University-at-Buffalo-SEDS/DAQ-Board/docs/analog-inputs.md

# Analog input map and testing

Source: `Schematic PDF_[No Variations] (2).pdf`, revision A, sheets 1–3 and
7–10. All exposed inputs below are independent, ground-referenced signals.
The existing load-cell connectors P7/P8 remain MCP CH0/CH1, with unchanged
KG1000/KG50 raw calibration coordinates and gain/filter settings.

## Connector map

| Signal | Connector pin | ADC / MCU pin | Telemetry and zero-based index |
|---|---|---|---|
| SAR_IN1 | P9/3 | ADC4 IN1 / PC0 | DAQ_SAR_VOLTAGES[0] |
| SAR_IN2 | P9/4 | ADC4 IN2 / PC1 | DAQ_SAR_VOLTAGES[1] |
| SAR_IN3 | P3/3 | ADC4 IN3 / PC2 | DAQ_SAR_VOLTAGES[2] |
| SAR_IN4 | P3/4 | ADC4 IN4 / PC3 | DAQ_SAR_VOLTAGES[3] |
| SAR_IN5 | P2/3 | ADC1 IN5 / PA0 | DAQ_SAR_VOLTAGES[4] |
| SAR_IN6 | P2/4 | ADC1 IN6 / PA1 | DAQ_SAR_VOLTAGES[5] |
| SAR_IN7 | P1/3 | ADC1 IN7 / PA2 | DAQ_SAR_VOLTAGES[6] |
| SAR_IN8 | P1/4 | ADC1 IN8 / PA3 | DAQ_SAR_VOLTAGES[7] |
| MCP CH2 | P6/3 | MCP3564R CH2 | DAQ_SDADC_VOLTAGES[0] |
| MCP CH3 | P6/4 | MCP3564R CH3 | DAQ_SDADC_VOLTAGES[1] |
| MCP CH4 | P5/3 | MCP3564R CH4 | DAQ_SDADC_VOLTAGES[2] |
| MCP CH5 | P5/4 | MCP3564R CH5 | DAQ_SDADC_VOLTAGES[3] |
| HVAIN1 | P4/3 | MCP3564R CH6, 10k/1k divider | DAQ_SDADC_VOLTAGES[4] |
| HVAIN2 | P4/4 | MCP3564R CH7, 10k/1k divider | DAQ_SDADC_VOLTAGES[5] |
| ISENSE1_OUT | J7 current path, U3 output | ADC1 IN12 / PA7 | DAQ_CURRENT_SENSE[0] volts, [2] amps |
| ISENSE2_OUT | J8 current path, U4 output | ADC1 IN11 / PA6 | DAQ_CURRENT_SENSE[1] volts, [3] amps |
| VMON | internal R57/R69 | ADC1 IN17 / PB2 | DAQ_POWER_MONITOR[0] ADC volts, [2] VMAIN volts |
| IMON | internal U14/R60/R56 | ADC1 IN16 / PB1 | DAQ_POWER_MONITOR[1] ADC volts, [3] input amps |

Architecture labels call PC2/PC3 ADC1_IN3/4; the same physical pins also support
ADC4_IN3/4, used here with PC0/PC1. P1/P2/P3/P9 use unity-gain buffers, not
pairwise differential measurement. Their pins 1/6 supply +3V3A, pins 2/5 are
GND. P4 pins 1/6 supply +3V3A/+12VA respectively; P5/P6 pins 1/6 supply +VREF_BUF/+3V3A.
These are supply outputs, not analog input pins. Input clamp rails and connector
supply voltages do not specify a calibrated measurement range.

## Nominal conversion and acquisition

STM32 ADC1 uses single-ended 14-bit conversion; ADC4 uses 12-bit conversion.
Both use nominal VDDA=3.3 V. ADC4 explicitly clears the previous channel selection
before each conversion: HAL channel selection is additive, so leaving all four
selected and restarting after the first conversion can repeat IN1.

MCP CH2–5 report ADC-pin volts (`code * 2.4 / 8388608`); CH6/7 report connector
volts after multiplying by 11. No load-cell thermal compensation, smoothing or
mass calibration is applied to these channels. Raw SD records retain ADC-pin
volts and code; their `calibrated_value` column contains nominal connector volts.

TMCS1108A1B estimates use `(Vout - 3.3/2) / 0.05` amperes. PC5 drives Q1's gate
low to power both sensors. VMAIN uses `VMON * 11`. LM74202 input current uses
`IMON / (78.28e-6 * 6200)` amperes; below about 50 mA the monitor offset dominates.
These estimates require hardware validation/calibration; output volts are also
provided so later sensor calibration does not require changing the driver.
See [TI TMCS1108-Q1](https://www.ti.com/lit/gpn/TMCS1108-Q1),
[TI LM74202-Q1](https://www.ti.com/lit/ds/symlink/lm74202-q1.pdf), and
[STM32U585 pin mapping](https://www.st.com/resource/en/datasheet/stm32u585zi.pdf).
The old ADC1 code incorrectly subtracted SAR5–6, SAR7–8 and ISENSE2–1 and
misidentified them as supply voltage/current and auxiliary voltage. Old readings
of those diagnostic fields are not comparable to the corrected measurements.

Internal ADC inputs are sampled once per `DAQ_ANALOG_REPORT_PERIOD_MS` (100 ms),
not on every 2 ms load-cell service iteration. Per-channel read failure produces
NaN and does not prevent the other inputs or external ADC queue from being read.
The current sensor's unconnected *current path* should nominally report near
zero amps; open voltage inputs may float and are not detected as disconnected.

MCP CH0/CH1 and the assigned chamber input (default CH6) form the normal scan.
Every 100 ms, a bounded CH2–7 pass excludes that fast pressure channel, uses the
same reference, gain, clock and OSR, then restores the normal scan. Temperature has a
separate, higher-priority slow-clock measurement. The auxiliary pass shares
conversion time with load cells; their achieved rate must be measured again.
A 25 ms auxiliary timeout restores the normal scan if a conversion is missing.
`MCP3564R_AUX_SCAN` in `mcp3564r_board_config.h` can mask individual CH2–7 inputs
or be zero to disable the auxiliary pass. Unread/stale fields report NaN after
300 ms. The unchanged load-cell raw encoding preserves saved calibrations.

Each drained MCP sample is offered to SD with its channel and original timestamp:
CH0 `mcp3564r_raw`, CH1 `kg50_raw`, CH2–7 `mcp3564r_chN_raw`. Internal analog
voltage/current rows are captured at 10 Hz. A bounded, time-sliced worker
publishes analog telemetry and formats these rows with the original capture
timestamp, outside the load-cell acquisition loop. `g_daq_analog_work_drop_count`
counts snapshots rejected if all three worker slots are occupied. The worker
shares the acquisition/SD priority with a 1 ms slice, so a continuously busy SD
writer cannot starve analog reporting. Queue/write diagnostics
still determine whether storage kept up; this feature does not establish a
lossless 12 kHz recording qualification.

### SD backlog policy

The writer retains the same thirteen CSV fields and nine-digit binary32 values.
Its raw formatter avoids general `snprintf`, caches unchanged temperature text,
and reuses identical raw/calibrated text. No sample times or measurements are
cached in place of newer samples.

Small acquisition batches append into a queued thirty-two-record tail only when
calibration, launch session and route epoch match. The writer atomically takes
ownership before reading a batch; acquisition cannot modify that batch afterward.
Every record retains its raw code, captured clock, sequence and calibration.

When more than 256 accepted raw records remain unwritten (roughly 100 ms at the
observed acquisition rate), or raw free space falls below 25%, optional ADC
channels are shed before the
loadcells (CH0, CH1/P6 CH9) or configured chamber-pressure channel. Optional
telemetry is also shed before formatting if raw storage is pressured or less
than 75% of its row pool remains free. Loadcell mirrors, including the selected
P6 input, bypass this optional gate. The separate valve-pressure queue holds
800 samples, 3.2 seconds at 250 samples/s. Required numeric telemetry uses
compact batches of captured values and clocks, sharing calibration/session
metadata and expanding to unchanged CSV in the writer. The line pool is 49 KiB;
the reclaimed RAM funds a 321 KiB raw pool (62 and 332 KiB before 24 KiB moved to
sector-aligned log staging; see sd-write-path.md). Larger raw allocations retain the
original sixteen-record service turn so other SD streams are not starved.

Native queue tests save all 50,000 protected raw samples at 2,500 samples/s
and all 13,000 numeric telemetry rows at 500 rows/s through three-second stalls
12 seconds apart, with unstalled drain capacities of 3,500 and 1,000 rows/s
respectively. These tests verify finite burst reserve, not unlimited card
throughput; sustained production above drain capacity still exhausts RAM.
Physical card qualification must independently show zero protected drops.

`g_sd_raw_essential_records_dropped` and
`g_sd_essential_telemetry_dropped` must remain zero during qualification.
`g_sd_raw_optional_records_dropped` and `g_sd_optional_telemetry_dropped`
identify optional shedding, while `g_sd_raw_records_coalesced` shows batching.
Card errors and outages can still exhaust finite buffers; written/flushed/drop
counters distinguish acquisition admission from durable media completion.

Contiguous FAT preallocation is **off by default** in
`Core/Inc/sd_storage_config.h` (`DAQ_SD_PREALLOCATE_ENABLE=0`). Hardware
qualification measured a 3.7-second allocation stall and increased protected
sample loss; ordinary FileX writes retain the compact queues and early optional
shedding without that scan. Experimental opt-in uses
`DAQ_SD_PREALLOCATE_ENABLE=1`. In that mode, each open log reserves FAT clusters
in 2 MiB increments, topping up below
256 KiB only while the raw backlog is low, unless the next write already needs
space. File size remains the actual CSV length. The ordinary once-per-second
media flush and both FAT copies remain enabled. A normal close uses
`fx_file_truncate_release` to free the unwritten reserve. An unclean power loss
can leave up to 2.25 MiB of reserved tail per open log, plus cluster rounding,
until filesystem repair;
existing logs are not rewritten or automatically formatted. A fragmented-card
`FX_NO_MORE_SPACE` disables that file's reservation hint and leaves normal writes
enabled. Genuine I/O errors preserve buffered data for retry. Preallocation
attempts/fallbacks/errors and its maximum observed latency have separate counters.
FileX searches for a consecutive FAT chain, so reservation byte size is bounded
but its search time on a nearly full/fragmented card is not a real-time guarantee.

## SD health and explicit retry

DAQ retains the existing `BOARD_HEALTH` v1 static24-word report. A separate
`DAQ_SD_HEALTH` static8-word UInt32 report is queued every five seconds so old
relay schemas do not conflict with a changed message shape.

| Word | Meaning |
| --- | --- |
| 0 | Flags: bit0 services initialized, bit1 ready, bit2 launch logging finished, bit3 manual retry queued/in progress |
| 1 | Age since an actually successful sector-write chunk, milliseconds |
| 2 | Age since an actually successful FileX media flush, milliseconds |
| 3 | SD initialization stage |
| 4 | Initialization retry count |
| 5 | Last accepted manual retry token |
| 6 | Last completed manual retry token |
| 7 | Initialization failure count |

Ages use the extended monotonic HAL millisecond clock, not UTC. `UINT32_MAX`
means no successful write/flush has been observed; very old valid ages saturate
at `UINT32_MAX-1`. Readiness alone is not evidence of writing. Existing raw
written/flushed/drop counters remain in `BOARD_HEALTH`; GroundStation combines
these with fresh companion status and separately marks stale/unavailable health.

`DAQ_SD_RETRY` is a direct static UInt32 command to `SD_CARD` (endpoint100), with
unordered reliable delivery. Its canonical type ID is24116261; companion health
ID is92486907. Only exact `GS`/`RRLS` senders with one nonzero little-endian token
are accepted. The handler performs no I/O: it only queues the token. Repeated
recent tokens are deduplicated (eight-token window); another new token while a
retry is pending/in progress is refused for transport retry. This is not a
managed variable and must never be replayed as saved settings.

The storage writer consumes a retry only between operations. It reinitializes
transport and resumes the same CID/geometry while preserving open FileX state,
pending bytes, launch cutoff and counters. A replacement card is refused.
A manual retry never permits formatting, including subsequent automatic retries
in that boot; invalid or unmarked unmounted media fail closed. Completion means
one initialization attempt finished, **not** that the card is ready or writing.
An unready card can take tens of seconds to finish HAL initialization, while
acquisition and networking continue independently. These paths have host fault
regressions and ARM builds; physical qualification is still required.

## Network and GroundStation

Loadcell report windows and SD mirrors default to **250 records/s each**, with
a 4 ms downsampling window. `Core/Inc/daq_network_config.h` sets an independent
**100-packet/s aggregate live sensor cap** and editable stream weights. Both
loadcells have equal top priority: 40 packets/s each at default weights; the
five auxiliary streams each get 4 packets/s. One latest NETWORK sample per
stream is coalesced between sends. ADC acquisition, raw/calibrated SD records
and loadcell SD mirrors are unchanged. `--network-rate-hz` optionally overrides
the total; normal builds use the header. Heartbeats/ACKs/control/discovery are
outside this sensor scheduler.

`cmake -S . -B build/Release_Script -DDAQ_BROADCAST_RATE_HZ=500` enables an
explicit 500 Hz-per-channel test; use `250` to restore the normal setting.

Loadcell and temperature publication now runs in a separate worker with 16
bounded report slots. Acquisition submits without waiting. Reports retain the
captured values, calibration and time; network timestamps subtract queue age.
`g_daq_report_drop_count` counts rejected work items (which may contain both
loadcells), and `g_daq_report_max_age_ms` records the maximum worker delay.
These counters are independent of raw ADC/SD loss counters. No new hardware
throughput qualification has been performed for this worker.

Append-only SEDSnet IDs (existing IDs unchanged):

| ID | Type | float32 count | Order |
|---|---|---|---|
| 143 | DAQ_SAR_VOLTAGES | 8 | SAR1..8 volts |
| 144 | DAQ_SDADC_VOLTAGES | 6 | CH2,3,4,5,HVAIN1,HVAIN2 volts |
| 145 | DAQ_CURRENT_SENSE | 4 | J7 V, J8 V, J7 A, J8 A |
| 146 | DAQ_POWER_MONITOR | 4 | VMON V, IMON V, VMAIN V, input A |

All four target GroundStation, best-effort at 10 Hz, with explicit DAQ CAN routes.
They add approximately 40 messages/s and 880 payload bytes/s before framing.
GroundStation's matching runtime schema advertises the GROUND_STATION endpoint;
its default, test-fire and HITL layouts have a DAQ analog tab with explicitly
bound DAQ chart series and separate voltage/current axes, including both load cells.
The DAQ publishes its schema at startup; existing gateways merge the new type
definitions at runtime. Routine discovery polling alone does not send schema.
A failed initial announcement is retried once per second until queued successfully;
After discovering a peer, the board also requests its schema once, so restarting
a board does not depend on catching the peer's earlier startup advertisement.
Failed submissions retry at one-second intervals; successful submissions stop
repeating. This is not an acknowledgment that every peer has merged the schema.

Rebuild/reflash DAQ and rebuild/restart GroundStation to activate. The gateway
does not need the new analog definitions compiled in. Confirm the installed bridge's throughput and
unknown-type forwarding during bench testing. For a future sensor, choose its
existing type/index in the layout and add the physical-unit calibration in GS;
changing the fixed payload order requires a coordinated schema update.

Bench check with a known voltage below the input's documented limits, applied
to one input at a time. Verify the matching chart changes independently and its
SD channel label is correct, then test zero/known current on J7/J8 and compare
VMON to a meter. Check acquisition, queue-loss and SD-write counters while all
streams are active; host mocks cannot verify board wiring, reference accuracy,
physical sensor response or real SD/network throughput.

## Validation status

Host tests cover independent channel selection, nominal scaling, auxiliary scan
restore/timeout, stale values, wire/layout mappings and queued snapshot ownership.
The production release/factory build succeeds. The local simulator rebuilt from
FirmwareSimulator `a916318` reports both load-cell streams, 40 analog packets/s,
and no analog-queue, SD-row or raw-batch drops in the two-second diagnostic run.
The unchanged strict zero-overrun check still fails on one startup overrun;
the unchanged baseline firmware has three overruns under the same simulator.
The diagnostic run is not a full-suite qualification: memory/network soak stages
were not reached, and the pinned public v0.4.12 image was unavailable. Bench
validation remains required, especially for ADC accuracy and sustained throughput.

## Selectable P6 50 kg input

GroundStation's 50 kg selector switches between AMP2/P8 (source 0) and P6
pin 3 (+) minus pin 4 (-), MCP differential scan channel 9 (source 1).
The managed `DAQ_KG50_INPUT` UInt8 packet (ID 147) selects the source.
P6 uses CONFIG2=0xEF, PGA **16x**. Since the gain register is shared, its
single-channel scan alternates with CH0 at unity gain; temperature and auxiliary
scans also restore unity gain. Configuration changes run only in the acquisition
thread with DMA idle, followed by the first-conversion settling interval.
The nominal differential full-scale range is +/-2.4/16 = +/-0.15 V.

P6 reports `DAQ_KG50_SELECTED` (ID 148), two Float32 values `[1, volts]`, at
the same 250 Hz reporting target as normal KG50. Input volts divide ADC codes
by 16; queued samples retain this conversion after the gain changes again.
Gain switching costs conversion time, so achieved rates require hardware
measurement. Source tags let GroundStation reject late packets from another
input. The 1000 kg raw coordinate and saved calibration are unchanged.

GroundStation keeps separate mass/temperature/filter profiles for P8 and P6.
A new P6 profile needs zero/span calibration before it produces kilograms.
SD retains every queued differential conversion as `mcp3564r_ch2_ch3_gain 16_raw`,
including signed ADC code and unfiltered differential input volts; these records
are not converted with the AMP2 calibration. P6 mass calibration is applied by
GroundStation. Auxiliary CH2/CH3 voltage reports remain separate, slow channels.

Gain and scan mapping: Microchip MCP3561/2/4R DS20006391C, CONFIG2 register 8-4
and ADC channel selection table 5-15.
