University-at-Buffalo-SEDS/DAQ-Board/Schematic PDF_[No Variations] (2).pdf

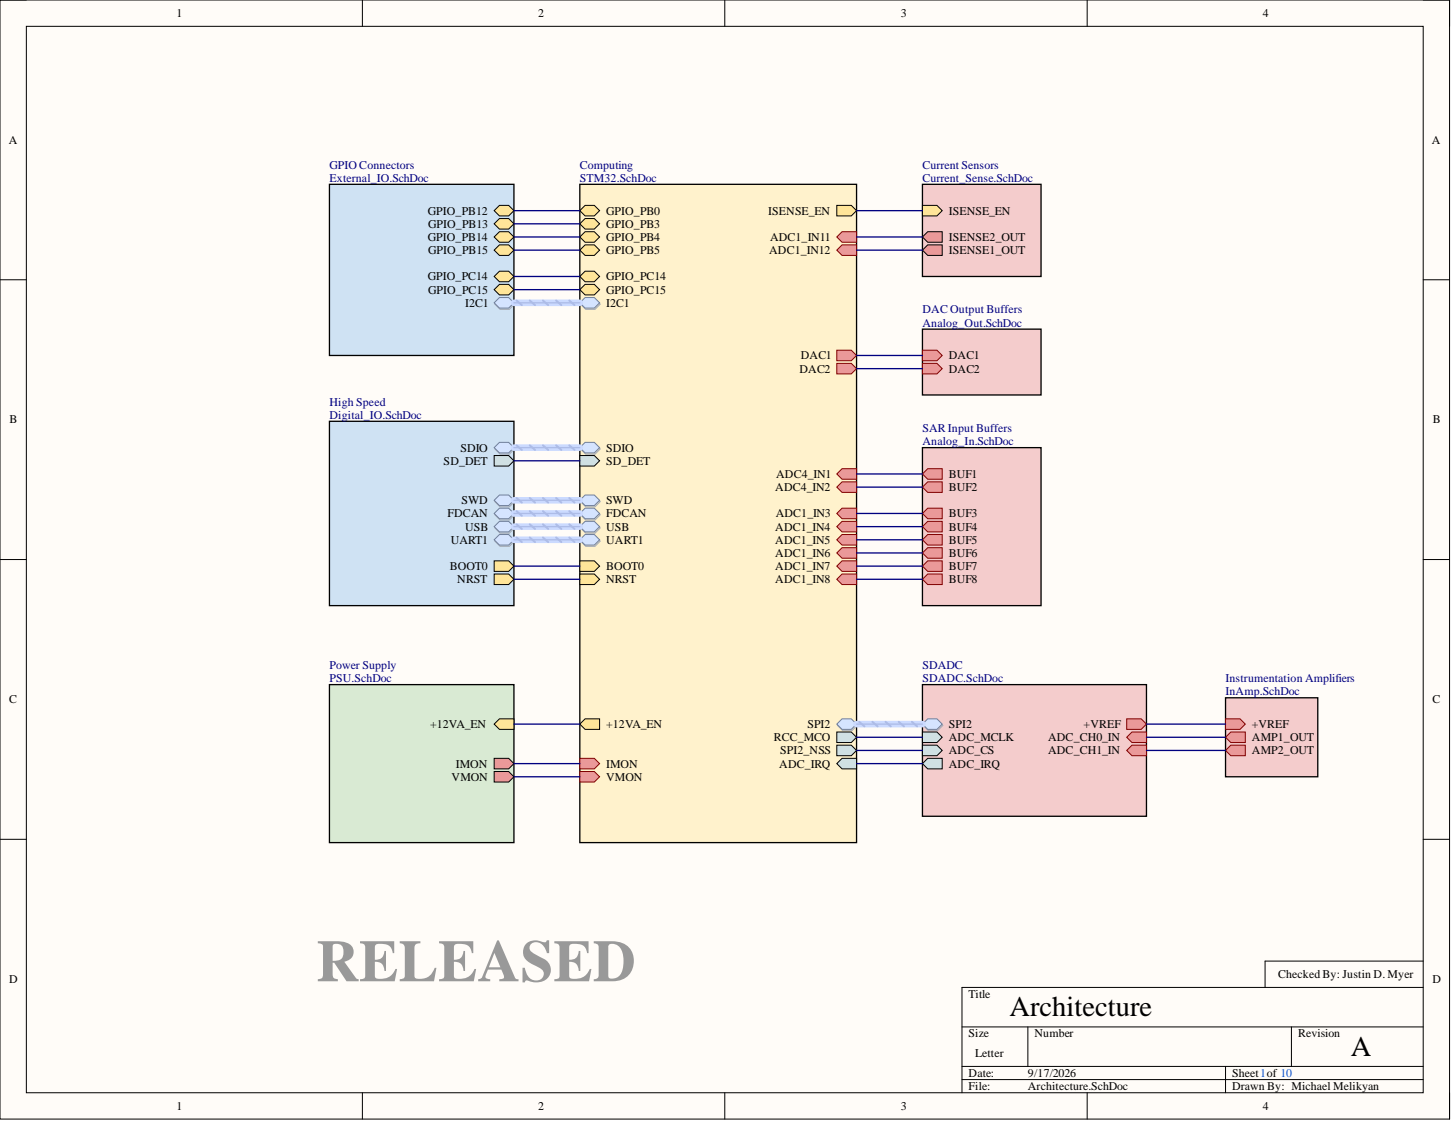
[picture p1: page 1]
Date:; Sheet of; File:; Architecture.SchDoc; Drawn By:; Instrumentation Amplifiers; Current Sensors; High Speed; Power Supply; GPIO Connectors; Michael Melikyan

DAC Output Buffers
Analog_Out.SchDoc

SAR Input Buffers
Analog_In.SchDoc

Checked By: Justin D. Myer

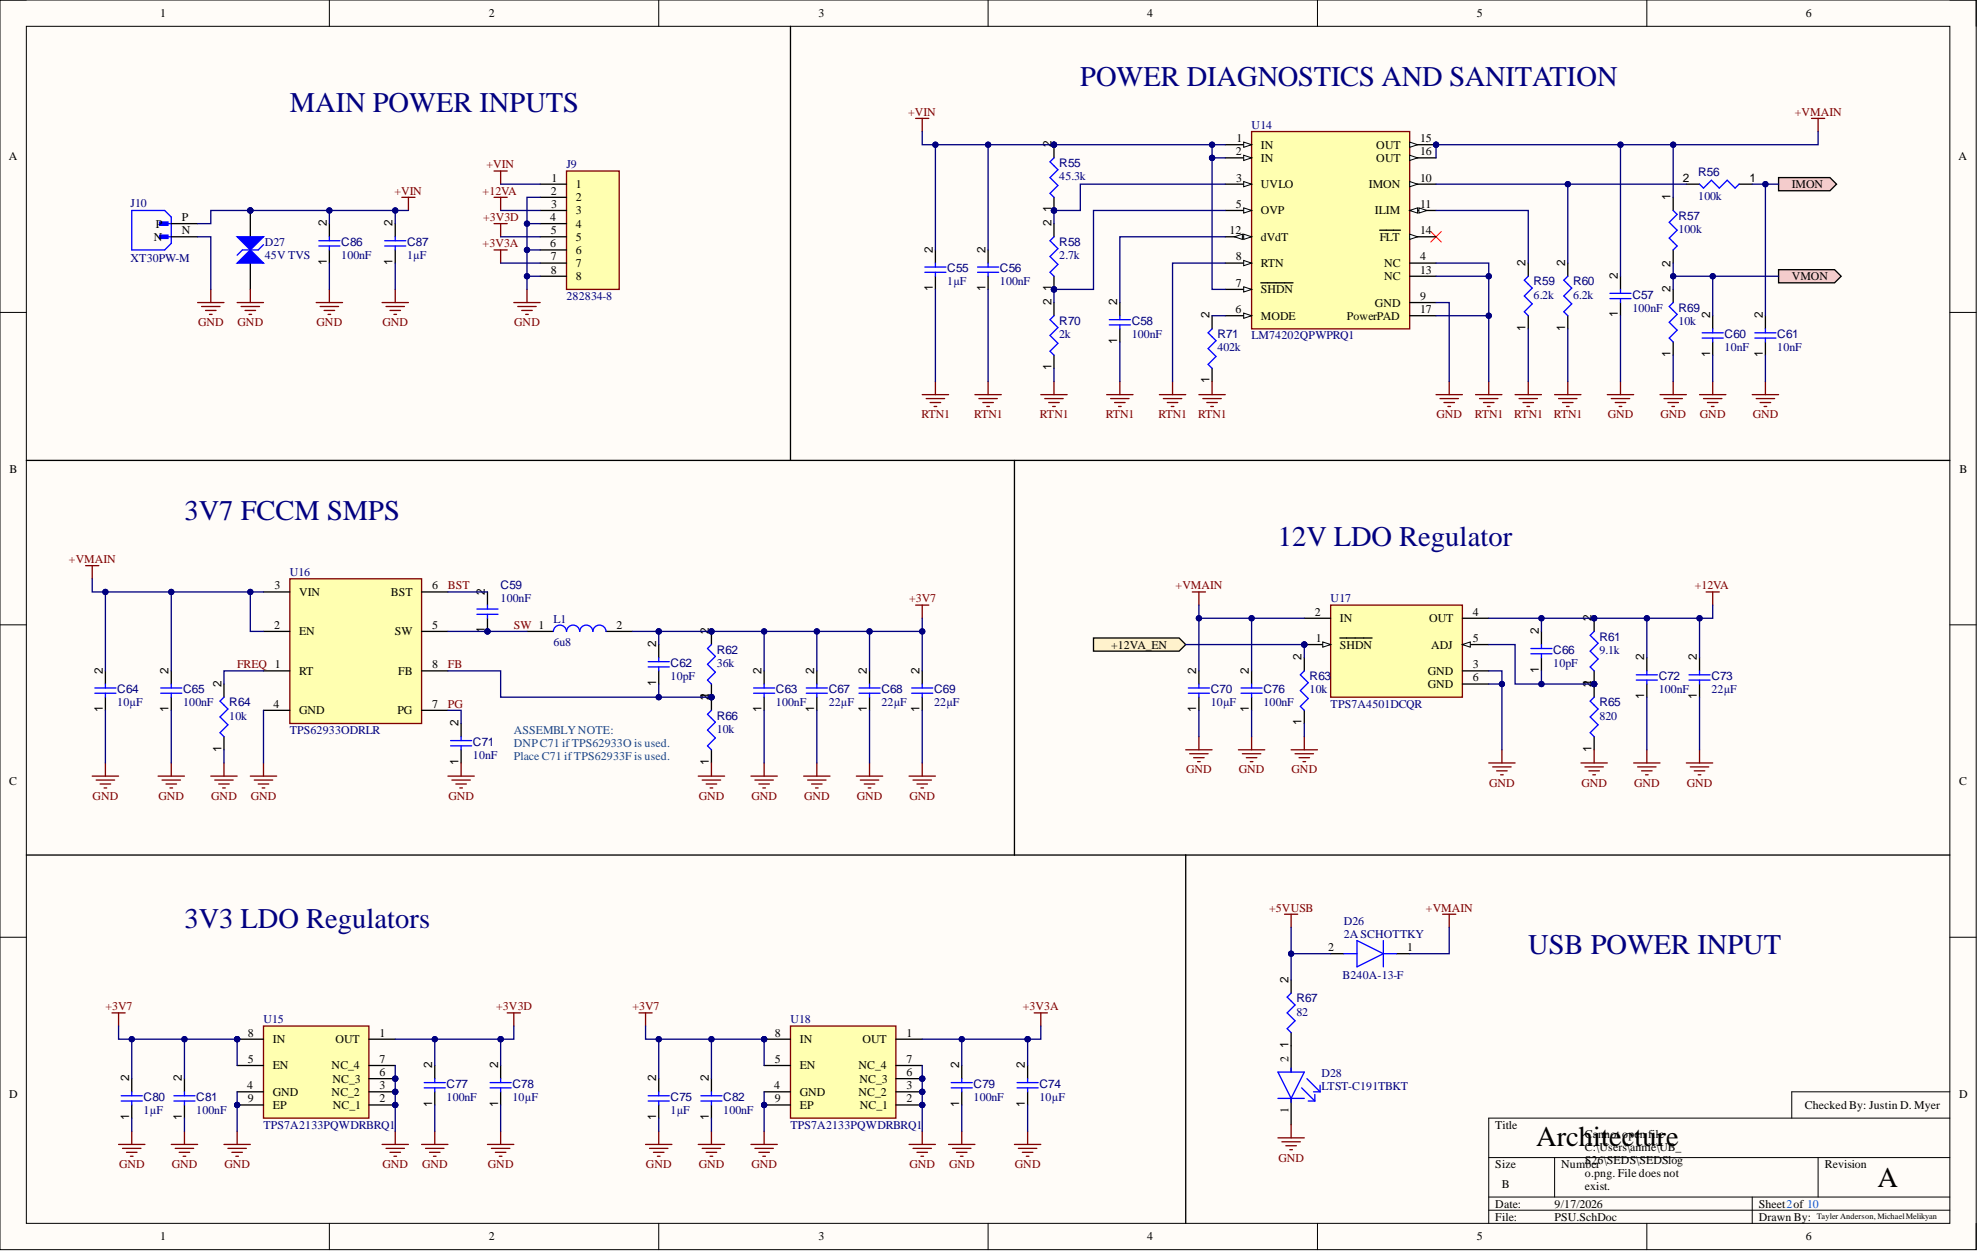
[picture p2: page 2]

POWER DIAGNOSTICS AND SANITATION

GND 4 | 10pF

ASSEMBLY NOTE:
DNPC71 if TPS62933O is used.
Place C71 if TPS62933F is used.

Checked By: Justin D. Myer

Cannot open file
C:\Users\annie\UB_
S26\SEDS\SEDSlog
o.png. File does not
exist.

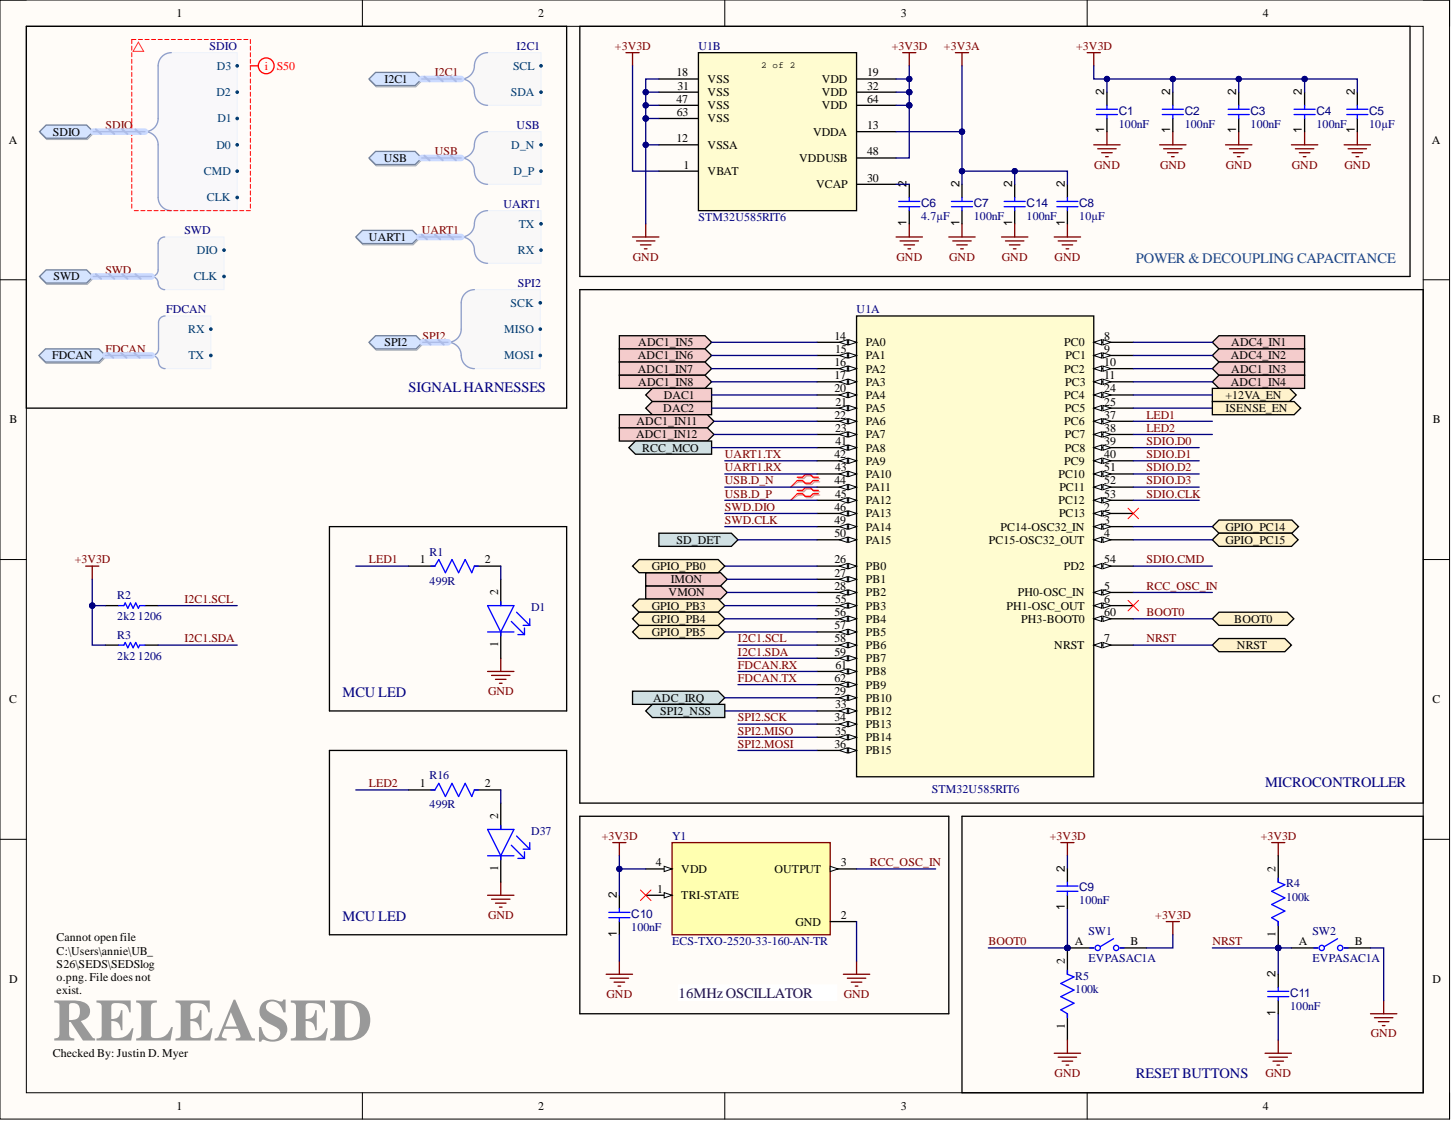
[picture p3: page 3]

4 7 | 6 4
6 3 | 1 3

RELEASED Checked By: Justin D. Myer

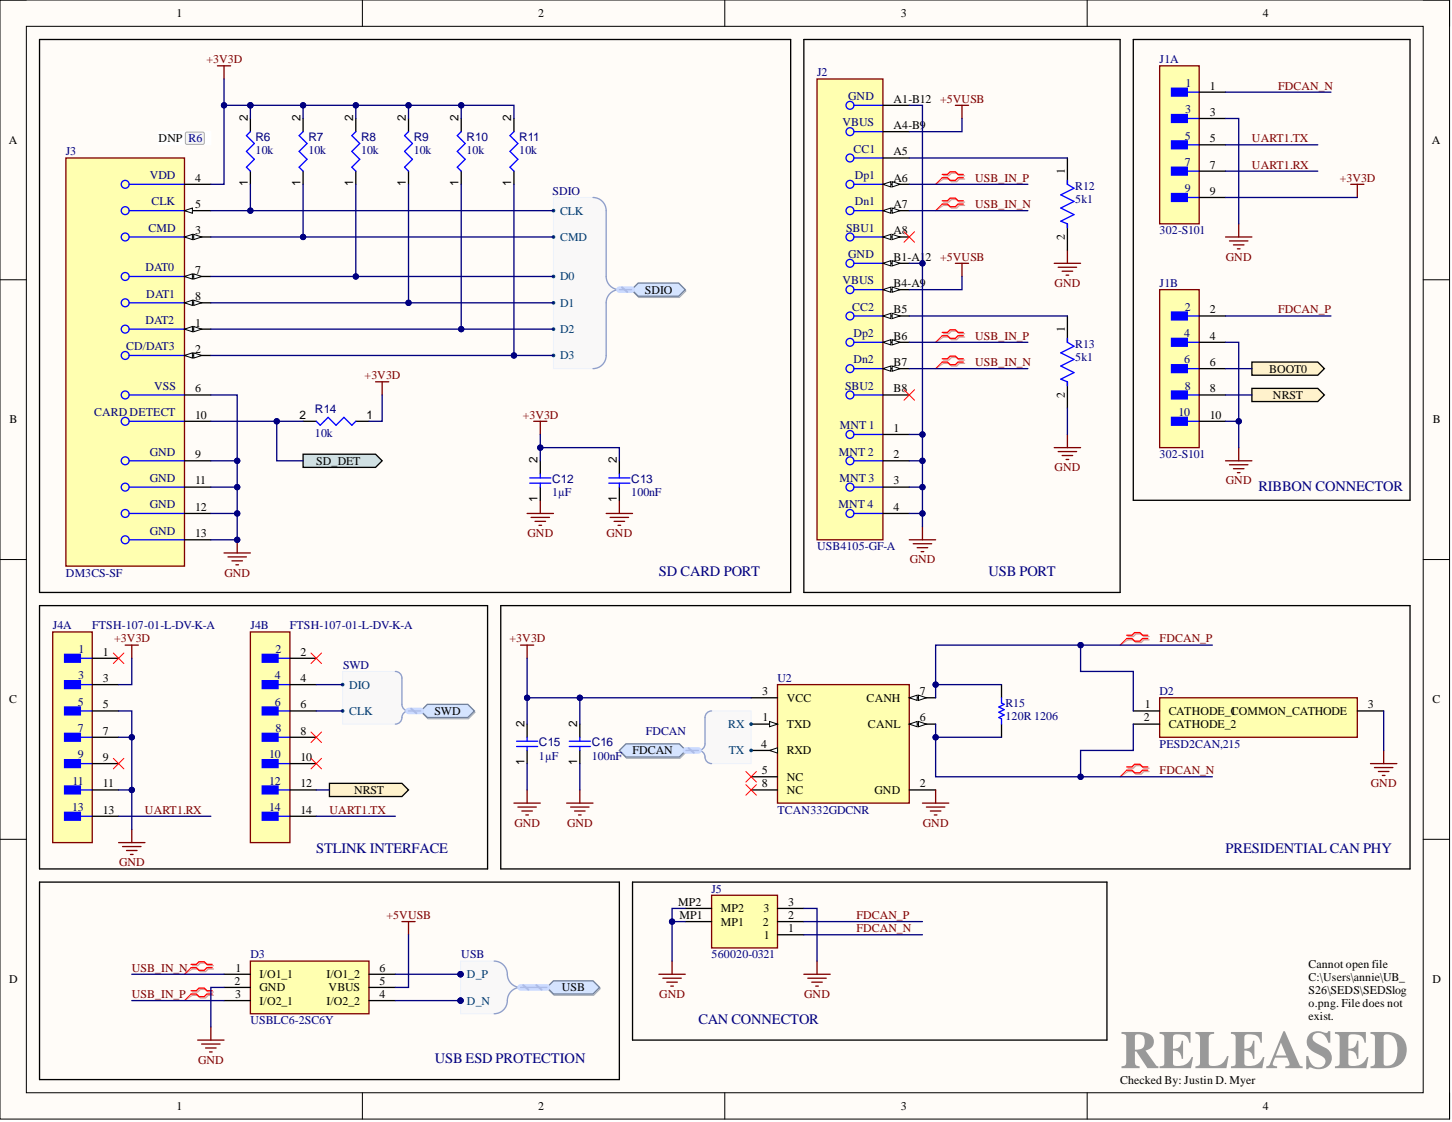
[picture p4: page 4]

Cannot open file
C:\Users\annie\UB_
S26\SEDS\SEDSlog
o.png. File does not
exist.

RELEASED Checked By: Justin D. Myer

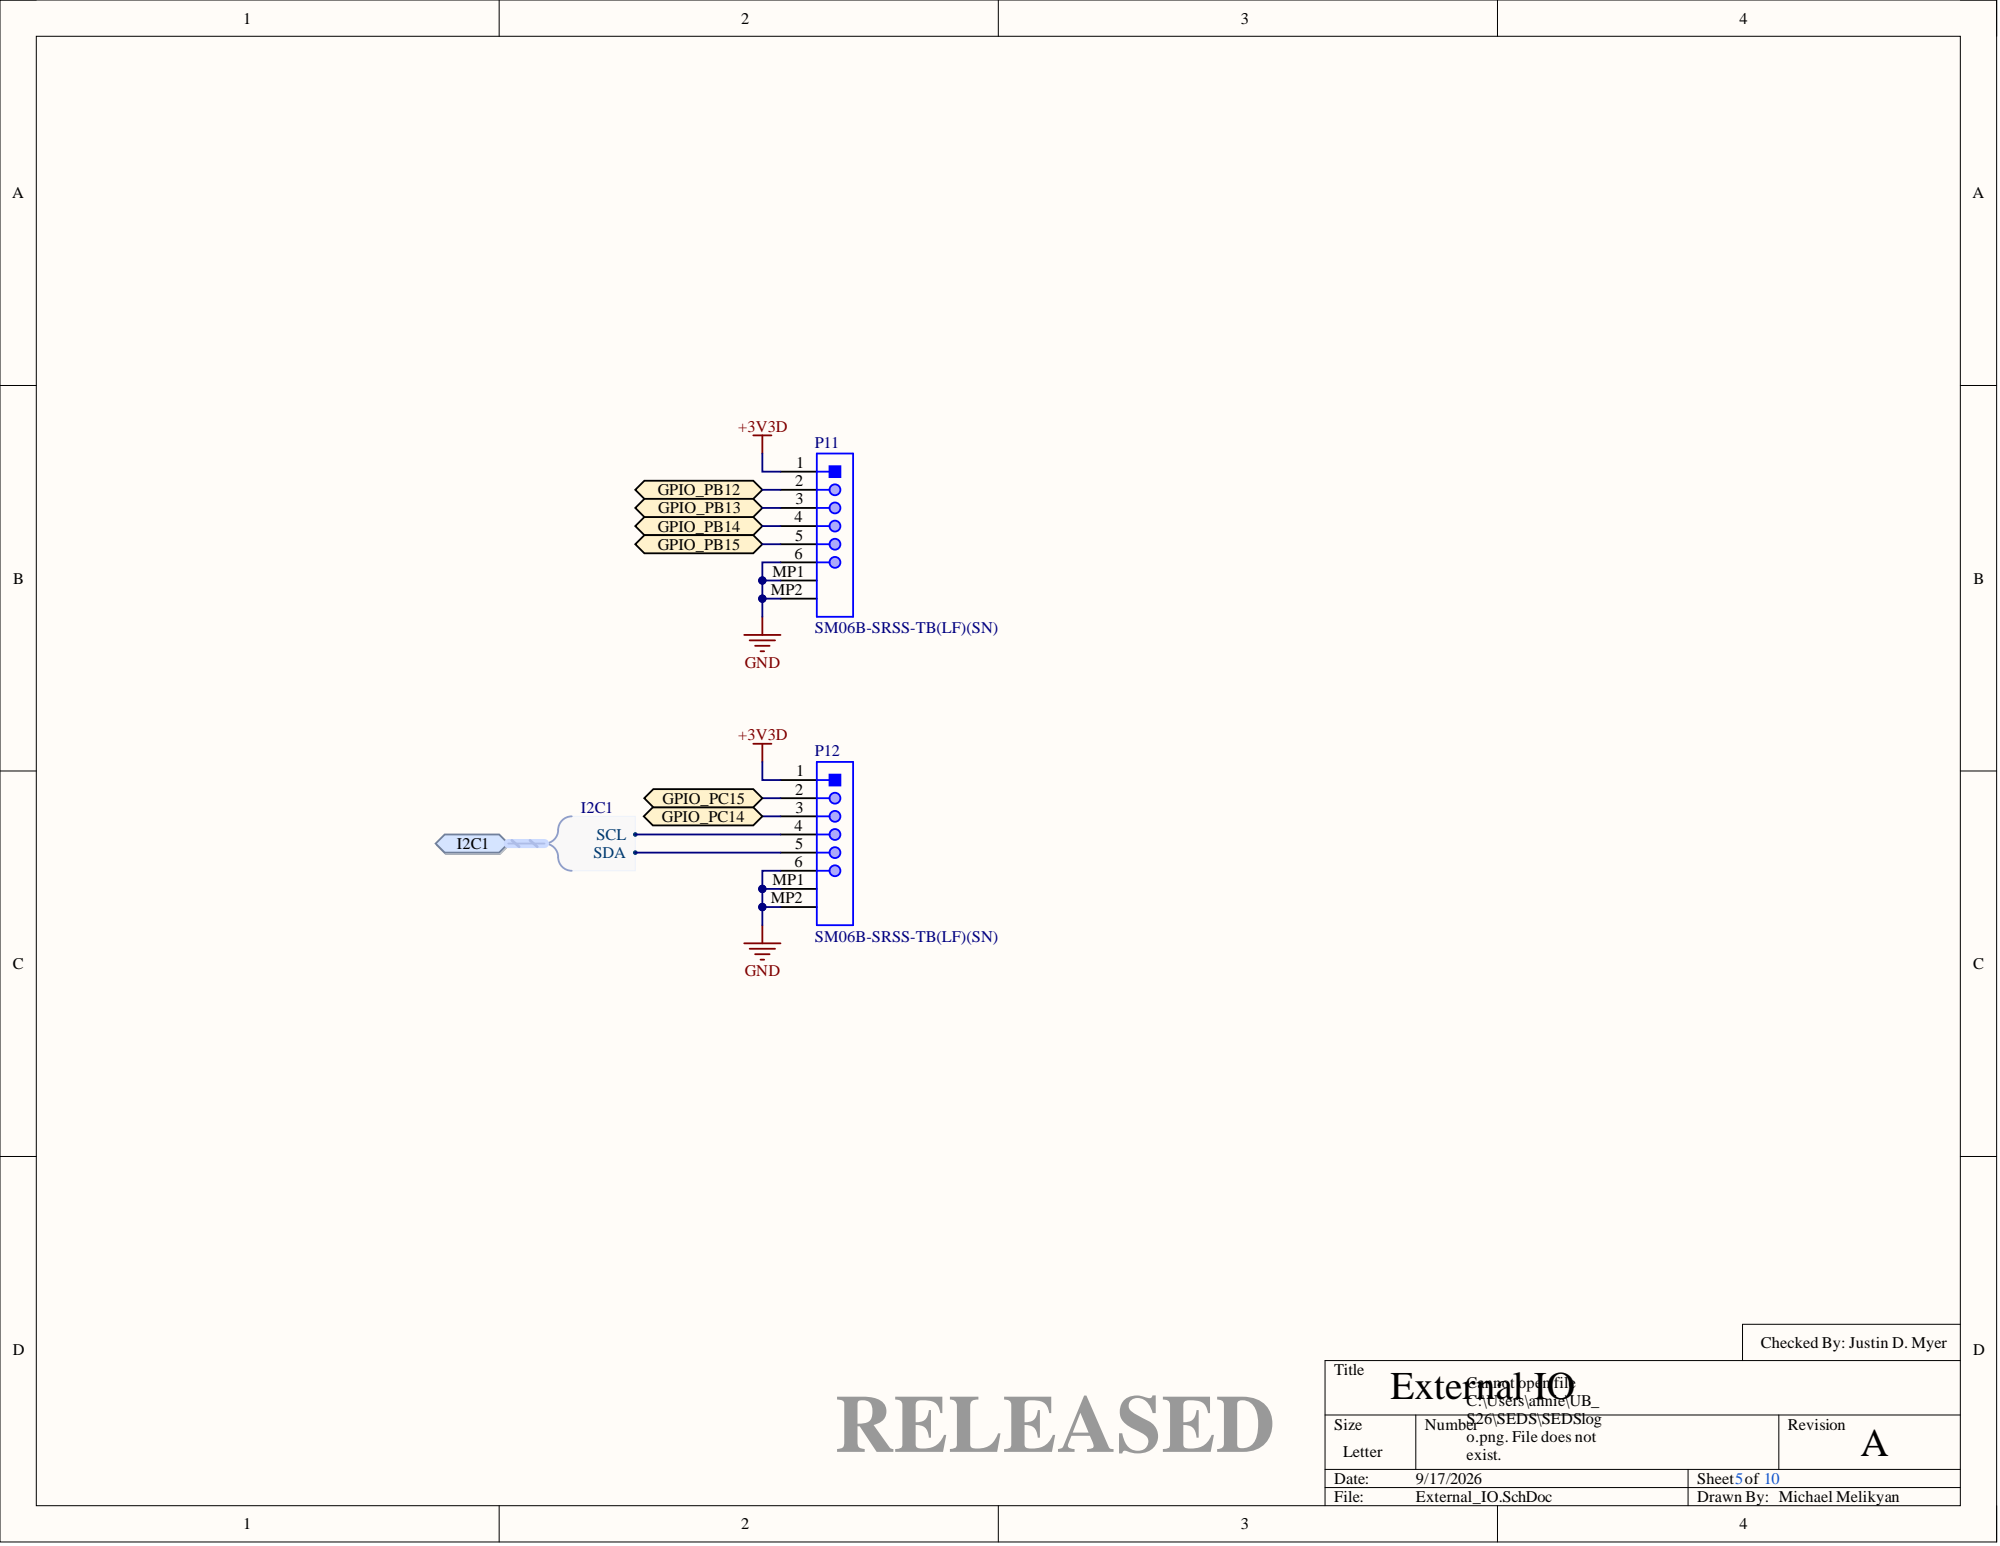
[picture p5: page 5]
File:; External_IO.SchDoc; Drawn By:; External IO; Michael Melikyan; POGPIO0PB12 PIP1102 POGPIO0PB13 PIP1103 POGPIO0PB14 PIP1104 POGPIO0PB15 PIP1105; POGPIO0PC14 PIP1203; POGPIO0PC15 PIP1202; POI2C1OI2C10SCL POI2C10SDA

MP1 | PIP110MP1
MP2

PIP110MP2
SM06B-SRSS-TB(LF)(SN)

MP1 | PIP120MP1

PIP120MP2

Checked By: Justin D. Myer

Cannot open file
C:\Users\annie\UB_

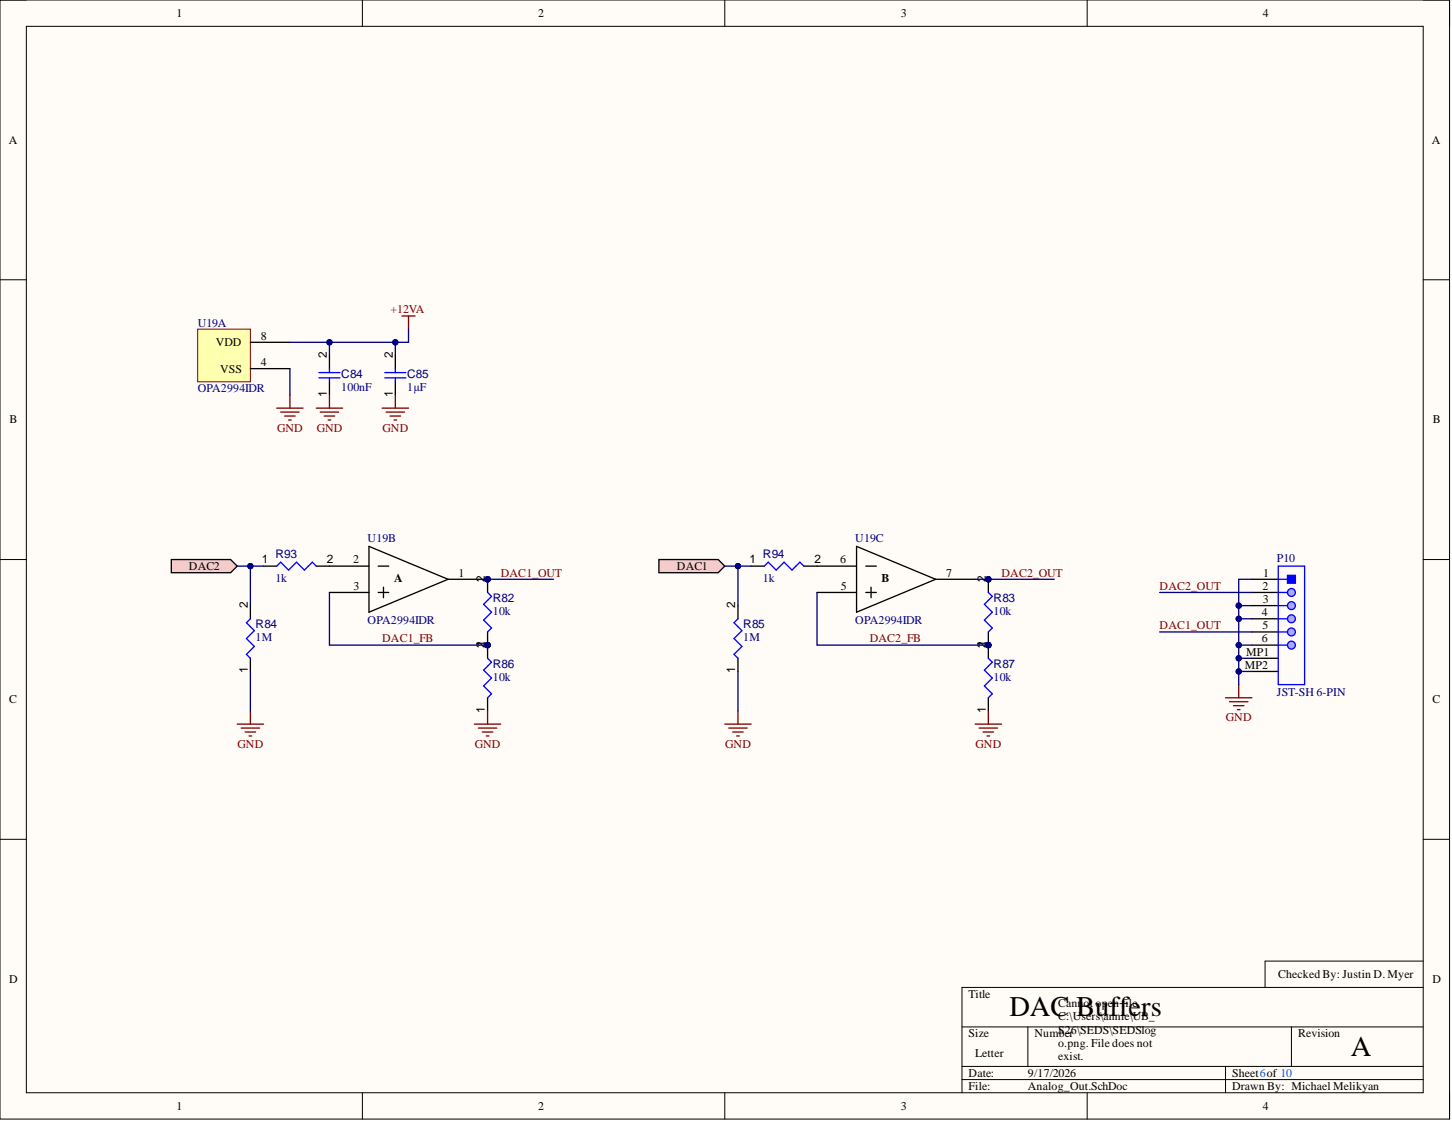
[picture p6: page 6]

Checked By: Justin D. Myer

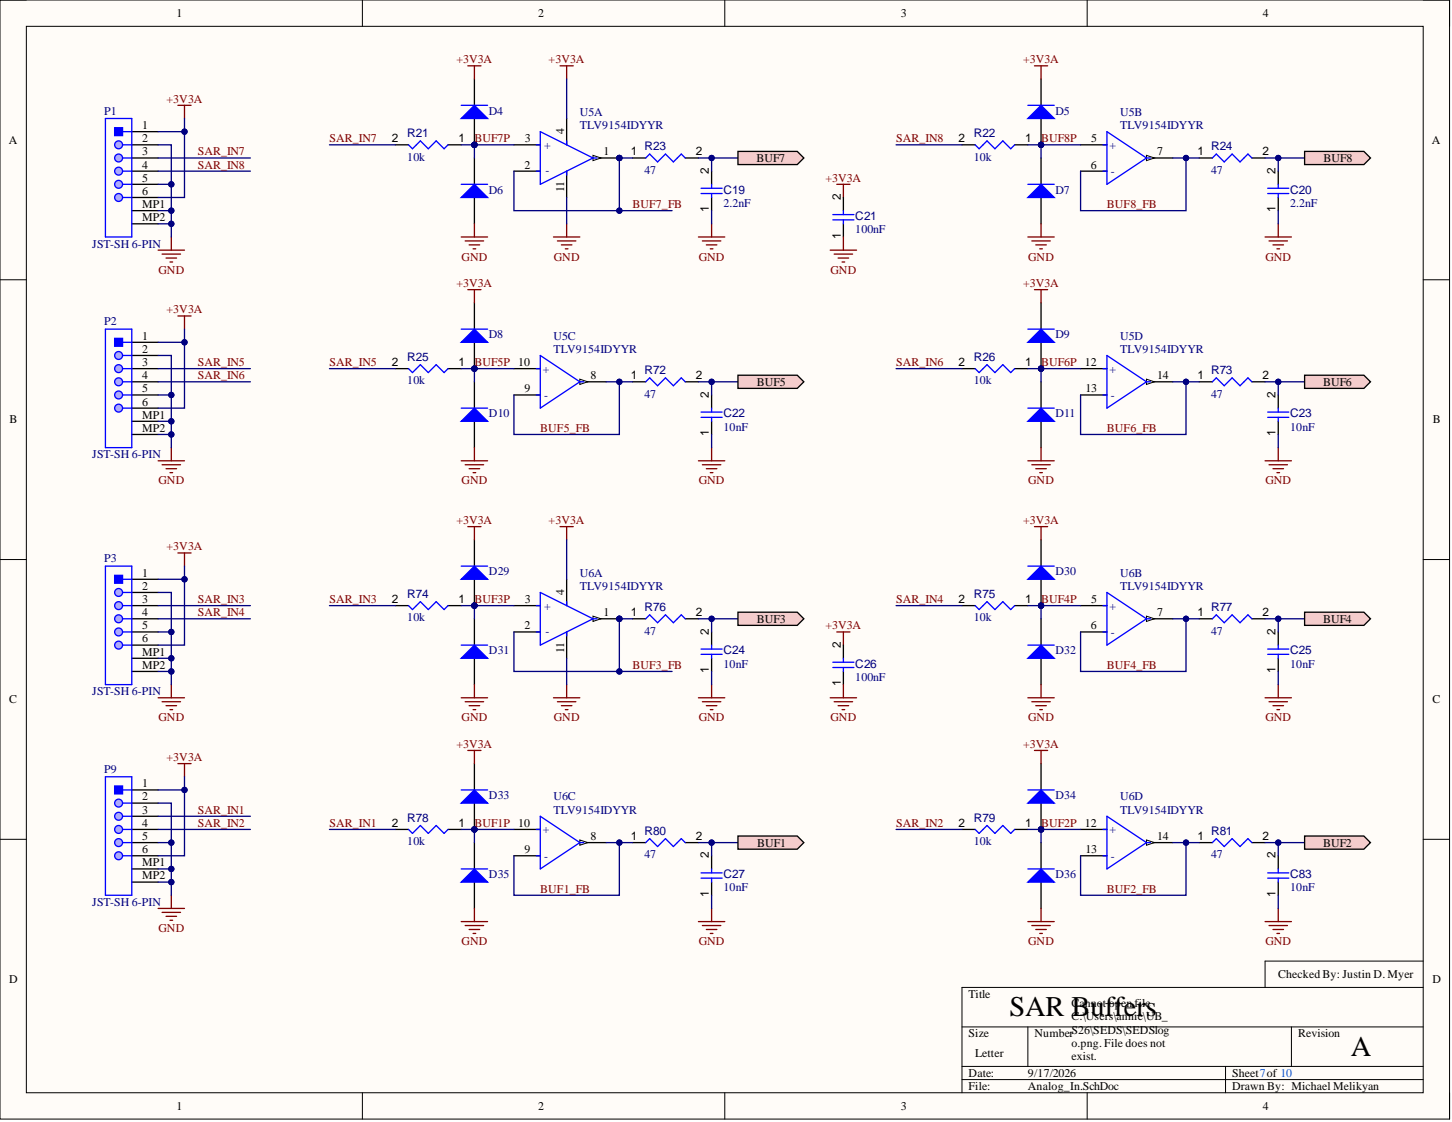
[picture p7: page 7]
9 SAR_IN1; SAR Buffers; Michael Mel; Checked By; D. Myer; pen fi

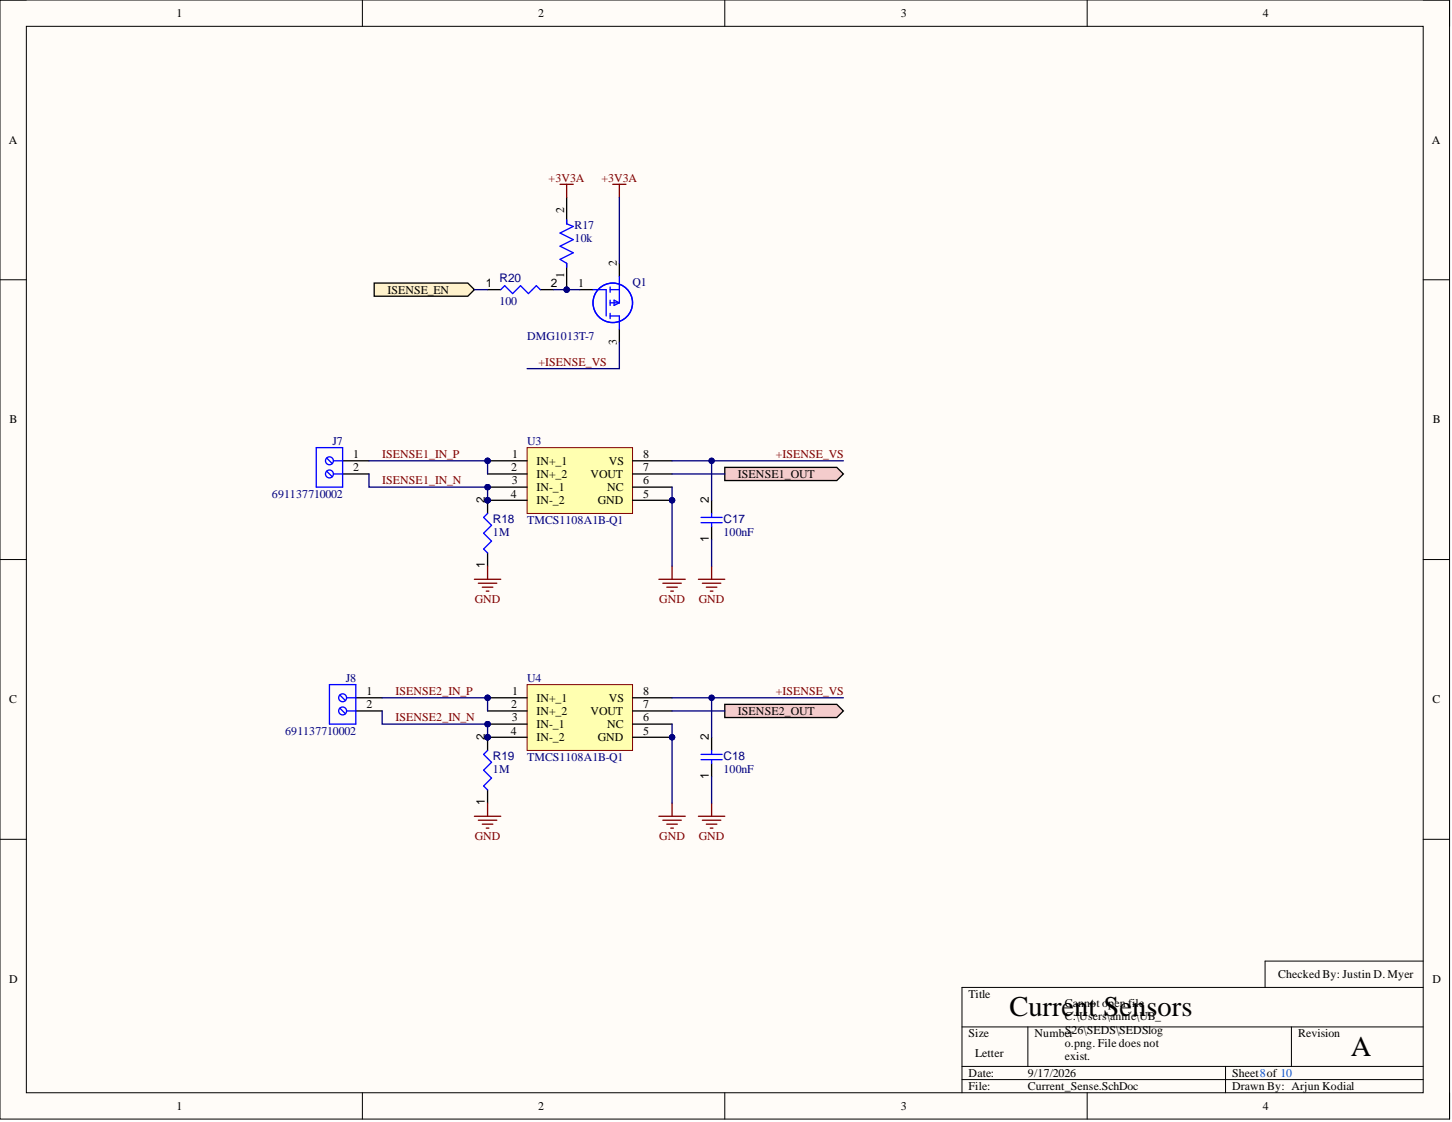
[picture p8: page 8]

2 | | IN+_2 2
ISENSE2_IN_N | IN-_1 3

Checked By: Justin D. Myer

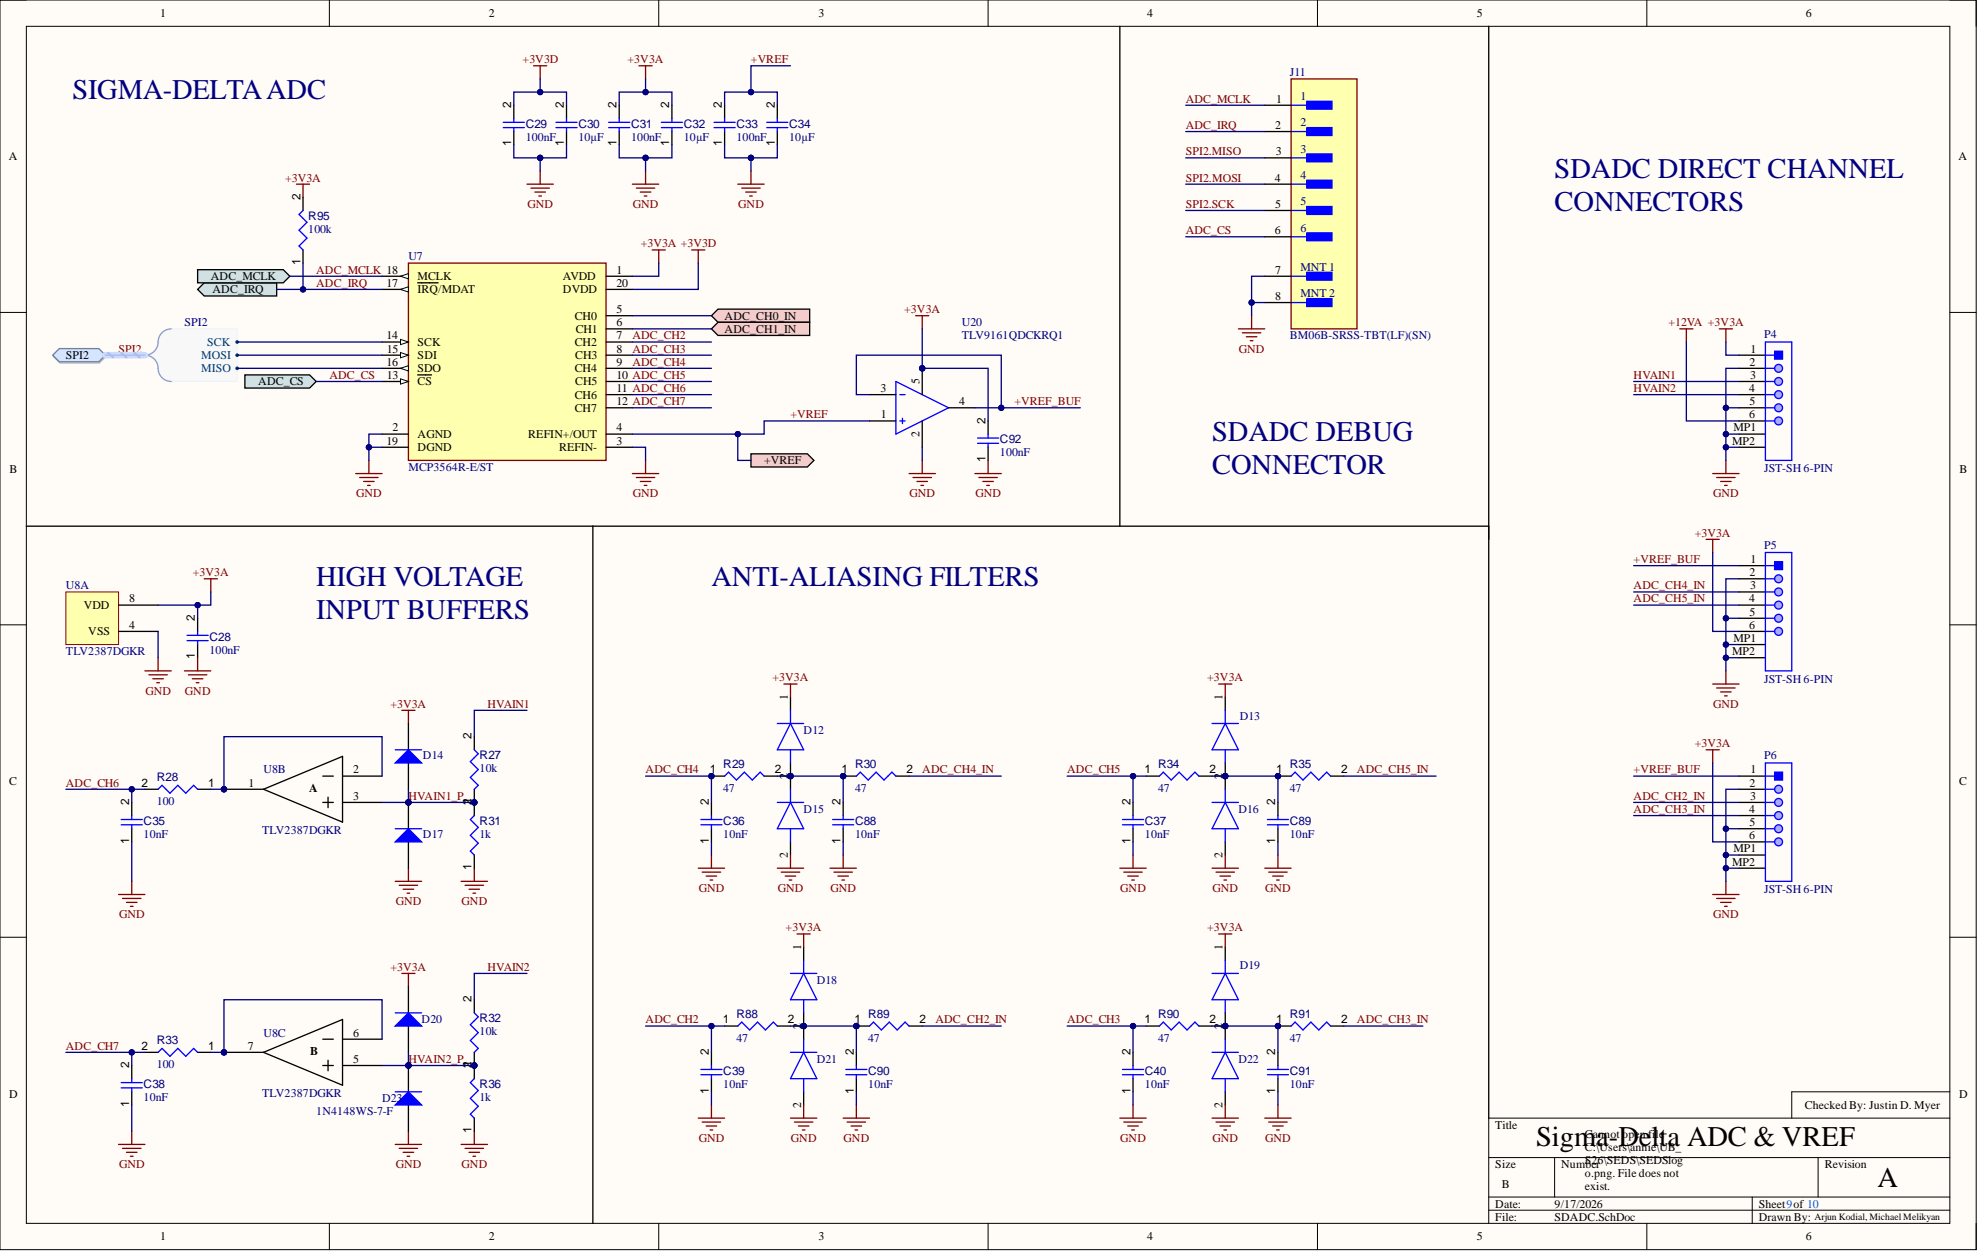
[picture p9: page 9]

BM06B-SRSS-TBT(LF)(SN)

MP1

MP2

Checked By: Justin D. Myer

Title
Sigma-Delta ADC & VREF

Arjun Kodial, Michael Melikyan

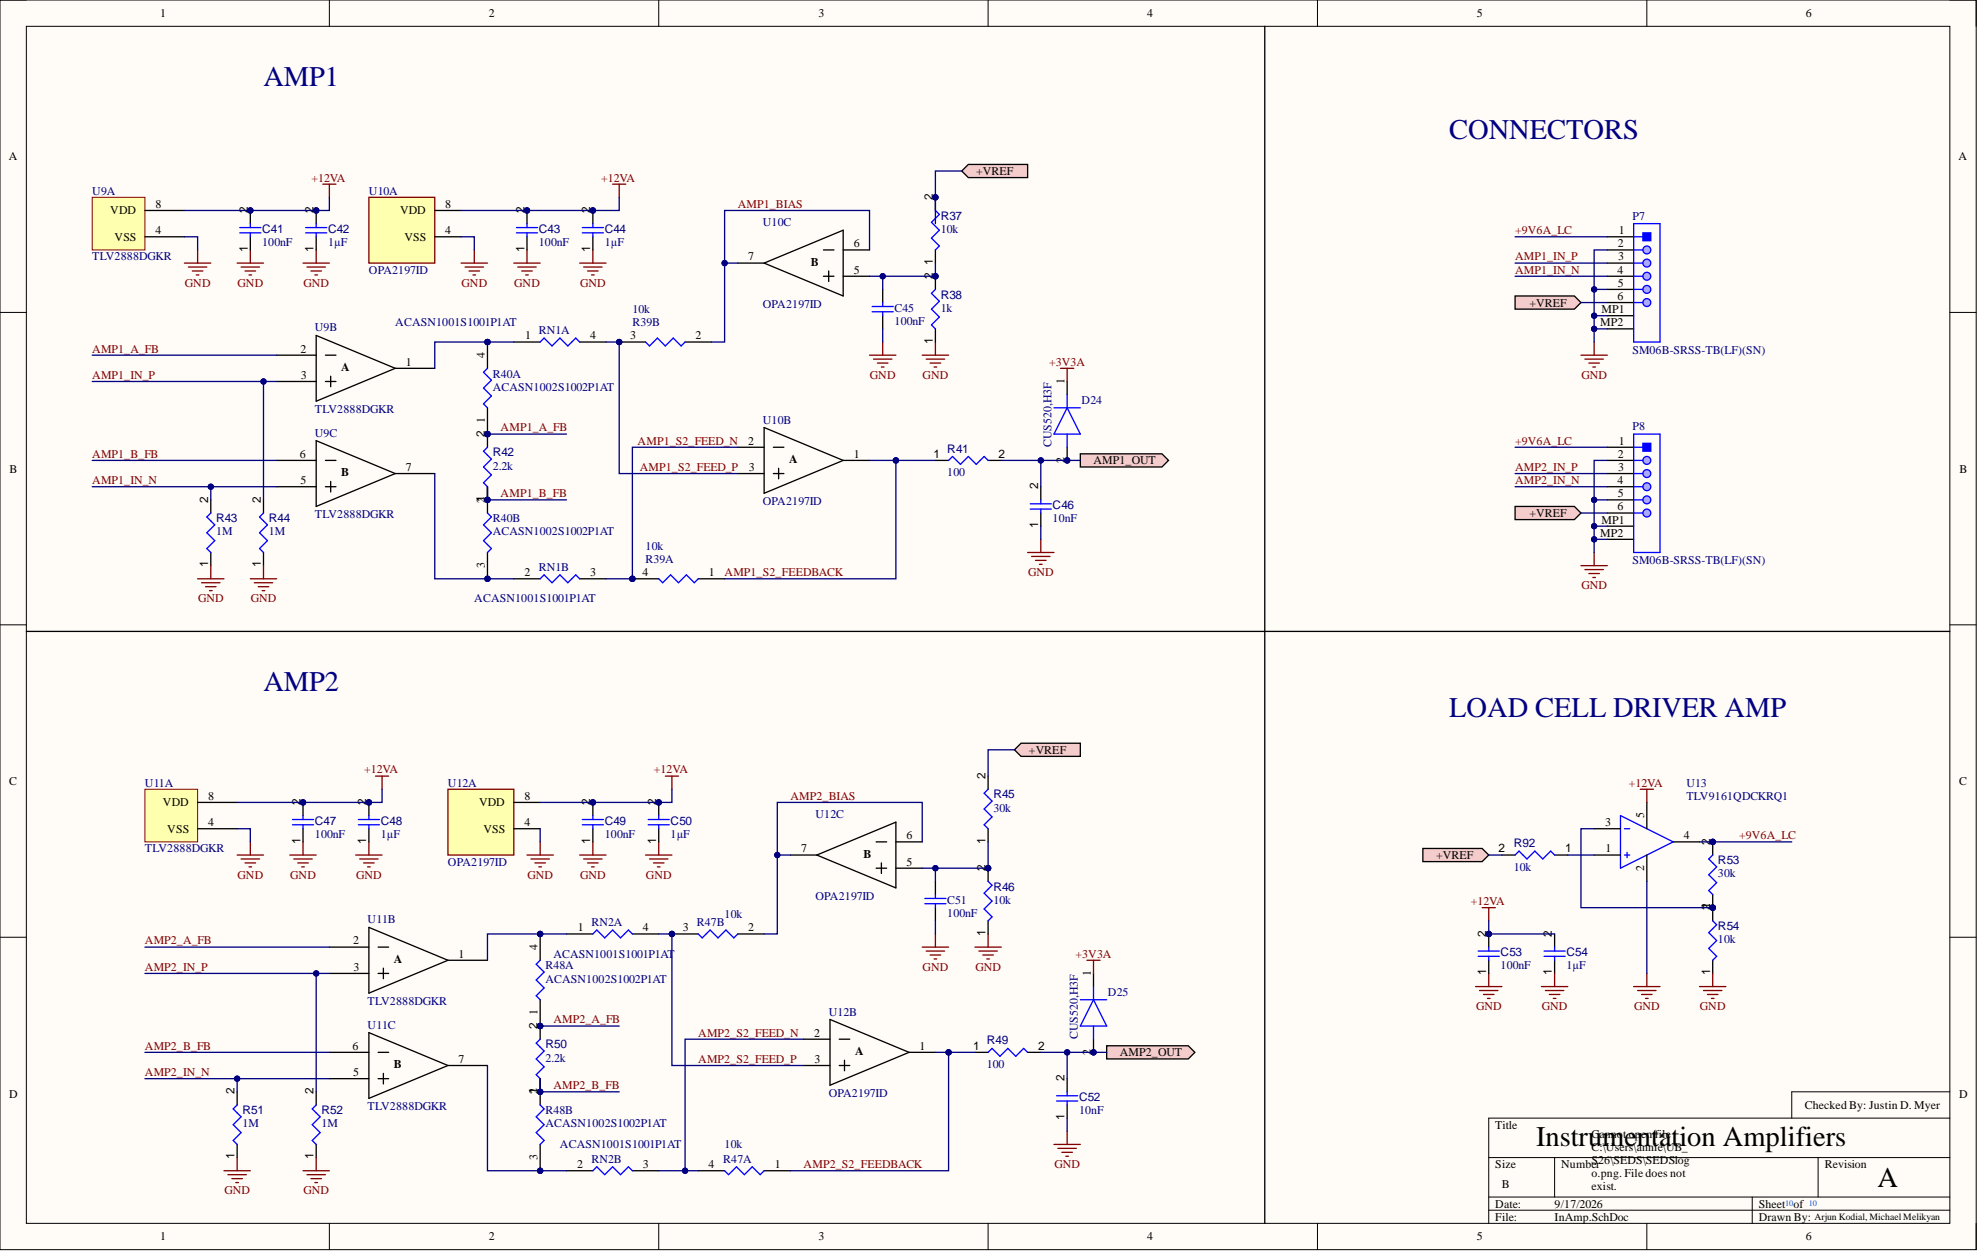
[picture p10: page 10]

MP1
MP2

SM06B-SRSS-TB(LF)(SN)

LOAD CELL DRIVER AMP

AMP2_S2_FEED_P

Checked By: Justin D. Myer

Arjun Kodial, Michael Melikyan
