University-at-Buffalo-SEDS/DAQ-Board/Core/Src/main.c

#include "board_commissioning.h"
#include "board_recovery_floor.h"
#include "persistent_store.h"
/* USER CODE BEGIN Header */
/**
  ******************************************************************************
  * @file           : main.c
  * @brief          : Main program body
  ******************************************************************************
  * @attention
  *
  * Copyright (c) 2026 STMicroelectronics.
  * All rights reserved.
  *
  * This software is licensed under terms that can be found in the LICENSE file
  * in the root directory of this software component.
  * If no LICENSE file comes with this software, it is provided AS-IS.
  *
  ******************************************************************************
  */
/* USER CODE END Header */
/* Includes ------------------------------------------------------------------*/
#include "app_threadx.h"
#include "main.h"
#include "board_watchdog.h"

/* USER CODE BEGIN Includes */
#include "sd_card.h"
#include "flight_state_cache.h"
#include "board_recovery_boot.h"

/* USER CODE END Includes */

ADC_HandleTypeDef hadc1;
ADC_HandleTypeDef hadc4;

DAC_HandleTypeDef hdac1;

DCACHE_HandleTypeDef hdcache1;

FDCAN_HandleTypeDef hfdcan1;

SD_HandleTypeDef hsd1;

SPI_HandleTypeDef hspi2;
DMA_HandleTypeDef handle_GPDMA1_Channel1;
DMA_HandleTypeDef handle_GPDMA1_Channel0;

TIM_HandleTypeDef htim2;

UART_HandleTypeDef huart1;
DMA_HandleTypeDef handle_GPDMA1_Channel3;
DMA_HandleTypeDef handle_GPDMA1_Channel2;

PCD_HandleTypeDef hpcd_USB_OTG_FS;

void SystemClock_Config(void);
static void MX_GPIO_Init(void);
static void MX_GPDMA1_Init(void);
static void MX_ADC1_Init(void);
static void MX_ADC4_Init(void);
static void MX_DAC1_Init(void);
static void MX_DCACHE1_Init(void);
static void MX_FDCAN1_Init(void);
static void MX_ICACHE_Init(void);
static void MX_SDMMC1_SD_Init(void);
static void MX_SPI2_Init(void);
static void MX_TIM2_Init(void);
static void MX_USART1_UART_Init(void);
static void MX_USB_OTG_FS_PCD_Init(void);
/* USER CODE BEGIN PFP */
#define michael (;;)
static void busy_delay(volatile uint32_t n)
{
  while (n--) { __NOP(); }
}
/* USER CODE END PFP */

/**
  * @brief  The application entry point.
  * @retval int
  */
int main(void)
{

  /* MCU Configuration--------------------------------------------------------*/

  /* Reset of all peripherals, Initializes the Flash interface and the Systick. */
  HAL_Init();

  /* Configure the system clock */
  SystemClock_Config();

  /* Initialize all configured peripherals */
  MX_GPIO_Init();
  MX_GPDMA1_Init();
  MX_ADC1_Init();
  MX_ADC4_Init();
  MX_DAC1_Init();
  MX_DCACHE1_Init();
  MX_FDCAN1_Init();
  MX_ICACHE_Init();
  MX_SDMMC1_SD_Init();
  MX_SPI2_Init();
  MX_TIM2_Init();
  MX_USART1_UART_Init();
  MX_USB_OTG_FS_PCD_Init();
  (void)persistent_store_boot_begin();
  /* Establish recovery identity before cached state restore and control tasks. */
  (void)board_recovery_boot_generation();
  (void)board_recovery_floor_prime_boot(); /* Cached failure stays queryable/inhibited. */
  board_commissioning_probe_boot();
  flight_state_cache_restore();
  board_watchdog_start();
  MX_ThreadX_Init();

  /* We should never get here as control is now taken by the scheduler */

  /* Infinite loop */
  /* USER CODE BEGIN WHILE */
  while (1)
  {
    /* USER CODE END WHILE */

    /* USER CODE BEGIN 3 */
  }
  /* USER CODE END 3 */
}

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
/* USER CODE BEGIN 4 */
extern void mcp3564r_data_ready_callback(uint16_t pin);

void HAL_GPIO_EXTI_Falling_Callback(uint16_t pin)
{
  mcp3564r_data_ready_callback(pin);
}

/* USER CODE END 4 */

/**
  * @brief  Period elapsed callback in non blocking mode
  * @note   This function is called  when TIM6 interrupt took place, inside
  * HAL_TIM_IRQHandler(). It makes a direct call to HAL_IncTick() to increment
  * a global variable "uwTick" used as application time base.
  * @param  htim : TIM handle
  * @retval None
  */
void HAL_TIM_PeriodElapsedCallback(TIM_HandleTypeDef *htim)
{
  if (htim->Instance == TIM6)
  {
    HAL_IncTick();
  }
  /* USER CODE BEGIN Callback 1 */
  /* ADC conversions are serviced by PB10 EXTI, never a timer poll. */

  /* USER CODE END Callback 1 */
}

/**
  * @brief  This function is executed in case of error occurrence.
  * @retval None
  */
void Error_Handler(void)
{
  /* USER CODE BEGIN Error_Handler_Debug */
  /* User can add his own implementation to report the HAL error return state */
  __disable_irq();
  while (1)
  {
  HAL_GPIO_TogglePin(LED1_GPIO_Port, LED1_Pin);
  HAL_GPIO_TogglePin(LED2_GPIO_Port, LED2_Pin);
    busy_delay(10000);
  }
  /* USER CODE END Error_Handler_Debug */
}
#ifdef USE_FULL_ASSERT
/**
  * @brief  Reports the name of the source file and the source line number
  *         where the assert_param error has occurred.
  * @param  file: pointer to the source file name
  * @param  line: assert_param error line source number
  * @retval None
  */
void assert_failed(uint8_t *file, uint32_t line)
{
  /* USER CODE BEGIN 6 */
  /* User can add his own implementation to report the file name and line number,
     ex: printf("Wrong parameters value: file %s on line %d\r\n", file, line) */
  /* USER CODE END 6 */
}
#endif /* USE_FULL_ASSERT */
