University-at-Buffalo-SEDS/DAQ-Board/DAQ-Board.ioc

Mcu.UserName=STM32U585RITx
PA0.Signal=ADC1_IN5
PA1.Signal=ADC1_IN6
PA10.Signal=USART1_RX
PA11.Signal=USB_OTG_FS_DM
PA12.Signal=USB_OTG_FS_DP
PA2.Signal=ADC1_IN7
PA3.Signal=ADC1_IN8
PA6.Signal=ADC1_IN11
PA7.Signal=ADC1_IN12
PA8.Signal=RCC_MCO
PA9.Signal=USART1_TX
PB12.GPIO_Label=ADC_NCS
PB12.Signal=GPIO_Output
PB1.Signal=ADC1_IN16
PB2.Signal=ADC1_IN17
PC5.GPIO_Label=ISENSE_EN
PC5.Signal=GPIO_Output
PB13.Signal=SPI2_SCK
PB14.Signal=SPI2_MISO
PB15.Signal=SPI2_MOSI
PB8.Signal=FDCAN1_RX
PB9.Signal=FDCAN1_TX
PC0.Signal=ADC4_IN1
PC1.Signal=ADC4_IN2
PC10.Signal=SDMMC1_D2
PC11.Signal=SDMMC1_D3
PC12.Signal=SDMMC1_CK
PC2.Signal=ADC4_IN3
PC3.Signal=ADC4_IN4
PC4.GPIO_Label=EN_12V
PC4.Signal=GPIO_Output
PC6.GPIO_Label=LED2
PC6.Signal=GPIO_Output
PC7.GPIO_Label=LED1
PC7.Signal=GPIO_Output
PC8.Signal=SDMMC1_D0
PC9.Signal=SDMMC1_D1
PD2.Signal=SDMMC1_CMD
PB10.GPIO_Label=ADC_IRQ
PB10.Signal=GPXTI10
