University-at-Buffalo-SEDS/DAQ-Board/Core/Inc/main.h

#define EN_12V_Pin GPIO_PIN_4
#define EN_12V_GPIO_Port GPIOC
#define ADC_IRQ_Pin GPIO_PIN_10
#define ADC_IRQ_GPIO_Port GPIOB
#define ADC_NCS_Pin GPIO_PIN_12
#define ADC_NCS_GPIO_Port GPIOB
#define LED2_Pin GPIO_PIN_6
#define LED2_GPIO_Port GPIOC
#define LED1_Pin GPIO_PIN_7
#define LED1_GPIO_Port GPIOC
#define DISABLE_SD_CARD 0U
