University-at-Buffalo-SEDS/DAQ-Board/Core/Src/daq_thread.c

#include "board_uptime.h"
#include "board_watchdog.h"
#include "DAQ-Threads.h"

#include "daq_board.h"
#include "main.h"
#include "stm32u5xx_hal_gpio.h"
#include "sd_card.h"
#include "daq_log_time.h"
#include "sedsnet_config.h"
#include "mcp3564r.h"
#include "daq_calibration.h"
#include "daq_rates.h"
#include "daq_network_schedule.h"
#include "daq_downsample.h"
#include "daq_timestamp.h"
#include "daq_filter.h"
#include "daq_chamber_pressure.h"
#include <string.h>
#include <math.h>
TX_THREAD daq_thread;

#define DAQ_THREAD_STACK_SIZE (32U * 1024U)
#define DAQ_SAMPLE_PERIOD_MS DAQ_ACQUISITION_PERIOD_MS
#define DAQ_SAMPLE_PERIOD_TICKS ((DAQ_SAMPLE_PERIOD_MS * TX_TIMER_TICKS_PER_SECOND) / 1000U)
#define DAQ_INPUT_VOLTAGE_LOW_V 8.5f
#define DAQ_INPUT_VOLTAGE_RECOVERED_V 9.0f
#define DAQ_ENABLE_DUMMY_CAN_TELEMETRY 0U
#define DAQ_RAW_BATCH_MAX DAQ_RAW_BATCH_CAPACITY

volatile uint32_t g_daq_sample_ok_count = 0U;
volatile uint32_t g_daq_sample_fail_count = 0U;
volatile uint32_t g_daq_init_fail_count = 0U;
volatile uint32_t g_daq_loadcell_publish_ok_count = 0U;
volatile uint32_t g_daq_loadcell_publish_fail_count = 0U;
volatile uint32_t g_daq_kg50_publish_ok_count = 0U;
volatile uint32_t g_daq_kg50_publish_fail_count = 0U;
volatile uint32_t g_daq_temperature_publish_ok_count = 0U;
volatile uint32_t g_daq_temperature_publish_fail_count = 0U;
volatile uint32_t g_daq_raw_samples_drained_count = 0U;
volatile uint32_t g_daq_nonzero_raw_sample_count = 0U;
volatile uint32_t g_daq_sd_raw_batch_drop_count = 0U;
volatile uint32_t g_daq_sd_network_row_ok_count = 0U;
volatile uint32_t g_daq_sd_network_row_fail_count = 0U;
volatile uint32_t g_daq_sample_overrun_count = 0U;
volatile uint32_t g_daq_cycle_elapsed_ticks = 0U;
volatile uint32_t g_daq_cycle_max_ticks = 0U;
volatile uint32_t g_daq_first_overrun_ticks = 0U;
volatile uint32_t g_daq_first_overrun_sample = 0U;
volatile uint32_t g_daq_sampling_max_ticks = 0U;
volatile uint32_t g_daq_drain_max_ticks = 0U;
volatile uint32_t g_daq_publish_max_ticks = 0U;
volatile uint32_t g_daq_adc_service_max_ticks = 0U;

/* Wall-time profiling, including preemption and mutex waits. Stages are board
 * sampling, raw drain/enqueue, publishing, and ADC service. Read deltas of the
 * totals/counts to locate rate limits without stopping acquisition. */
volatile uint32_t g_daq_stage_ticks[4] = {0};
volatile uint32_t g_daq_stage_max_ticks[4] = {0};
volatile uint32_t g_daq_stage_count[4] = {0};

static ULONG daq_profile_stage(unsigned stage, ULONG started)
{
  const ULONG now = tx_time_get();
  const uint32_t elapsed = (uint32_t)(now - started);
  g_daq_stage_ticks[stage] += elapsed;
  if (elapsed > g_daq_stage_max_ticks[stage])
    g_daq_stage_max_ticks[stage] = elapsed;
  g_daq_stage_count[stage]++;
  switch (stage) {
    case 0U: g_daq_sampling_max_ticks = g_daq_stage_max_ticks[stage]; break;
    case 1U: g_daq_drain_max_ticks = g_daq_stage_max_ticks[stage]; break;
    case 2U: g_daq_publish_max_ticks = g_daq_stage_max_ticks[stage]; break;
    default: g_daq_adc_service_max_ticks = g_daq_stage_max_ticks[stage]; break;
  }
  return now;
}

static ULONG g_daq_thread_stack[DAQ_THREAD_STACK_SIZE / sizeof(ULONG)];

typedef struct
{
  int64_t code_sum[10];
  float sum[10];
  float voltage_sum[10];
  uint16_t count[10];
} daq_loadcell_window_t;

static uint16_t daq_drain_ext_adc(daq_snapshot_t *snapshot,
                                  sd_raw_adc_record_t *records,
                                  uint16_t capacity,
                                  const daq_calibration_t *calibration,
                                  daq_loadcell_window_t *window)
{
  mcp3564r_sample_t sample = {
    .sample_valid = snapshot->ext_adc_sample_valid,
    .channel = snapshot->ext_adc_channel,
    .monotonic_ms = snapshot->ext_adc_monotonic_ms,
    .code = snapshot->ext_adc_code,
    .voltage_v = snapshot->ext_adc_voltage_v,
    .raw_value = snapshot->ext_adc_loadcell_kg1000,
    .temperature_c = snapshot->ext_adc_temp_c,
    .temperature_code = snapshot->ext_adc_temp_code,
  };
  static daq_filter_t filters[2];
  static daq_calibration_t filter_calibration;
  if (memcmp(&filter_calibration, calibration, sizeof(*calibration)) != 0)
  {
    memset(filters, 0, sizeof(filters));
    filter_calibration = *calibration;
  }
  uint16_t count = 0U;
  const uint64_t unix_now = daq_log_unix_ms_cached();
  const uint64_t mono_now = board_uptime_ticks();
  static uint32_t raw_sequence;
  *window = (daq_loadcell_window_t){0};

  for (;;)
  {
    if (sample.sample_valid != 0U && (sample.channel < 8U || sample.channel == 9U) && count < capacity)
    {
      const uint8_t channel = sample.channel;
      const float raw = sample.raw_value;
      const float corrected = channel < 2U ? daq_filter_add(&filters[channel],
          daq_calibration_temperature_raw(calibration, channel, raw, sample.temperature_c),
          (uint32_t)sample.monotonic_ms, calibration->filter_tau_ms[channel]) : mcp3564r_connector_voltage(channel, sample.voltage_v);
      if (records != NULL)
      {
        records[count].channel = channel;
        const uint64_t captured_uptime = board_uptime_project(mono_now, (uint32_t)sample.monotonic_ms);
        records[count].monotonic_ms = (uint32_t)sample.monotonic_ms;
        records[count].record_sequence = ++raw_sequence;
        records[count].network_unix_ms = daq_sample_network_ms(unix_now, mono_now, captured_uptime);
        records[count].raw_adc_code = sample.code;
        records[count].raw_value = daq_chamber_is_channel(channel) ? corrected : raw;
        records[count].adc_temperature_c = sample.temperature_c;
        records[count].adc_temperature_code = sample.temperature_code;
        records[count].calibrated_value = daq_chamber_is_channel(channel) ? daq_chamber_pressure_psi(corrected) : channel > 1U ? corrected : channel == 1U
            ? daq_calibration_apply_kg50(calibration, corrected)
            : calibration->kg1000_slope * corrected + calibration->kg1000_intercept;
      }
      if (sample.code != 0) g_daq_nonzero_raw_sample_count++;
      window->code_sum[channel] += sample.code;
      window->sum[channel] += raw;
      window->voltage_sum[channel] += sample.voltage_v;
      window->count[channel]++;
      count++;
    }
    if (count >= capacity || mcp3564r_pending_samples() == 0U ||
        mcp3564r_get_sample(&sample) != TX_SUCCESS || sample.sample_valid == 0U) break;
  }
  /* Legacy snapshot fields describe only the 1000 kg input. */
  snapshot->ext_adc_sample_valid = window->count[0] != 0U;
  if (window->count[0] != 0U)
  {
    snapshot->ext_adc_code = (int32_t)(window->code_sum[0] / window->count[0]);
    snapshot->ext_adc_loadcell_kg1000 = window->sum[0] / window->count[0];
    snapshot->ext_adc_voltage_v = window->voltage_sum[0] / window->count[0];
  }
  g_daq_raw_samples_drained_count += count;
  return count;
}

volatile uint32_t g_daq_sd_snapshot_row_drop_count;

static void daq_store_snapshot_csv(const daq_snapshot_t *snapshot,
                                   const daq_calibration_t *calibration,
                                   const daq_loadcell_window_t *window, sd_capture_t capture)
{
#if (DISABLE_SD_CARD == 0U)
  if (!snapshot->analog_sample_fresh) return;
  /* SD has its own bounded static owners. Never retain this acquisition/network
   * work block or re-publish its network data while storage is backpressured. */
  float values[SD_OPTIONAL_SNAPSHOT_ROWS];
  values[0] = snapshot->input_voltage_v;
  values[1] = snapshot->input_current_a;
  values[2] = snapshot->adc1_aux_v;
  memcpy(&values[3], snapshot->analog_inputs_v, sizeof(snapshot->analog_inputs_v));
  memcpy(&values[11], snapshot->current_sense_v, sizeof(snapshot->current_sense_v));
  memcpy(&values[13], snapshot->current_sense_a, sizeof(snapshot->current_sense_a));
  memcpy(&values[15], snapshot->power_monitor_v, sizeof(snapshot->power_monitor_v));
  memcpy(&values[17], snapshot->analog_outputs_v, sizeof(snapshot->analog_outputs_v));
  values[19] = snapshot->ext_adc_sample_valid ? (float)snapshot->ext_adc_code : NAN;
  values[20] = snapshot->ext_adc_sample_valid ? snapshot->ext_adc_voltage_v : NAN;
  values[21] = snapshot->ext_adc_sample_valid ? snapshot->ext_adc_loadcell_kg1000 : NAN;
  values[22] = snapshot->ext_adc_temp_c;
  values[23] = window->count[1] ? window->voltage_sum[1] / window->count[1] : NAN;
  if (sd_card_enqueue_optional_snapshot_captured(values, snapshot->monotonic_ms, calibration, capture) != SD_CARD_STATUS_OK)
    { sd_card_capture_fault(capture); g_daq_sd_snapshot_row_drop_count += SD_OPTIONAL_SNAPSHOT_ROWS; }
#else
  (void)snapshot; (void)calibration; (void)window; (void)capture;
#endif
}

extern volatile uint32_t g_daq_analog_publish_ok_count;
extern volatile uint32_t g_daq_analog_publish_fail_count;
#ifdef TELEMETRY_ENABLED
static daq_network_schedule_t g_daq_network;
static TX_THREAD g_network_thread;
static ULONG g_network_stack[8192U / sizeof(ULONG)];
volatile uint32_t g_daq_network_offered[DAQ_NETWORK_STREAMS];
volatile uint32_t g_daq_network_coalesced[DAQ_NETWORK_STREAMS];
volatile uint32_t g_daq_network_sent[DAQ_NETWORK_STREAMS];
volatile uint32_t g_daq_network_failed[DAQ_NETWORK_STREAMS];
#ifdef SEDS_FIRMWARE_SIM_TEST
/* These classify scheduler submissions, separately from CAN's transport retries. */
volatile uint32_t g_sim_daq_publication_attempts;
volatile uint32_t g_sim_daq_publication_io_refusals;
volatile uint32_t g_sim_daq_publication_other_refusals;
#endif
volatile uint32_t g_daq_network_invalid;

static void daq_network_offer(unsigned stream, uint32_t type, const float *values,
                               size_t count, uint64_t captured_ms)
{
  const uint32_t saved = __get_PRIMASK();
  __disable_irq();
  const int replaced = daq_network_schedule_offer(&g_daq_network, stream, type, values, count, captured_ms);
  if (replaced < 0) ++g_daq_network_invalid;
  else {
    ++g_daq_network_offered[stream];
    if (replaced) ++g_daq_network_coalesced[stream];
  }
  __set_PRIMASK(saved);
}

static void daq_network_process_once(uint32_t now_ms)
{
  daq_network_sample_t sample;
  unsigned stream;
  const uint32_t saved = __get_PRIMASK();
  __disable_irq();
  const int ready = daq_network_schedule_take(&g_daq_network, now_ms, &stream, &sample);
  __set_PRIMASK(saved);
  if (!ready) return;
  /* One SDK call per aggregate slot. No lock is held across network work and
   * a refused sample does not trigger a retry burst; the next offer is fresh. */
#ifdef SEDS_FIRMWARE_SIM_TEST
  ++g_sim_daq_publication_attempts;
#endif
  const SedsResult result = log_telemetry_captured(sample.type, sample.values,
      sample.count, sizeof(float), sample.captured_ms);
  if (result == SEDS_OK) ++g_daq_network_sent[stream];
  else ++g_daq_network_failed[stream];
#ifdef SEDS_FIRMWARE_SIM_TEST
  if (result == SEDS_IO) ++g_sim_daq_publication_io_refusals;
  else if (result != SEDS_OK) ++g_sim_daq_publication_other_refusals;
#endif
  if (stream == DAQ_NETWORK_KG1000) {
    if (result == SEDS_OK) ++g_daq_loadcell_publish_ok_count;
    else ++g_daq_loadcell_publish_fail_count;
  } else if (stream == DAQ_NETWORK_KG50) {
    if (result == SEDS_OK) ++g_daq_kg50_publish_ok_count;
    else ++g_daq_kg50_publish_fail_count;
  } else if (stream == DAQ_NETWORK_TEMPERATURE) {
    if (result == SEDS_OK) ++g_daq_temperature_publish_ok_count;
    else ++g_daq_temperature_publish_fail_count;
  } else {
    if (result == SEDS_OK) ++g_daq_analog_publish_ok_count;
    else ++g_daq_analog_publish_fail_count;
  }
}

static void daq_network_thread_entry(ULONG argument)
{
  (void)argument;
  for (;;) {
    daq_network_process_once(HAL_GetTick());
    tx_thread_sleep((TX_TIMER_TICKS_PER_SECOND + 999U) / 1000U);
  }
}
#endif

volatile uint32_t g_daq_analog_publish_ok_count;
volatile uint32_t g_daq_analog_publish_fail_count;

static void daq_publish_analog_packet(uint32_t type, const float *values, size_t count,
                                     uint64_t captured_ms)
{
#ifdef TELEMETRY_ENABLED
  const unsigned stream = type == SEDS_DT_DAQ_SDADC_VOLTAGES ? DAQ_NETWORK_SDADC :
      type == SEDS_DT_DAQ_SAR_VOLTAGES ? DAQ_NETWORK_SAR :
      type == SEDS_DT_DAQ_CURRENT_SENSE ? DAQ_NETWORK_CURRENT : DAQ_NETWORK_POWER;
  daq_network_offer(stream, type, values, count, captured_ms);
#else
  (void)type; (void)values; (void)count; (void)captured_ms;
#endif
}

static void daq_publish_analog(const daq_snapshot_t *snapshot, const daq_loadcell_window_t *window)
{
  static float auxiliary[6];
  static uint32_t updated[6];
  static uint8_t valid;
  static uint32_t last_report;
  const uint32_t now = (uint32_t)snapshot->monotonic_ms;
  for (unsigned i = 0; i < 6U; ++i)
  {
    if (window->count[i + 2U] != 0U)
    {
      auxiliary[i] = mcp3564r_connector_voltage(i + 2U, window->voltage_sum[i + 2U] / window->count[i + 2U]);
      updated[i] = now;
      valid |= (uint8_t)(1U << i);
    }
  }
  if ((uint32_t)(now - last_report) >= DAQ_ANALOG_REPORT_PERIOD_MS)
  {
    last_report = now;
    float values[6];
    for (unsigned i = 0; i < 6U; ++i)
      values[i] = (valid & (1U << i)) && (uint32_t)(now - updated[i]) <= 3U * MCP3564R_AUX_INTERVAL_MS
          ? auxiliary[i] : NAN;
    daq_publish_analog_packet(SEDS_DT_DAQ_SDADC_VOLTAGES, values, 6U, snapshot->monotonic_ms);
  }
  if (snapshot->analog_sample_fresh)
  {
    const float current[] = {snapshot->current_sense_v[0], snapshot->current_sense_v[1],
                            snapshot->current_sense_a[0], snapshot->current_sense_a[1]};
    const float power[] = {snapshot->power_monitor_v[0], snapshot->power_monitor_v[1],
                          snapshot->input_voltage_v, snapshot->input_current_a};
    daq_publish_analog_packet(SEDS_DT_DAQ_SAR_VOLTAGES, snapshot->analog_inputs_v, 8U, snapshot->monotonic_ms);
    daq_publish_analog_packet(SEDS_DT_DAQ_CURRENT_SENSE, current, 4U, snapshot->monotonic_ms);
    daq_publish_analog_packet(SEDS_DT_DAQ_POWER_MONITOR, power, 4U, snapshot->monotonic_ms);
  }
}

static void daq_publish_loadcell(const daq_snapshot_t *snapshot, const daq_calibration_t *calibration,
                                  const float *chamber, sd_capture_t capture)
{
  float loadcell_kg1000;

  if (snapshot->ext_adc_sample_valid == 0U)
  {
    return;
  }

  /* CAN carries the uncalibrated window average. GroundStation owns display
   * calibration; SD raw records separately retain calibrated values and the
   * coefficients. Never apply calibration twice along the network path. */
  loadcell_kg1000 = snapshot->ext_adc_loadcell_kg1000;

#if (DISABLE_SD_CARD == 0U)
  if (sd_card_enqueue_csv_row_captured("kg1000_network",
                              snapshot->monotonic_ms,
                              loadcell_kg1000, calibration, capture) == SD_CARD_STATUS_OK)
  {
    g_daq_sd_network_row_ok_count++;
  }
  else
  {
    sd_card_capture_fault(capture); g_daq_sd_network_row_fail_count++;
  }
#endif

  (void)chamber; (void)capture;

}

static void daq_publish_kg50(float raw, uint8_t input, uint64_t monotonic_ms,
                             const daq_calibration_t *calibration, sd_capture_t capture)
{
#if (DISABLE_SD_CARD == 0U)
  if (sd_card_enqueue_csv_row_captured(input ? "kg50_p6_network_volts" : "kg50_network", monotonic_ms, raw, calibration, capture) == SD_CARD_STATUS_OK)
    g_daq_sd_network_row_ok_count++;
  else { sd_card_capture_fault(capture); g_daq_sd_network_row_fail_count++; }
#else
  (void)monotonic_ms;
  (void)calibration; (void)capture;
#endif
}

/* This queue is for SD rows only; live values use an independent latest-slot handoff.
 * A work item keeps the
 * captured timestamp and calibration; saturation rejects the newest item and
 * is counted separately from the raw SD path. */
#define DAQ_REPORT_DEPTH 16U
#define DAQ_REPORT_KG1000 1U
#define DAQ_REPORT_KG50 2U
#define DAQ_REPORT_TEMPERATURE 4U
typedef struct {
  uint64_t monotonic_ms;
  daq_calibration_t calibration;
  float kg1000, kg50, temperature;
  float chamber[2];
  uint8_t chamber_valid;
  uint32_t flags;
  sd_capture_t capture;
  uint8_t kg50_input;
} daq_report_t;
_Static_assert(sizeof(daq_report_t) == 112U, "Capture token must not grow the report pool");
static TX_THREAD g_report_thread;
static TX_QUEUE g_report_queue;
static TX_BLOCK_POOL g_report_pool;
static ULONG g_report_stack[8192U / sizeof(ULONG)];
static ULONG g_report_queue_storage[DAQ_REPORT_DEPTH];
static ULONG g_report_pool_storage[(DAQ_REPORT_DEPTH * (sizeof(daq_report_t) + sizeof(void *)) + sizeof(ULONG) - 1U) / sizeof(ULONG)];
volatile uint32_t g_daq_report_enqueued_count;
volatile uint32_t g_daq_report_completed_count;
volatile uint32_t g_daq_report_drop_count;
volatile uint32_t g_daq_report_max_age_ms;

/* Acquisition publishes only into fixed latest-value slots. SD queue or
 * writer delays must never hold the live path behind historical reports. */
static void daq_offer_live_report(const daq_report_t *report)
{
#ifdef TELEMETRY_ENABLED
  if (report->flags & DAQ_REPORT_KG1000) {
    if (report->chamber_valid && isfinite(report->chamber[0]) && isfinite(report->chamber[1])) {
      const float combined[] = {report->kg1000, report->chamber[0], report->chamber[1]};
      daq_network_offer(DAQ_NETWORK_KG1000, SEDS_DT_DAQ_LOADCELL_CHAMBER,
                        combined, 3U, report->monotonic_ms);
    } else daq_network_offer(DAQ_NETWORK_KG1000, SEDS_DT_KG1000,
                            &report->kg1000, 1U, report->monotonic_ms);
  }
  if (report->flags & DAQ_REPORT_KG50) {
    const float tagged[] = {(float)report->kg50_input, report->kg50};
    daq_network_offer(DAQ_NETWORK_KG50,
        report->kg50_input == 0U ? SEDS_DT_KG50 : SEDS_DT_DAQ_KG50_SELECTED,
        report->kg50_input == 0U ? &report->kg50 : tagged,
        report->kg50_input == 0U ? 1U : 2U, report->monotonic_ms);
  }
  if (report->flags & DAQ_REPORT_TEMPERATURE)
    daq_network_offer(DAQ_NETWORK_TEMPERATURE, SEDS_DT_DAQ_ADC_TEMPERATURE,
                      &report->temperature, 1U, report->monotonic_ms);
#else
  (void)report;
#endif
}

static void daq_enqueue_report(const daq_report_t *report)
{
  if (!report->flags) return;
  daq_report_t *work;
  if (tx_block_allocate(&g_report_pool, (VOID **)&work, TX_NO_WAIT) != TX_SUCCESS) {
#if (DISABLE_SD_CARD == 0U)
    sd_card_capture_fault(report->capture);
#endif
    g_daq_report_drop_count++;
    return;
  }
  *work = *report;
#if (DISABLE_SD_CARD == 0U)
  sd_card_capture_retain(work->capture);
#endif
  ULONG message = (ULONG)(uintptr_t)work;
  if (tx_queue_send(&g_report_queue, &message, TX_NO_WAIT) != TX_SUCCESS) {
#if (DISABLE_SD_CARD == 0U)
    sd_card_capture_fault(work->capture); sd_card_capture_release(work->capture);
#endif
    (void)tx_block_release(work);
    g_daq_report_drop_count++;
  } else g_daq_report_enqueued_count++;
}

static void daq_report_thread_entry(ULONG argument)
{
  (void)argument;
  for (;;) {
    ULONG message;
    if (tx_queue_receive(&g_report_queue, &message, TX_WAIT_FOREVER) != TX_SUCCESS) continue;
    daq_report_t *work = (daq_report_t *)(uintptr_t)message;
    const uint64_t now = daq_log_monotonic_ms();
    const uint32_t age = now >= work->monotonic_ms ? (uint32_t)(now - work->monotonic_ms) : 0U;
    if (age > g_daq_report_max_age_ms) g_daq_report_max_age_ms = age;
    if (work->flags & DAQ_REPORT_KG1000) {
      daq_snapshot_t snapshot = {0};
      snapshot.ext_adc_sample_valid = 1U;
      snapshot.ext_adc_loadcell_kg1000 = work->kg1000;
      snapshot.monotonic_ms = work->monotonic_ms;
      daq_publish_loadcell(&snapshot, &work->calibration, work->chamber_valid ? work->chamber : NULL, work->capture);
    }
    if (work->flags & DAQ_REPORT_KG50)
      daq_publish_kg50(work->kg50, work->kg50_input, work->monotonic_ms, &work->calibration, work->capture);
    g_daq_report_completed_count++;
#if (DISABLE_SD_CARD == 0U)
    sd_card_capture_release(work->capture);
#endif
    (void)tx_block_release(work);
  }
}

#if (DAQ_ENABLE_DUMMY_CAN_TELEMETRY != 0U)
static void daq_publish_dummy_can_telemetry(void)
{
  const float kg1000 = 0.0f;

  (void)log_telemetry_asynchronous(SEDS_DT_KG1000,
                                   &kg1000,
                                   1U,
                                   sizeof(kg1000));
}
#endif

static void daq_enqueue_analog(const daq_snapshot_t *snapshot,
                               const daq_calibration_t *calibration,
                               const daq_loadcell_window_t *window, sd_capture_t capture);

void daq_thread_entry(ULONG initial_input)
{
  daq_snapshot_t snapshot;
  uint8_t power_loss_latched = 0U;
  uint8_t daq_ready = 1U;
  uint32_t last_temperature_report_ms = 0U;
  daq_downsample_t downsample = {0};
  daq_downsample_t downsample_kg50 = {0};
  daq_downsample_t downsample_chamber = {0};
  uint8_t previous_kg50_input = 0U;
  float chamber[2] = {NAN, NAN};
  uint32_t chamber_sample_ms = 0U;
  uint8_t chamber_seen = 0U;
#if (DISABLE_SD_CARD == 0U)
  sd_raw_adc_record_t raw_records[DAQ_RAW_BATCH_MAX];
#endif

  (void)initial_input;

  if (daq_board_init() != TX_SUCCESS)
  {
    g_daq_init_fail_count++;
    daq_ready = 0U;
  }
  else
  {
    (void)daq_board_ext_adc_start_dma();
  }

  for (;;)
  {
    const ULONG cycle_started = tx_time_get();
    board_watchdog_progress(BOARD_WATCHDOG_ACQUISITION);
#if (DAQ_ENABLE_DUMMY_CAN_TELEMETRY != 0U)
    daq_publish_dummy_can_telemetry();
#endif

    if (daq_ready == 0U)
    {
      tx_thread_sleep(DAQ_SAMPLE_PERIOD_TICKS);
      continue;
    }

    ULONG stage_started = tx_time_get();
    if (daq_board_sample(&snapshot) != TX_SUCCESS)
    {
      g_daq_sample_fail_count++;
      tx_thread_sleep(DAQ_SAMPLE_PERIOD_TICKS);
      continue;
    }

    stage_started = daq_profile_stage(0U, stage_started);
    g_daq_sample_ok_count++;
    daq_calibration_t calibration;
#if (DISABLE_SD_CARD == 0U)
    const sd_capture_t capture = sd_card_capture_begin(NULL, &calibration);
#else
    const sd_capture_t capture = 0U;
    calibration = daq_calibration_current();
#endif
    daq_loadcell_window_t window;

#if (DISABLE_SD_CARD == 0U)
    const uint16_t raw_count = daq_drain_ext_adc(&snapshot,
                                                 raw_records,
                                                 DAQ_RAW_BATCH_MAX, &calibration, &window);
#else
    (void)daq_drain_ext_adc(&snapshot, NULL, DAQ_RAW_BATCH_MAX, &calibration, &window);
#endif

    stage_started = daq_profile_stage(1U, stage_started);
    daq_report_t report = {.monotonic_ms = snapshot.monotonic_ms,
                           .calibration = calibration, .capture = capture};
    const uint32_t report_ms = (uint32_t)snapshot.monotonic_ms;
    if ((uint32_t)(report_ms - last_temperature_report_ms) >= DAQ_TEMPERATURE_REPORT_PERIOD_MS)
    {
      last_temperature_report_ms = report_ms;
      report.temperature = snapshot.ext_adc_temp_c;
      report.flags |= DAQ_REPORT_TEMPERATURE;
    }
    /* Pressure shares the existing acquisition/SD ring and KG1000 network
     * slot. Absence is never a fabricated zero; stale readings restore the
     * original scalar KG1000 publication without changing its cadence. */
    for (unsigned channel = 6U; channel <= 7U; ++channel) {
      if (daq_chamber_is_channel(channel) && window.count[channel] != 0U) {
        const float average_v = mcp3564r_connector_voltage(channel, window.voltage_sum[channel] / window.count[channel]);
        float filtered_v;
        if (daq_downsample_add(&downsample_chamber, average_v, window.count[channel],
                               report_ms, DAQ_BROADCAST_PERIOD_MS, &filtered_v)) {
          chamber[1] = filtered_v;
          chamber[0] = daq_chamber_pressure_psi(chamber[1]);
          chamber_seen = isfinite(chamber[0]);
          chamber_sample_ms = report_ms;
        }
      }
    }
    if (chamber_seen && (uint32_t)(report_ms - chamber_sample_ms) <= 100U) {
      memcpy(report.chamber, chamber, sizeof(chamber));
      report.chamber_valid = 1U;
    }
    float filtered;
    if (daq_downsample_add(&downsample, snapshot.ext_adc_loadcell_kg1000,
                           window.count[0], (uint32_t)snapshot.monotonic_ms,
                           DAQ_BROADCAST_PERIOD_MS, &filtered))
    {
      /* SD kg1000_network and SEDSNet receive this identical filtered value.
       * Raw records above retain individual, unfiltered conversions. */
      report.kg1000 = filtered;
      report.flags |= DAQ_REPORT_KG1000;
    }

    report.kg50_input = mcp3564r_kg50_input();
    if (report.kg50_input != previous_kg50_input) {
      memset(&downsample_kg50, 0, sizeof(downsample_kg50));
      previous_kg50_input = report.kg50_input;
    }
    const unsigned kg50_channel = report.kg50_input == 1U ? 9U : 1U;
    const float kg50_average = window.count[kg50_channel] != 0U ? window.sum[kg50_channel] / window.count[kg50_channel] : 0.0f;
    if (daq_downsample_add(&downsample_kg50, kg50_average, window.count[kg50_channel],
                           (uint32_t)snapshot.monotonic_ms, DAQ_BROADCAST_PERIOD_MS, &filtered))
    {
      report.kg50 = filtered;
      report.flags |= DAQ_REPORT_KG50;
    }
    daq_offer_live_report(&report);
#if (DISABLE_SD_CARD == 0U)
    if ((raw_count != 0U) &&
        sd_card_enqueue_raw_adc_samples_captured(raw_records, raw_count, &calibration, capture) != SD_CARD_STATUS_OK)
      { sd_card_capture_fault(capture); ++g_daq_sd_raw_batch_drop_count; }
#endif
    daq_enqueue_report(&report);
    daq_enqueue_analog(&snapshot, &calibration, &window, capture);
#if (DISABLE_SD_CARD == 0U)
    sd_card_capture_release(capture);
#endif

    stage_started = daq_profile_stage(2U, stage_started);
    (void)daq_board_ext_adc_start_dma();
    (void)daq_profile_stage(3U, stage_started);

    if ((power_loss_latched == 0U) && (snapshot.input_voltage_v <= DAQ_INPUT_VOLTAGE_LOW_V))
    {
      power_loss_latched = 1U;
#if (DISABLE_SD_CARD == 0U)
      (void)sd_card_notify_power_loss();
#endif
    }
    else if (snapshot.input_voltage_v >= DAQ_INPUT_VOLTAGE_RECOVERED_V)
    {
      power_loss_latched = 0U; /* Re-arm after recovery, with hysteresis. */
    }

    /* A power-loss notification asks the SD worker to flush. It must not
     * permanently throttle acquisition/network reporting to 10 Hz after
     * one low-voltage observation, including a startup transient. */

    /* Include acquisition/publish work in the configured period. Sleeping for a
     * whole period after doing that work silently reduces the sample rate. */
    const ULONG elapsed = tx_time_get() - cycle_started;
    g_daq_cycle_elapsed_ticks = elapsed;
    if (elapsed > g_daq_cycle_max_ticks) g_daq_cycle_max_ticks = elapsed;
    if (elapsed < DAQ_SAMPLE_PERIOD_TICKS)
    {
      tx_thread_sleep(DAQ_SAMPLE_PERIOD_TICKS - elapsed);
    }
    else if (elapsed > DAQ_SAMPLE_PERIOD_TICKS)
    {
      if (g_daq_sample_overrun_count == 0U) {
        g_daq_first_overrun_ticks = elapsed;
        g_daq_first_overrun_sample = g_daq_sample_ok_count;
      }
      g_daq_sample_overrun_count++;
      tx_thread_sleep(1U);
    }
    else
    {
      /* Finishing at the deadline is on time. Do not add another tick to
       * every such cycle; still yield to the other ready I/O workers. */
      tx_thread_relinquish();
    }
  }
}

/* Bound slow telemetry work independently of the load-cell drain. */
typedef struct {
  daq_snapshot_t snapshot;
  daq_calibration_t calibration;
  sd_capture_t capture;
  daq_loadcell_window_t window;
} daq_analog_work_t;
_Static_assert(sizeof(daq_analog_work_t) == 384U, "Capture token must not grow the analog pool");
static TX_THREAD g_analog_thread;
static TX_QUEUE g_analog_queue;
static TX_BLOCK_POOL g_analog_pool;
static ULONG g_analog_stack[8192U / sizeof(ULONG)];
static ULONG g_analog_queue_storage[3];
static ULONG g_analog_pool_storage[(3U * (sizeof(daq_analog_work_t) + sizeof(void *)) + sizeof(ULONG) - 1U) / sizeof(ULONG)];
volatile uint32_t g_daq_analog_work_drop_count;

static void daq_enqueue_analog(const daq_snapshot_t *snapshot,
                               const daq_calibration_t *calibration,
                               const daq_loadcell_window_t *window, sd_capture_t capture)
{
  static daq_loadcell_window_t accumulated;
  for (unsigned i = 2U; i < 8U; ++i) {
    accumulated.count[i] += window->count[i];
    accumulated.voltage_sum[i] += window->voltage_sum[i];
  }
  if (!snapshot->analog_sample_fresh) return;
  daq_analog_work_t *work;
  if (tx_block_allocate(&g_analog_pool, (VOID **)&work, TX_NO_WAIT) == TX_SUCCESS) {
    work->snapshot = *snapshot;
    work->calibration = *calibration; work->capture = capture;
#if (DISABLE_SD_CARD == 0U)
    sd_card_capture_retain(capture);
#endif
    work->window = accumulated;
    work->window.count[1] = window->count[1];
    work->window.voltage_sum[1] = window->voltage_sum[1];
    const ULONG message = (ULONG)(uintptr_t)work;
    if (tx_queue_send(&g_analog_queue, (VOID *)&message, TX_NO_WAIT) != TX_SUCCESS) {
#if (DISABLE_SD_CARD == 0U)
      sd_card_capture_fault(work->capture); sd_card_capture_release(work->capture);
#endif
      (void)tx_block_release(work);
      g_daq_analog_work_drop_count++;
    }
  } else {
#if (DISABLE_SD_CARD == 0U)
    sd_card_capture_fault(capture);
#endif
    g_daq_analog_work_drop_count++;
  }
  memset(&accumulated, 0, sizeof(accumulated));
}

static void daq_analog_thread_entry(ULONG argument)
{
  (void)argument;
  for (;;) {
    ULONG message;
    if (tx_queue_receive(&g_analog_queue, &message, TX_WAIT_FOREVER) != TX_SUCCESS) continue;
    daq_analog_work_t *work = (daq_analog_work_t *)(uintptr_t)message;
    daq_publish_analog(&work->snapshot, &work->window);
    /* One nonblocking SD handoff; network publication above is never retried. */
    daq_store_snapshot_csv(&work->snapshot, &work->calibration, &work->window, work->capture);
#if (DISABLE_SD_CARD == 0U)
    sd_card_capture_release(work->capture);
#endif
    (void)tx_block_release(work);
  }
}

UINT create_daq_thread(void)
{
  UINT status = tx_block_pool_create(&g_report_pool, "Loadcell reports", sizeof(daq_report_t),
                                     g_report_pool_storage, sizeof(g_report_pool_storage));
  if (status != TX_SUCCESS) return status;
  status = tx_queue_create(&g_report_queue, "Loadcell reports", TX_1_ULONG,
                           g_report_queue_storage, sizeof(g_report_queue_storage));
  if (status != TX_SUCCESS) return status;
  status = tx_thread_create(&g_report_thread, "Loadcell reporting", daq_report_thread_entry, 0U,
                            g_report_stack, sizeof(g_report_stack), DAQ_IO_THREAD_PRIORITY,
                            DAQ_IO_THREAD_PRIORITY,
                            (TX_TIMER_TICKS_PER_SECOND * DAQ_IO_THREAD_SLICE_MS + 999U) / 1000U,
                            TX_AUTO_START);
  if (status != TX_SUCCESS) return status;
  status = tx_block_pool_create(&g_analog_pool, "Analog snapshots", sizeof(daq_analog_work_t),
                                     g_analog_pool_storage, sizeof(g_analog_pool_storage));
  if (status != TX_SUCCESS) return status;
  status = tx_queue_create(&g_analog_queue, "Analog snapshots", TX_1_ULONG,
                           g_analog_queue_storage, sizeof(g_analog_queue_storage));
  if (status != TX_SUCCESS) return status;
  /* The SD writer can remain ready while draining a slow card. A lower-priority
   * analog worker would never run, even while the DAQ sleeps. Share the same
   * bounded round-robin slice as acquisition and storage instead. */
  status = tx_thread_create(&g_analog_thread, "Analog reporting", daq_analog_thread_entry, 0U,
                            g_analog_stack, sizeof(g_analog_stack), DAQ_IO_THREAD_PRIORITY,
                            DAQ_IO_THREAD_PRIORITY,
                            (TX_TIMER_TICKS_PER_SECOND * DAQ_IO_THREAD_SLICE_MS + 999U) / 1000U,
                            TX_AUTO_START);
  if (status != TX_SUCCESS) return status;
#ifdef TELEMETRY_ENABLED
  status = tx_thread_create(&g_network_thread, "Live sensor network", daq_network_thread_entry, 0U,
                            g_network_stack, sizeof(g_network_stack), DAQ_IO_THREAD_PRIORITY,
                            DAQ_IO_THREAD_PRIORITY,
                            (TX_TIMER_TICKS_PER_SECOND * DAQ_IO_THREAD_SLICE_MS + 999U) / 1000U,
                            TX_AUTO_START);
  if (status != TX_SUCCESS) return status;
#endif
  return tx_thread_create(&daq_thread,
                          "DAQ Thread",
                          daq_thread_entry,
                          0U,
                          g_daq_thread_stack,
                          sizeof(g_daq_thread_stack),
                          DAQ_ACQUISITION_THREAD_PRIORITY,
                          DAQ_ACQUISITION_THREAD_PRIORITY,
                          (TX_TIMER_TICKS_PER_SECOND * DAQ_IO_THREAD_SLICE_MS + 999U) / 1000U,
                          TX_AUTO_START);
}
