University-at-Buffalo-SEDS/DAQ-Board/Core/Src/telemetry.c

#include "board_commissioning.h"

#ifdef TELEMETRY_ENABLED
extern int telemetry_router_enter(void);
extern int telemetry_router_leave(void);
#endif
#include "can_tx_queue.h"
#include "board_health.h"
// telemetry.c
#include "telemetry.h"
#include "daq_calibration.h"
#include "daq_log_clock.h"
#include "sd_card.h"
#include "flight_state_cache.h"
#include "board_recovery_transport.h"
#include "sim_network_probe.h"
#include "board_can_priority.h"
#include "ota_stream.h"
#include "sd_file_stream.h"
#include "sedsnet_hardware_crypto.h"

#include "app_threadx.h"
#include "main.h"
#include "stm32u5xx_hal_gpio.h"
#ifdef TELEMETRY_BOARD_LINK_UART
#include "board_link_uart.h"
#endif
#ifdef TELEMETRY_CAN_BUS
#include "can_bus.h"
#endif
#include "sedsnet_config.h"
#include "board_packet_store.h"
#ifdef TELEMETRY_USE_TLSF
#include "telemetry_tlsf.h"
#endif
#include "daq_clock_cache.h"
#include "stm32u5xx_hal.h"

#include <stdarg.h>
#include <stdbool.h>
#include <stdint.h>
#include <stdio.h>
#include <string.h>

#ifndef TELEMETRY_ENABLED
static void print_data_no_telem(void *data, size_t len) {
  (void)data;
  (void)len;
}
#endif

#if defined(__GNUC__) || defined(__clang__)
#define UNUSED_FUNCTION __attribute__((unused))
#else
#define UNUSED_FUNCTION
#endif

#ifndef TELEMETRY_TIMESYNC_MASTER_PRIO
#define TELEMETRY_TIMESYNC_MASTER_PRIO (-1)
#endif

#ifndef TELEMETRY_TIMESYNC_SOURCE_TIMEOUT_MS
#define TELEMETRY_TIMESYNC_SOURCE_TIMEOUT_MS 5000U
#endif

#ifndef TELEMETRY_TIMESYNC_ANNOUNCE_INTERVAL_MS
#define TELEMETRY_TIMESYNC_ANNOUNCE_INTERVAL_MS 2000U
#endif

#ifndef TELEMETRY_TIMESYNC_REQUEST_INTERVAL_MS
#define TELEMETRY_TIMESYNC_REQUEST_INTERVAL_MS 2000U
#endif

#ifndef TX_TIMER_TICKS_PER_SECOND
#error "TX_TIMER_TICKS_PER_SECOND must be defined by ThreadX."
#endif

#define TELEMETRY_TIMESYNC_ROLE_CONSUMER 0U
#define TELEMETRY_TIMESYNC_ROLE_SOURCE 1U

#ifdef TELEMETRY_CAN_BUS
static uint8_t g_can_rx_subscribed = 0U;
#endif
#ifdef TELEMETRY_BOARD_LINK_UART
static uint8_t g_board_link_rx_subscribed = 0U;
#endif
#ifdef TELEMETRY_CAN_BUS
static int32_t g_can_side_id = -1;
#define BOARD_CAN_MAX_FRAME_BYTES CAN_TX_ALIGNED_FRAME_BYTES
#define BOARD_SIDE_TRANSPORT_TEMPLATES 4U
#endif
#ifdef TELEMETRY_BOARD_LINK_UART
static int32_t g_board_link_side_id = -1;
#endif
static uint8_t g_local_unix_valid = 0U;
static uint64_t g_local_unix_ms = 0ULL;
static uint8_t g_discovery_schema_announced = 0U;
static uint64_t g_discovery_schema_retry_ms = 0ULL;

#define TELEMETRY_ROUTER_RETRY_MS 500U
#ifdef TELEMETRY_ENABLED
static uint32_t g_router_retry_after_ms;
#endif
RouterState g_router = {.r = NULL, .created = 0U, .start_time = 0ULL};

/* Exported simulator/HIL health signals. A linked-bay test requires both a
 * remote discovery topology change and a valid SEDSNet network clock. */
volatile uint32_t g_telemetry_discovery_seen = 0U;
volatile uint32_t g_telemetry_timesync_valid = 0U;
/* Network clock restarts after it disagreed with the station clock by >60 s. */
volatile uint32_t g_network_clock_resyncs = 0U;
/* A restart cannot fix a source that disagrees with the GS; repeating it on
 * every GS packet kept the clock torn down. Monotonic ticks pace it. */
#define NETWORK_CLOCK_RESYNC_HOLDOFF_TICKS (30U * (ULONG)TX_TIMER_TICKS_PER_SECOND)
static ULONG g_network_clock_resync_tick;
volatile uint32_t g_telemetry_network_ready = 0U;
volatile uint32_t g_telemetry_peer_mask = 0U;
volatile uint32_t g_sim_heartbeat_attempts = 0U;
volatile uint32_t g_sim_heartbeat_ok = 0U;
volatile uint32_t g_sim_heartbeat_fail = 0U;
volatile uint32_t g_sim_heartbeat_wire_tx = 0U;

static uint64_t tx_raw_now_ms_locked(void) {
  const uint32_t ticks32 = (uint32_t)tx_time_get();
  return ((uint64_t)ticks32 * 1000ULL) / (uint64_t)TX_TIMER_TICKS_PER_SECOND;
}

static UNUSED_FUNCTION uint64_t tx_raw_now_ms(void *user) {
  (void)user;
  return tx_raw_now_ms_locked();
}

static uint8_t telemetry_timesync_is_source(void) {
  return (TELEMETRY_TIMESYNC_MASTER_PRIO >= 0) ? 1U : 0U;
}

static uint64_t telemetry_timesync_priority(void) {
  // Holdover consumers must yield when RF (1) or GroundStation (50) returns.
  return telemetry_timesync_is_source() ? (uint64_t)TELEMETRY_TIMESYNC_MASTER_PRIO : 100ULL;
}

static uint32_t telemetry_timesync_role(void) {
  return telemetry_timesync_is_source() ? TELEMETRY_TIMESYNC_ROLE_SOURCE
                                        : TELEMETRY_TIMESYNC_ROLE_CONSUMER;
}

static bool telemetry_unix_ms_to_utc(uint64_t unix_ms, int32_t *year, uint8_t *month,
                                     uint8_t *day, uint8_t *hour, uint8_t *minute,
                                     uint8_t *second, uint16_t *millisecond) {
  static const uint16_t days_before_month[12] = {0U,   31U,  59U,  90U,  120U, 151U,
                                                 181U, 212U, 243U, 273U, 304U, 334U};
  uint64_t whole_seconds = unix_ms / 1000ULL;
  const uint64_t days_since_epoch = whole_seconds / 86400ULL;
  uint32_t seconds_of_day = (uint32_t)(whole_seconds % 86400ULL);
  int32_t y = 1970;
  uint64_t days = days_since_epoch;

  if (!year || !month || !day || !hour || !minute || !second || !millisecond) {
    return false;
  }

  while (1) {
    const uint32_t y_u32 = (uint32_t)y;
    const uint8_t leap =
        ((y_u32 % 4U) == 0U && ((y_u32 % 100U) != 0U || (y_u32 % 400U) == 0U)) ? 1U : 0U;
    const uint32_t days_in_year = leap ? 366U : 365U;
    if (days < days_in_year) {
      uint8_t m = 1U;
      uint32_t day_of_year = (uint32_t)days;
      for (; m <= 12U; ++m) {
        uint32_t month_start = days_before_month[m - 1U];
        uint32_t month_end =
            (m < 12U) ? days_before_month[m] : (uint32_t)(leap ? 366U : 365U);
        if (leap && m > 2U) {
          month_start += 1U;
          month_end += 1U;
        }
        if (day_of_year < month_end) {
          *year = y;
          *month = m;
          *day = (uint8_t)(day_of_year - month_start + 1U);
          *hour = (uint8_t)(seconds_of_day / 3600U);
          *minute = (uint8_t)((seconds_of_day % 3600U) / 60U);
          *second = (uint8_t)(seconds_of_day % 60U);
          *millisecond = (uint16_t)(unix_ms % 1000ULL);
          return true;
        }
      }
      return false;
    }
    days -= days_in_year;
    ++y;
  }
}

static SedsResult telemetry_apply_local_unix_time_locked(SedsRouter *router) {
  int32_t year = 0;
  uint8_t month = 0;
  uint8_t day = 0;
  uint8_t hour = 0;
  uint8_t minute = 0;
  uint8_t second = 0;
  uint16_t millisecond = 0;

  if (!router || !telemetry_timesync_is_source() || !g_local_unix_valid) {
    return SEDS_OK;
  }

  if (!telemetry_unix_ms_to_utc(g_local_unix_ms, &year, &month, &day, &hour, &minute,
                                &second, &millisecond)) {
    return SEDS_BAD_ARG;
  }

  return seds_router_set_local_network_datetime_millis(router, year, month, day, hour, minute,
                                                       second, millisecond);
}

static SedsResult telemetry_configure_timesync_locked(SedsRouter *router) {
  SedsResult result;

  if (!router) {
    return SEDS_BAD_ARG;
  }

  result = seds_router_configure_timesync(
      router, true, telemetry_timesync_role(), telemetry_timesync_priority(),
      (uint64_t)TELEMETRY_TIMESYNC_SOURCE_TIMEOUT_MS,
      (uint64_t)TELEMETRY_TIMESYNC_ANNOUNCE_INTERVAL_MS,
      (uint64_t)TELEMETRY_TIMESYNC_REQUEST_INTERVAL_MS);
  if (result != SEDS_OK) {
    return result;
  }

  return telemetry_apply_local_unix_time_locked(router);
}

static SedsResult telemetry_heartbeat_handler(const SedsPacketView *pkt, void *user) {
  (void)sim_probe_heartbeat_handler(pkt, user);
  /* GS heartbeats keep the recovery freshness clock current, also in Abort. */
  if (pkt != NULL) board_recovery_observe_station_time(g_router.r, pkt);
  (void)user;
  return SEDS_OK;
}

uint64_t telemetry_now_ms(void) { return tx_raw_now_ms_locked(); }

static daq_clock_cache_t g_acquisition_clock;
uint64_t telemetry_unix_ms_cached(void) {
  const uint32_t mask = __get_PRIMASK();
  __disable_irq();
  const daq_clock_cache_t snapshot = g_acquisition_clock;
  const uint32_t now = HAL_GetTick();
  __set_PRIMASK(mask);
  return daq_clock_cache_read(snapshot, now);
}

static uint64_t telemetry_unix_ms_locked(void) {
#ifndef TELEMETRY_ENABLED
  return g_local_unix_valid ? g_local_unix_ms : 0ULL;
#else
  uint64_t unix_ms = 0ULL;

  /* An uptime-only network estimate is not a calendar date. */
  if (g_router.r && seds_router_get_network_time_ms(g_router.r, &unix_ms) == SEDS_OK &&
      unix_ms >= 315532800000ULL && unix_ms < 4354819200000ULL) {
    return unix_ms;
  }

  if (telemetry_timesync_is_source() && g_local_unix_valid) {
    return g_local_unix_ms;
  }

  return 0ULL;
#endif
}

uint64_t telemetry_unix_ms(void) {
#ifdef TELEMETRY_ENABLED
  if (!telemetry_router_enter()) return 0;
#endif
  uint64_t result = telemetry_unix_ms_locked();
#ifdef TELEMETRY_ENABLED
  if (!telemetry_router_leave()) return 0;
#endif
  return result;
}


uint64_t telemetry_unix_s(void) { return telemetry_unix_ms() / 1000ULL; }

uint8_t telemetry_unix_is_valid(void) { return telemetry_unix_ms() != 0ULL ? 1U : 0U; }

static void telemetry_set_unix_time_ms_locked(uint64_t unix_ms) {
  g_local_unix_ms = unix_ms;
  g_local_unix_valid = (unix_ms != 0ULL) ? 1U : 0U;

#ifdef TELEMETRY_ENABLED
  if (g_router.r != NULL) {
    (void)telemetry_apply_local_unix_time_locked(g_router.r);
  }
#endif
}

void telemetry_set_unix_time_ms(uint64_t unix_ms) {
#ifdef TELEMETRY_ENABLED
  if (!telemetry_router_enter()) return;
#endif
  telemetry_set_unix_time_ms_locked(unix_ms);
#ifdef TELEMETRY_ENABLED
  (void)telemetry_router_leave();
#endif
}


static uint64_t node_now_since_ms(void *user) {
  (void)user;
  const RouterState s = g_router;
  const uint64_t now = tx_raw_now_ms_locked();
  /* Construction and initial maintenance also need an advancing clock. */
  return now - s.start_time;
}

#ifdef TELEMETRY_CAN_BUS
volatile uint32_t g_daq_loadcell_wire_tx_count = 0U;
volatile uint32_t g_daq_loadcell_wire_fail_count = 0U;
static SedsResult tx_send_with_priority(const uint8_t *bytes, size_t len,
                                        uint8_t priority, void *user) {
  (void)user;

  if (!bytes || len == 0U) {
    return SEDS_BAD_ARG;
  }
  const uint32_t can_id =
      board_can_arbitration_id(bytes, len, priority,
          sim_probe_packed_data_type(bytes, len), (uint32_t)SEDS_DT_HEARTBEAT, 0x007U);
  if (can_bus_send_large(bytes, len, can_id) == HAL_OK) {
    if (sim_probe_packed_data_type(bytes, len) == (uint32_t)SEDS_DT_KG1000 ||
        sim_probe_packed_data_type(bytes, len) == (uint32_t)SEDS_DT_DAQ_LOADCELL_CHAMBER)
      g_daq_loadcell_wire_tx_count++;
    /* LED1 is the CAN egress activity indicator.  Toggle only after the
     * complete SEDSNet packet has been accepted by the hardware transport. */
    HAL_GPIO_TogglePin(LED1_GPIO_Port, LED1_Pin);
    sim_probe_observe_can_tx(bytes, len);
    return SEDS_OK;
  }
  if (sim_probe_packed_data_type(bytes, len) == (uint32_t)SEDS_DT_KG1000 ||
      sim_probe_packed_data_type(bytes, len) == (uint32_t)SEDS_DT_DAQ_LOADCELL_CHAMBER)
    g_daq_loadcell_wire_fail_count++;
  return SEDS_IO;
}

SedsResult tx_send(const uint8_t *bytes, size_t len, void *user) {
  return tx_send_with_priority(bytes, len, 0U, user);
}

#endif
#ifdef TELEMETRY_BOARD_LINK_UART
static SedsResult board_link_tx_send(const uint8_t *bytes, size_t len, void *user) {
  return board_link_uart_tx_send(bytes, len, user);
}
#endif

#ifdef TELEMETRY_CAN_BUS
static void telemetry_can_rx(const uint8_t *data, size_t len, void *user) {
  (void)user;
  /* LED2 is the CAN ingress activity indicator.  This callback runs only for
   * complete packets after CAN reassembly, so fragments do not exaggerate
   * the visible receive rate. */
  HAL_GPIO_TogglePin(LED2_GPIO_Port, LED2_Pin);
  sim_probe_observe_packed(data, len);
  rx_asynchronous(data, len);
}
#endif

#ifdef TELEMETRY_BOARD_LINK_UART
static void telemetry_board_link_rx_locked(const uint8_t *data, size_t len, void *user) {
  (void)user;

#ifdef TELEMETRY_ENABLED
  SedsResult result = SEDS_OK;

  if (!data || len == 0U) {
    return;
  }

  if (!g_router.r && init_telemetry_router() != SEDS_OK) {
    return;
  }

  if (g_board_link_side_id >= 0) {
    result = seds_router_receive_packed_from_side(
        g_router.r, (uint32_t)g_board_link_side_id, data, len);
  } else {
    result = seds_router_receive_packed(g_router.r, data, len);
  }

  (void)result;
  g_telemetry_discovery_seen = 1U;
#else
  (void)data;
  (void)len;
#endif
}

static void telemetry_board_link_rx(const uint8_t *data, size_t len, void *user) {
#ifdef TELEMETRY_ENABLED
  if (!telemetry_router_enter()) return;
#endif
  telemetry_board_link_rx_locked(data, len, user);
#ifdef TELEMETRY_ENABLED
  (void)telemetry_router_leave();
#endif
}

#endif

static void rx_asynchronous_locked(const uint8_t *bytes, size_t len) {
#ifndef TELEMETRY_ENABLED
  (void)bytes;
  (void)len;
  return;
#else
#ifndef TELEMETRY_CAN_BUS
  (void)bytes;
  (void)len;
  return;
#else
  if (!bytes || len == 0U) {
    return;
  }

  if (!g_router.r && init_telemetry_router() != SEDS_OK) {
    return;
  }

  if (g_can_side_id >= 0) {
    (void)seds_router_receive_packed_from_side(
        g_router.r, (uint32_t)g_can_side_id, bytes, len);
  } else {
    (void)seds_router_receive_packed(g_router.r, bytes, len);
  }
  g_telemetry_discovery_seen = 1U;
#endif
#endif
}

void rx_asynchronous(const uint8_t *bytes, size_t len) {
#ifdef TELEMETRY_ENABLED
  if (!telemetry_router_enter()) return;
#endif
  rx_asynchronous_locked(bytes, len);
#ifdef TELEMETRY_ENABLED
  (void)telemetry_router_leave();
#endif
}


static UNUSED_FUNCTION void rx_synchronous_locked(const uint8_t *bytes, size_t len) {
#ifndef TELEMETRY_ENABLED
  (void)bytes;
  (void)len;
  return;
#else
#ifndef TELEMETRY_CAN_BUS
  (void)bytes;
  (void)len;
  return;
#else
  if (!bytes || len == 0U) {
    return;
  }

  if (!g_router.r && init_telemetry_router() != SEDS_OK) {
    return;
  }

  if (g_can_side_id >= 0) {
    (void)seds_router_receive_packed_from_side(g_router.r, (uint32_t)g_can_side_id, bytes,
                                                   len);
  } else {
    (void)seds_router_receive_packed(g_router.r, bytes, len);
  }
#endif
#endif
}

static UNUSED_FUNCTION void rx_synchronous(const uint8_t *bytes, size_t len) {
#ifdef TELEMETRY_ENABLED
  if (!telemetry_router_enter()) return;
#endif
  rx_synchronous_locked(bytes, len);
#ifdef TELEMETRY_ENABLED
  (void)telemetry_router_leave();
#endif
}


static void telemetry_update_network_health(SedsRouter *router) {
  uint64_t network_time_ms = 0ULL;
  const ULONG now_ticks = tx_time_get();
  if (seds_router_get_network_time_ms(router, &network_time_ms) == SEDS_OK) {
    g_telemetry_timesync_valid = 1U;
    if ((g_network_clock_resyncs == 0U ||
         (ULONG)(now_ticks - g_network_clock_resync_tick) >= NETWORK_CLOCK_RESYNC_HOLDOFF_TICKS) &&
        board_recovery_network_clock_resync_needed(network_time_ms) &&
        telemetry_configure_timesync_locked(router) == SEDS_OK) {
      g_network_clock_resyncs++;
      g_network_clock_resync_tick = now_ticks;
      network_time_ms = 0ULL;
    }
  }
  const daq_clock_cache_t clock = daq_clock_cache_make(network_time_ms, HAL_GetTick());
  const uint32_t mask = __get_PRIMASK();
  __disable_irq();
  g_acquisition_clock = clock;
  __set_PRIMASK(mask);
  if (g_telemetry_discovery_seen != 0U &&
      g_telemetry_timesync_valid != 0U) {
    g_telemetry_network_ready = 1U;
  }
}

static SedsResult telemetry_poll_timesync_locked(void) {
#ifndef TELEMETRY_ENABLED
  return SEDS_OK;
#else
  if (init_telemetry_router() != SEDS_OK) {
    return SEDS_ERR;
  }

  const SedsResult result = seds_router_poll_timesync(g_router.r, NULL);
  telemetry_update_network_health(g_router.r);
  return result;
#endif
}

SedsResult telemetry_poll_timesync(void) {
#ifdef TELEMETRY_ENABLED
  if (!telemetry_router_enter()) return SEDS_BAD_ARG;
#endif
  SedsResult result = telemetry_poll_timesync_locked();
#ifdef TELEMETRY_ENABLED
  if (!telemetry_router_leave() && result == SEDS_OK) return SEDS_ERR;
#endif
  return result;
}


static SedsResult telemetry_announce_discovery_locked(void) {
#ifndef TELEMETRY_ENABLED
  return SEDS_OK;
#else
  if (init_telemetry_router() != SEDS_OK) {
    return SEDS_ERR;
  }

  return seds_router_announce_discovery(g_router.r);
#endif
}

SedsResult telemetry_announce_discovery(void) {
#ifdef TELEMETRY_ENABLED
  if (!telemetry_router_enter()) return SEDS_BAD_ARG;
#endif
  SedsResult result = telemetry_announce_discovery_locked();
#ifdef TELEMETRY_ENABLED
  if (!telemetry_router_leave() && result == SEDS_OK) return SEDS_ERR;
#endif
  return result;
}


static SedsResult telemetry_poll_discovery_locked(void) {
#ifdef TELEMETRY_ENABLED
  if (g_router.r) board_health_poll(g_router.r);
#endif

#ifndef TELEMETRY_ENABLED
  return SEDS_OK;
#else
  if (init_telemetry_router() != SEDS_OK) {
    return SEDS_ERR;
  }

  bool did_queue = false;
  /* Cadence polling advertises routes, not schema. Publish the complete local
   * catalog once after startup so existing relays learn newly added types.
   * Leave queue processing running between bounded retries on queue pressure. */
  const uint64_t now = tx_raw_now_ms_locked();
  if (now >= g_discovery_schema_retry_ms) {
    if (!g_discovery_schema_announced) {
      g_discovery_schema_retry_ms = now + 1000ULL;
      if (seds_router_announce_discovery(g_router.r) == SEDS_OK) {
        g_discovery_schema_announced = 1U;
      }
    }
  }
  board_commissioning_service();
  (void)flight_state_cache_poll(g_router.r);
  (void)daq_calibration_poll(g_router.r);
  (void)daq_log_clock_poll(g_router.r);
  const SedsResult result = seds_router_poll_discovery(g_router.r, &did_queue);
  if (result == SEDS_OK) {
    sim_probe_emit_heartbeat(g_router.r, telemetry_now_ms());
  }
  telemetry_update_network_health(g_router.r);
  return result;
#endif
}

SedsResult telemetry_poll_discovery(void) {
#ifdef TELEMETRY_ENABLED
  if (!telemetry_router_enter()) return SEDS_BAD_ARG;
#endif
  SedsResult result = telemetry_poll_discovery_locked();
#ifdef TELEMETRY_ENABLED
  if (!telemetry_router_leave() && result == SEDS_OK) return SEDS_ERR;
#endif
  return result;
}


#ifdef TELEMETRY_USE_TLSF
static __attribute__((unused)) bool telemetry_memory_admission_probe(
    size_t additional, size_t largest, uint32_t work)
{
  if (work == SEDS_MEMORY_WORK_SMALL_PROTECTED)
    return telemetry_tlsf_admit_small_protected(additional, largest);
  return telemetry_tlsf_admit(additional, largest);
}
#endif

volatile uint32_t g_pressure_sd_batches_received;
volatile uint32_t g_pressure_sd_invalid_batches;
static SedsResult pressure_sd_receive(const SedsPacketView *packet, void *context)
{
  (void)context;
  /* This endpoint belongs only to the pressure recorder. Keep the explicit
   * type check so another layout can never be interpreted as a batch. */
  if (!packet || packet->ty != SEDS_DT_VALVE_PRESSURE_SD_V1) return SEDS_OK;
  /* This source owns the remote raw/psi capture contract. No chamber or
   * differently calibrated pressure endpoint may masquerade as OX tank PT. */
  /* Canonical wire packets carry a compact or assigned numeric sender.
   * Let the router resolve retained discovery identity without guessing a
   * hash, accepting an unknown alias, or changing this source contract. */
  if (!seds_router_sender_matches_hostname(g_router.r, packet->sender,
                                           packet->sender_len, "VB", 2U))
    return SEDS_HANDLER_ERROR;
  pressure_sd_batch_t batch;
  if (pressure_sd_decode(&batch, packet->payload, packet->payload_len) != 0) {
    /* A malformed batch never decodes on retransmit: acknowledge, drop. */
    ++g_pressure_sd_invalid_batches; ++g_reliable_refusal_count; return SEDS_OK;
  }
  /* The SD handoff accepts the entire batch atomically. A refused handoff
   * must not generate a successful delivery receipt; let the reliable sender
   * retry the same packet after the writer drains its bounded queue. */
  if (sd_card_log_pressure_batch(&batch) != SD_CARD_STATUS_OK) return SEDS_IO;
  ++g_pressure_sd_batches_received;
  return SEDS_OK;
}

static SedsResult sd_retry_receive(const SedsPacketView *packet, void *context)
{
  (void)context;
  if (!packet) return SEDS_HANDLER_ERROR;
  /* SD_CARD also carries calibration/clock controls. Other handlers own those
   * types; ignoring them must not turn their accepted delivery into an error. */
  if (packet->ty != SEDS_DT_DAQ_SD_RETRY) return SEDS_OK;
  /* Wire senders are compact aliases; resolve them like every other owner
   * check instead of comparing literal names. A refused request (not the
   * station, malformed, invalid token) is acknowledged without effect: its
   * retransmit can never succeed. Only a busy writer asks for a retry. */
  if (!packet->sender ||
      !(seds_router_sender_matches_hostname(g_router.r, packet->sender, packet->sender_len, "GS", 2U) ||
        seds_router_sender_matches_hostname(g_router.r, packet->sender, packet->sender_len, "RRLS", 4U)) ||
      !packet->payload || packet->payload_len != 4U) {
    ++g_reliable_refusal_count; return SEDS_OK;
  }
  const uint8_t *p = packet->payload;
  const uint32_t token = (uint32_t)p[0] | ((uint32_t)p[1] << 8U) |
      ((uint32_t)p[2] << 16U) | ((uint32_t)p[3] << 24U);
  const sd_card_status_t status = sd_card_request_retry(token);
  if (status == SD_CARD_STATUS_BUSY) return SEDS_IO;
  if (status != SD_CARD_STATUS_OK) ++g_reliable_refusal_count;
  return SEDS_OK;
}

static SedsResult Board_Recovery_handler(const SedsPacketView *packet, void *user)
{
  (void)user;
  return board_recovery_handle(g_router.r, packet, SEDS_EP_BOARD_RECOVERY,
      (uint32_t)(((uint64_t)tx_time_get() * 1000U) / TX_TIMER_TICKS_PER_SECOND));
}

static SedsResult init_telemetry_router_locked(void) {
#ifndef TELEMETRY_ENABLED
  return SEDS_OK;
#else
  SedsRouter *r = NULL;
  SedsResult result = SEDS_OK;
#ifdef TELEMETRY_BOARD_LINK_UART
  int32_t board_link_side_id = -1;
#endif

  if (g_router.created && g_router.r) {
    return SEDS_OK;
  }

#ifdef TELEMETRY_CAN_BUS
  if (!g_can_rx_subscribed) {
    if (can_bus_subscribe_rx(telemetry_can_rx, NULL) == HAL_OK) {
      g_can_rx_subscribed = 1U;
    } else {
      printf("Error: can_bus_subscribe_rx failed\r\n");
    }
  }
#endif

#ifdef TELEMETRY_BOARD_LINK_UART
  if (!g_board_link_rx_subscribed) {
    if (board_link_uart_subscribe_rx(telemetry_board_link_rx, NULL) == HAL_OK) {
      g_board_link_rx_subscribed = 1U;
    } else {
      printf("Error: board_link_uart_subscribe_rx failed\r\n");
    }
  }
#endif

  static const SedsLocalEndpointDesc locals[] = {
      {
          .endpoint = SEDS_EP_BOARD_RECOVERY,
          .packet_handler = Board_Recovery_handler,
          .packed_handler = NULL,
          .user = NULL,
      },
      {.endpoint = SEDS_EP_SD_CARD, .packet_handler = sd_retry_receive, .packed_handler = NULL, .user = NULL},
      {.endpoint = SEDS_EP_VALVE_PRESSURE_LOG, .packet_handler = pressure_sd_receive, .packed_handler = NULL, .user = NULL},
      {
          .endpoint = SEDS_EP_HEART_BEAT,
          .packet_handler = telemetry_heartbeat_handler,
          .packed_handler = NULL,
          .user = NULL,
      },
  };

  result = sedsnet_hardware_crypto_init();
  if (result != SEDS_OK) {
    printf("Error: failed to register hardware crypto: %d\r\n", (int)result);
    return result;
  }

#ifdef TELEMETRY_USE_TLSF
  seds_set_memory_admission_probe_v2(telemetry_memory_admission_probe);
#endif
  result = board_packet_store_init();
  if (result != SEDS_OK) return result;

  /* Never try zstd payload compression on transmit. ZSTD_compress keeps a
   * 3.8 KiB context on the calling stack and then mallocs a workspace of at
   * least 18.9 KiB from the newlib heap, which here has 1,864 B free, so
   * every attempt failed after spending ~4.5 KiB of the router thread's stack
   * and the payload went out uncompressed anyway. */
  SedsRuntimeTuningConfig tuning;
  result = seds_get_runtime_tuning_config(&tuning);
  if (result != SEDS_OK) return result;
  tuning.payload_compress_threshold = SIZE_MAX;
  result = seds_set_runtime_tuning_config(&tuning);
  if (result != SEDS_OK) return result;

  /* Keep one clock origin through construction and initial queue service. */
  g_router.start_time = tx_raw_now_ms_locked();
  r = seds_router_new(node_now_since_ms, NULL, locals,
                      sizeof(locals) / sizeof(locals[0]));
  if (!r) {
    printf("Error: failed to create router\r\n");
    g_router.r = NULL;
    g_router.created = 0U;
#ifdef TELEMETRY_CAN_BUS
    g_can_side_id = -1;
#endif
#ifdef TELEMETRY_BOARD_LINK_UART
    g_board_link_side_id = -1;
#endif
    return SEDS_ERR;
  }

  if (seds_router_set_preferred_discovery_master(r, "GS", 2U) != SEDS_OK) {
    printf("Error: failed to prefer GroundStation discovery master\r\n");
    seds_router_free(r);
    return SEDS_ERR;
  }

#ifdef TELEMETRY_CAN_BUS
  g_can_side_id = seds_router_add_side_packed_profile_with_priority(
      r, "can", 3U, tx_send_with_priority, NULL, false,
      SEDS_SIDE_TRANSPORT_PROFILE_IPV6_LIKE, BOARD_CAN_MAX_FRAME_BYTES, 0U,
      BOARD_SIDE_TRANSPORT_TEMPLATES);
  if (g_can_side_id < 0) {
    printf("Error: failed to add CAN side: %ld\r\n", (long)g_can_side_id);
    g_can_side_id = -1;
  }
#endif

#ifdef TELEMETRY_BOARD_LINK_UART
  board_link_side_id =
      seds_router_add_side_packed(r, "board-link-uart", 5U, board_link_tx_send, NULL, true);
  g_board_link_side_id = board_link_side_id;
  if (board_link_side_id < 0) {
    printf("Error: failed to add board-link UART side: %ld\r\n", (long)board_link_side_id);
    g_board_link_side_id = -1;
  }
#endif

#ifdef TELEMETRY_CAN_BUS
  if (g_can_side_id < 0) {
#elif defined(TELEMETRY_BOARD_LINK_UART)
  if (board_link_side_id < 0) {
#else
  if (1) {
#endif
    printf("Error: relay requires configured telemetry sides\r\n");
    seds_router_free(r);
    g_router.r = NULL;
    g_router.created = 0U;
#ifdef TELEMETRY_CAN_BUS
    g_can_side_id = -1;
#endif
#ifdef TELEMETRY_BOARD_LINK_UART
    g_board_link_side_id = -1;
#endif
    return SEDS_ERR;
  }

#ifdef TELEMETRY_CAN_BUS
  /* This board's live load-cell stream must remain on CAN while discovery
   * loses/relearns GroundStation. Other types retain discovered routing. */
  result = seds_router_set_typed_route(r, -1, (uint32_t)SEDS_DT_KG1000,
                                       g_can_side_id, true);
  if (result == SEDS_OK)
    result = seds_router_set_typed_route(r, -1, (uint32_t)SEDS_DT_DAQ_LOADCELL_CHAMBER,
                                       g_can_side_id, true);
  if (result == SEDS_OK)
    result = seds_router_set_typed_route(r, -1, (uint32_t)SEDS_DT_KG50,
                                       g_can_side_id, true);
  if (result == SEDS_OK)
    result = seds_router_set_typed_route(r, -1, (uint32_t)SEDS_DT_DAQ_KG50_SELECTED,
                                       g_can_side_id, true);
  if (result == SEDS_OK)
    result = seds_router_set_typed_route(r, -1, (uint32_t)SEDS_DT_DAQ_ADC_TEMPERATURE,
                                       g_can_side_id, true);
  const uint32_t analog_types[] = {SEDS_DT_DAQ_SAR_VOLTAGES, SEDS_DT_DAQ_SDADC_VOLTAGES,
                                   SEDS_DT_DAQ_CURRENT_SENSE, SEDS_DT_DAQ_POWER_MONITOR};
  for (unsigned i = 0; result == SEDS_OK && i < sizeof(analog_types)/sizeof(analog_types[0]); ++i)
    result = seds_router_set_typed_route(r, -1, analog_types[i], g_can_side_id, true);
  if (result != SEDS_OK) {
    seds_router_free(r);
    g_can_side_id = -1;
    return result;
  }
#endif

  result = telemetry_configure_timesync_locked(r);
  if (result != SEDS_OK) {
    printf("Error: failed to configure telemetry timesync: %d\r\n", (int)result);
    seds_router_free(r);
    g_router.r = NULL;
    g_router.created = 0U;
#ifdef TELEMETRY_CAN_BUS
    g_can_side_id = -1;
#endif
#ifdef TELEMETRY_BOARD_LINK_UART
    g_board_link_side_id = -1;
#endif
    return result;
  }

  result = ota_stream_init(r);
  if (result != SEDS_OK) {
    printf("Error: failed to bind OTA stream: %d\r\n", (int)result);
    seds_router_free(r);
    g_router.r = NULL;
    g_router.created = 0U;
    return result;
  }
  /* Optional low-priority SD download service; a bind failure never takes
   * down telemetry, OTA or logging. */
  if (sd_file_stream_init(r) != SEDS_OK) {
    printf("Warning: SD download stream unavailable\r\n");
  }

  /* The normal poll loop sends the initial schema after link startup. */

  result = daq_calibration_init(r);
  if (result == SEDS_OK) result = daq_log_clock_init(r);
  if (result != SEDS_OK) {
    seds_router_free(r);
    g_router.r = NULL;
    return result;
  }
  g_discovery_schema_announced = 0U;
  g_discovery_schema_retry_ms = 0ULL;
  result = flight_state_cache_init(r);
  if (result != SEDS_OK) {
    seds_router_free(r);
    return result;
  }
  /* Publish only a complete router. RX and lazy producers share its mutex. */
  board_recovery_transport_set_router(r);
  g_router.r = r;
  g_router.created = 1U;
  return SEDS_OK;
#endif
}

static inline SedsElemKind guess_kind_from_elem_size(size_t elem_size) {
  if (elem_size == 4U || elem_size == 8U) {
    return SEDS_EK_FLOAT;
  }
  return SEDS_EK_UNSIGNED;
}
SedsResult init_telemetry_router(void)
{
#ifdef TELEMETRY_ENABLED
  if (!telemetry_router_enter()) return SEDS_BAD_ARG;
#endif
  SedsResult result;
#ifdef TELEMETRY_ENABLED
  const uint32_t now_ms = (uint32_t)tx_raw_now_ms_locked();
  if (g_router.created && g_router.r) {
    result = SEDS_OK;
  } else if (g_router_retry_after_ms != 0U &&
             (int32_t)(now_ms - g_router_retry_after_ms) < 0) {
    result = SEDS_IO;
  } else {
    result = init_telemetry_router_locked();
    if (result == SEDS_OK) {
      g_router_retry_after_ms = 0U;
    } else {
      g_router_retry_after_ms = now_ms + TELEMETRY_ROUTER_RETRY_MS;
      if (g_router_retry_after_ms == 0U) g_router_retry_after_ms = 1U;
    }
  }
  if (!telemetry_router_leave() && result == SEDS_OK) return SEDS_ERR;
#else
  result = init_telemetry_router_locked();
#endif
  return result;
}


static SedsResult log_telemetry_synchronous_locked(SedsDataType data_type, const void *data,
                                     size_t element_count, size_t element_size) {
#ifdef TELEMETRY_ENABLED
  if (!data || element_count == 0U || element_size == 0U) {
    return SEDS_BAD_ARG;
  }

  if (!g_router.r && init_telemetry_router() != SEDS_OK) {
    return SEDS_ERR;
  }

  return seds_router_log_typed(g_router.r, data_type, data, element_count, element_size,
                               guess_kind_from_elem_size(element_size));
#else
  (void)data_type;
  print_data_no_telem((void *)data, element_count * element_size);
  return SEDS_OK;
#endif
}

SedsResult log_telemetry_synchronous(SedsDataType data_type, const void *data,
                                     size_t element_count, size_t element_size) {
#ifdef TELEMETRY_ENABLED
  if (!telemetry_router_enter()) return SEDS_BAD_ARG;
#endif
  SedsResult result = log_telemetry_synchronous_locked(data_type, data, element_count, element_size);
#ifdef TELEMETRY_ENABLED
  if (!telemetry_router_leave() && result == SEDS_OK) return SEDS_ERR;
#endif
  return result;
}


static SedsResult log_telemetry_captured_locked(SedsDataType data_type, const void *data,
                                size_t element_count, size_t element_size,
                                uint64_t captured_monotonic_ms) {
#ifdef TELEMETRY_ENABLED
  if (!data || !element_count || !element_size) return SEDS_BAD_ARG;
  if (!g_router.r && init_telemetry_router() != SEDS_OK) return SEDS_ERR;
  uint64_t timestamp = 0ULL;
  const SedsResult clock_status = seds_router_get_network_time_ms(g_router.r, &timestamp);
  /* Read uptime after the network clock call, which may wait on router locks. */
  const uint64_t now = telemetry_now_ms();
  const uint64_t age = now >= captured_monotonic_ms ? now - captured_monotonic_ms : 0ULL;
  if (clock_status != SEDS_OK)
    timestamp = now >= g_router.start_time ? now - g_router.start_time : 0ULL;
  timestamp = timestamp >= age ? timestamp - age : 0ULL;
  return seds_router_log_typed_ex(g_router.r, data_type, data, element_count,
                                  element_size, guess_kind_from_elem_size(element_size),
                                  &timestamp, 1);
#else
  (void)captured_monotonic_ms;
  return log_telemetry_asynchronous(data_type, data, element_count, element_size);
#endif
}

SedsResult log_telemetry_captured(SedsDataType data_type, const void *data,
                                size_t element_count, size_t element_size,
                                uint64_t captured_monotonic_ms) {
#ifdef TELEMETRY_ENABLED
  if (!telemetry_router_enter()) return SEDS_BAD_ARG;
#endif
  SedsResult result = log_telemetry_captured_locked(data_type, data, element_count, element_size, captured_monotonic_ms);
#ifdef TELEMETRY_ENABLED
  if (!telemetry_router_leave() && result == SEDS_OK) return SEDS_ERR;
#endif
  return result;
}


static SedsResult log_telemetry_asynchronous_locked(SedsDataType data_type, const void *data,
                                      size_t element_count, size_t element_size) {
#ifdef TELEMETRY_ENABLED
  if (!data || element_count == 0U || element_size == 0U) {
    return SEDS_BAD_ARG;
  }

  if (!g_router.r && init_telemetry_router() != SEDS_OK) {
    return SEDS_ERR;
  }

  const SedsResult result = seds_router_log_queue_typed(
      g_router.r, data_type, data, element_count, element_size,
      guess_kind_from_elem_size(element_size));
#ifdef SEDS_FIRMWARE_SIM_TEST
  /* Preserve first and latest refusals in the existing simulator fault
   * buffer. This distinguishes bootstrap bursts from persistent queue pressure;
   * production RAM and the allocator-fault stack remain unchanged. */
  extern int32_t seds_router_copy_queue_counters(SedsRouter *, uint32_t *, size_t);
  extern volatile uint32_t g_telemetry_alloc_failure_stack[128];
  extern volatile uint32_t g_telemetry_alloc_failure_stack_words;
  if (result != SEDS_OK && (g_telemetry_alloc_failure_stack_words == 0U ||
      g_telemetry_alloc_failure_stack_words == 21U || g_telemetry_alloc_failure_stack_words == 85U || g_telemetry_alloc_failure_stack_words == 113U)) {
    uint32_t counters[16];
    if (seds_router_copy_memory_counters(g_router.r, counters, 16U) == 16) {
      const unsigned offset=g_telemetry_alloc_failure_stack_words==0U?0U:64U;
      for (unsigned i = 0U; i < 16U; ++i)
        g_telemetry_alloc_failure_stack[offset+i] = counters[i];
      g_telemetry_alloc_failure_stack[offset+16] = (uint32_t)result;
      g_telemetry_alloc_failure_stack[offset+17] = (uint32_t)data_type;
      g_telemetry_alloc_failure_stack[offset+18] = HAL_GetTick();
      g_telemetry_alloc_failure_stack[offset+19] = (uint32_t)element_count;
      g_telemetry_alloc_failure_stack[offset+20] = (uint32_t)seds_memory_admission_rejected();
      g_telemetry_alloc_failure_stack_words = offset+21U;
      if (seds_router_copy_queue_counters(g_router.r,counters,16U)==16) {
        for (unsigned i=0U;i<16U;++i)g_telemetry_alloc_failure_stack[96U+i]=counters[i];
        g_telemetry_alloc_failure_stack[112]=HAL_GetTick();
        g_telemetry_alloc_failure_stack_words=113U;
      }
    }
  }
#endif
  return result;
#else
  (void)data_type;
  print_data_no_telem((void *)data, element_count * element_size);
  return SEDS_OK;
#endif
}

SedsResult log_telemetry_asynchronous(SedsDataType data_type, const void *data,
                                      size_t element_count, size_t element_size) {
#ifdef TELEMETRY_ENABLED
  if (!telemetry_router_enter()) return SEDS_BAD_ARG;
#endif
  SedsResult result = log_telemetry_asynchronous_locked(data_type, data, element_count, element_size);
#ifdef TELEMETRY_ENABLED
  if (!telemetry_router_leave() && result == SEDS_OK) return SEDS_ERR;
#endif
  return result;
}


static SedsResult log_telemetry_string_asynchronous_locked(SedsDataType data_type, const char *str) {
#ifdef TELEMETRY_ENABLED
  if (!str) {
    return SEDS_BAD_ARG;
  }

  if (!g_router.r && init_telemetry_router() != SEDS_OK) {
    return SEDS_ERR;
  }

  return seds_router_log_string_ex(g_router.r, data_type, str, strlen(str), NULL, 1);
#else
  (void)data_type;
  (void)str;
  return SEDS_OK;
#endif
}

SedsResult log_telemetry_string_asynchronous(SedsDataType data_type, const char *str) {
#ifdef TELEMETRY_ENABLED
  if (!telemetry_router_enter()) return SEDS_BAD_ARG;
#endif
  SedsResult result = log_telemetry_string_asynchronous_locked(data_type, str);
#ifdef TELEMETRY_ENABLED
  if (!telemetry_router_leave() && result == SEDS_OK) return SEDS_ERR;
#endif
  return result;
}


static SedsResult log_telemetry_heartbeat_asynchronous_locked(void) {
#ifdef TELEMETRY_ENABLED
  static const uint8_t empty_payload = 0U;

  if (!g_router.r && init_telemetry_router() != SEDS_OK) {
    return SEDS_ERR;
  }

  return seds_router_log_bytes_ex(g_router.r, SEDS_DT_HEARTBEAT, &empty_payload, 0U, NULL, 1);
#else
  return SEDS_OK;
#endif
}

SedsResult log_telemetry_heartbeat_asynchronous(void) {
#ifdef TELEMETRY_ENABLED
  if (!telemetry_router_enter()) return SEDS_BAD_ARG;
#endif
  SedsResult result = log_telemetry_heartbeat_asynchronous_locked();
#ifdef TELEMETRY_ENABLED
  if (!telemetry_router_leave() && result == SEDS_OK) return SEDS_ERR;
#endif
  return result;
}


static SedsResult dispatch_tx_queue_locked(void) {
#ifndef TELEMETRY_ENABLED
  return SEDS_OK;
#else
  if (!g_router.r && init_telemetry_router() != SEDS_OK) {
    return SEDS_ERR;
  }

  return seds_router_process_tx_queue(g_router.r);
#endif
}

SedsResult dispatch_tx_queue(void) {
#ifdef TELEMETRY_ENABLED
  if (!telemetry_router_enter()) return SEDS_BAD_ARG;
#endif
  SedsResult result = dispatch_tx_queue_locked();
#ifdef TELEMETRY_ENABLED
  if (!telemetry_router_leave() && result == SEDS_OK) return SEDS_ERR;
#endif
  return result;
}


static SedsResult process_rx_queue_locked(void) {
#ifndef TELEMETRY_ENABLED
  return SEDS_OK;
#else
  if (!g_router.r && init_telemetry_router() != SEDS_OK) {
    return SEDS_ERR;
  }

  return seds_router_process_rx_queue(g_router.r);
#endif
}

SedsResult process_rx_queue(void) {
#ifdef TELEMETRY_ENABLED
  if (!telemetry_router_enter()) return SEDS_BAD_ARG;
#endif
  SedsResult result = process_rx_queue_locked();
#ifdef TELEMETRY_ENABLED
  if (!telemetry_router_leave() && result == SEDS_OK) return SEDS_ERR;
#endif
  return result;
}


static SedsResult dispatch_tx_queue_timeout_locked(uint32_t timeout_ms) {
#ifndef TELEMETRY_ENABLED
  (void)timeout_ms;
  return SEDS_OK;
#else
  if (!g_router.r && init_telemetry_router() != SEDS_OK) {
    return SEDS_ERR;
  }

  return seds_router_process_tx_queue_with_timeout(g_router.r, timeout_ms);
#endif
}

SedsResult dispatch_tx_queue_timeout(uint32_t timeout_ms) {
#ifdef TELEMETRY_ENABLED
  if (!telemetry_router_enter()) return SEDS_BAD_ARG;
#endif
  SedsResult result = dispatch_tx_queue_timeout_locked(timeout_ms);
#ifdef TELEMETRY_ENABLED
  if (!telemetry_router_leave() && result == SEDS_OK) return SEDS_ERR;
#endif
  return result;
}


static SedsResult process_rx_queue_timeout_locked(uint32_t timeout_ms) {
#ifndef TELEMETRY_ENABLED
  (void)timeout_ms;
  return SEDS_OK;
#else
  if (!g_router.r && init_telemetry_router() != SEDS_OK) {
    return SEDS_ERR;
  }

  return seds_router_process_rx_queue_with_timeout(g_router.r, timeout_ms);
#endif
}

SedsResult process_rx_queue_timeout(uint32_t timeout_ms) {
#ifdef TELEMETRY_ENABLED
  if (!telemetry_router_enter()) return SEDS_BAD_ARG;
#endif
  SedsResult result = process_rx_queue_timeout_locked(timeout_ms);
#ifdef TELEMETRY_ENABLED
  if (!telemetry_router_leave() && result == SEDS_OK) return SEDS_ERR;
#endif
  return result;
}


volatile uint32_t g_daq_queue_service_error_count = 0U;
volatile int32_t g_daq_queue_service_last_result = SEDS_OK;
static SedsResult process_all_queues_timeout_locked(uint32_t timeout_ms) {
#ifndef TELEMETRY_ENABLED
  (void)timeout_ms;
  return SEDS_OK;
#else
  if (!g_router.r && init_telemetry_router() != SEDS_OK) {
    return SEDS_ERR;
  }

  /* The worker explicitly polls board discovery and time sync once per pass.
   * Drain here without running the same maintenance a second time. */
  const SedsResult result = seds_router_drain_queues_with_timeout(g_router.r, timeout_ms);
  g_daq_queue_service_last_result = result;
  if (result != SEDS_OK) g_daq_queue_service_error_count++;
  return result;
#endif
}

SedsResult process_all_queues_timeout(uint32_t timeout_ms) {
#ifdef TELEMETRY_ENABLED
  if (!telemetry_router_enter()) return SEDS_BAD_ARG;
#endif
  SedsResult result = process_all_queues_timeout_locked(timeout_ms);
#ifdef TELEMETRY_ENABLED
  if (!telemetry_router_leave() && result == SEDS_OK) return SEDS_ERR;
#endif
  return result;
}


static SedsResult log_error_impl_locked(uint8_t queue, const char *fmt, va_list args) {
  va_list args_copy;
  int len = 0;
  int written = 0;

  if (!fmt) {
    return SEDS_BAD_ARG;
  }

  if (!g_router.r && init_telemetry_router() != SEDS_OK) {
    return SEDS_ERR;
  }

  va_copy(args_copy, args);
  len = vsnprintf(NULL, 0U, fmt, args_copy);
  va_end(args_copy);

  if (len < 0) {
    const char *empty = "";
    return seds_router_log_string_ex(g_router.r, SEDS_DT_TELEMETRY_ERROR, empty, 0U, NULL, queue);
  }

  if (len > 512) {
    len = 512;
  }

  char buf[(size_t)len + 1U];
  written = vsnprintf(buf, (size_t)len + 1U, fmt, args);
  if (written < 0) {
    const char *empty = "";
    return seds_router_log_string_ex(g_router.r, SEDS_DT_TELEMETRY_ERROR, empty, 0U, NULL, queue);
  }

  return seds_router_log_string_ex(g_router.r, SEDS_DT_TELEMETRY_ERROR, buf, (size_t)written,
                                   NULL, queue);
}

static SedsResult log_error_impl(uint8_t queue, const char *fmt, va_list args) {
#ifdef TELEMETRY_ENABLED
  if (!telemetry_router_enter()) return SEDS_BAD_ARG;
#endif
  SedsResult result = log_error_impl_locked(queue, fmt, args);
#ifdef TELEMETRY_ENABLED
  if (!telemetry_router_leave() && result == SEDS_OK) return SEDS_ERR;
#endif
  return result;
}


SedsResult log_error_asynchronous(const char *fmt, ...) {
#ifndef TELEMETRY_ENABLED
  (void)fmt;
  return SEDS_OK;
#else
  va_list args;
  SedsResult result;

  va_start(args, fmt);
  result = log_error_impl(1U, fmt, args);
  va_end(args);
  return result;
#endif
}

SedsResult log_error_synchronous(const char *fmt, ...) {
#ifndef TELEMETRY_ENABLED
  (void)fmt;
  return SEDS_OK;
#else
  va_list args;
  SedsResult result;

  va_start(args, fmt);
  result = log_error_impl(0U, fmt, args);
  va_end(args);
  return result;
#endif
}

SedsResult log_error_asyncronous(const char *fmt, ...) {
#ifndef TELEMETRY_ENABLED
  (void)fmt;
  return SEDS_OK;
#else
  va_list args;
  SedsResult result;

  va_start(args, fmt);
  result = log_error_impl(1U, fmt, args);
  va_end(args);
  return result;
#endif
}

SedsResult log_error_syncronous(const char *fmt, ...) {
#ifndef TELEMETRY_ENABLED
  (void)fmt;
  return SEDS_OK;
#else
  va_list args;
  SedsResult result;

  va_start(args, fmt);
  result = log_error_impl(0U, fmt, args);
  va_end(args);
  return result;
#endif
}

SedsResult print_telemetry_error(const int32_t error_code) {
#ifndef TELEMETRY_ENABLED
  (void)error_code;
  return SEDS_OK;
#else
  const int32_t need = seds_error_to_string_len(error_code);
  if (need <= 0) {
    return (SedsResult)need;
  }

  char buf[(size_t)need];
  SedsResult res = seds_error_to_string(error_code, buf, sizeof(buf));
  if (res == SEDS_OK) {
    printf("Error: %s\r\n", buf);
  } else {
    (void)log_error_asynchronous("Error: seds_error_to_string failed: %d\r\n", (int)res);
  }

  return res;
#endif
}

void die(const char *fmt, ...) {
  char buf[128];
  va_list args;

  va_start(args, fmt);
  vsnprintf(buf, sizeof(buf), fmt, args);
  va_end(args);

  while (1) {
    printf("FATAL: %s\r\n", buf);
    HAL_Delay(1000);
  }
}
