University-at-Buffalo-SEDS/DAQ-Board/Core/Src/telemetry_hooks.c

// telemetry_hooks_threadx.c
#include "tx_api.h"
#include <stddef.h>
#include <stdio.h>
#include <string.h>
#include "main.h"
#ifdef TELEMETRY_USE_TLSF
#include "telemetry_tlsf.h"
extern volatile uint32_t g_telemetry_tlsf_free_bytes, g_telemetry_tlsf_free_blocks;
extern volatile uint32_t g_telemetry_tlsf_live_bytes, g_telemetry_tlsf_region_bytes;
#endif

#ifndef TELEMETRY_USE_TLSF
static TX_BYTE_POOL *rust_byte_pool_external = NULL;
#endif
static TX_MUTEX g_telemetry_mutex;
static UINT g_telemetry_mutex_ready = 0U;
volatile uint32_t g_telemetry_lock_get_fail = 0U;
volatile uint32_t g_telemetry_lock_put_fail = 0U;
volatile uint32_t g_telemetry_alloc_fail = 0U;
volatile UINT g_telemetry_alloc_last_error = TX_SUCCESS;
volatile size_t g_telemetry_alloc_failed_size = 0U;
#ifdef SEDS_FIRMWARE_SIM_TEST
volatile uint32_t g_telemetry_alloc_failure_psp;
volatile uint32_t g_telemetry_alloc_failure_stack[128];
volatile uint32_t g_telemetry_alloc_failure_stack_words;
#endif
volatile uint32_t g_telemetry_panic_count = 0U;
volatile uint32_t g_telemetry_alloc_count = 0U;
volatile uint32_t g_telemetry_free_count = 0U;
volatile ULONG g_telemetry_pool_available = 0U;
volatile ULONG g_telemetry_pool_low_water = ~0UL;
volatile ULONG g_telemetry_pool_fragments = 0U;
static volatile uint8_t g_last_err_memory_hint = 0U;
static volatile uint8_t g_last_err_mutex_hint = 0U;

static void telemetry_busy_delay(volatile uint32_t n)
{
    while (n--) { __NOP(); }
}

static void telemetry_panic_led_loop_memory(void)
{
    __disable_irq();
    for (;;)
    {
        /* Memory panic: two BLUE pulses, GREEN off, then pause. */
        // HAL_GPIO_WritePin(GREEN_LED_GPIO_Port, GREEN_LED_Pin, GPIO_PIN_RESET);
        // HAL_GPIO_WritePin(BLUE_LEDS_GPIO_Port, BLUE_LEDS_Pin, GPIO_PIN_SET);
        telemetry_busy_delay(9000000U);
        // HAL_GPIO_WritePin(BLUE_LEDS_GPIO_Port, BLUE_LEDS_Pin, GPIO_PIN_RESET);
        telemetry_busy_delay(5000000U);
        // HAL_GPIO_WritePin(BLUE_LEDS_GPIO_Port, BLUE_LEDS_Pin, GPIO_PIN_SET);
        telemetry_busy_delay(9000000U);
        // HAL_GPIO_WritePin(BLUE_LEDS_GPIO_Port, BLUE_LEDS_Pin, GPIO_PIN_RESET);
        telemetry_busy_delay(25000000U);
    }
}

static void telemetry_panic_led_loop_mutex(void)
{
    __disable_irq();
    for (;;)
    {
        /* Mutex panic: two GREEN pulses, BLUE off, then pause. */
        // HAL_GPIO_WritePin(BLUE_LEDS_GPIO_Port, BLUE_LEDS_Pin, GPIO_PIN_RESET);
        // HAL_GPIO_WritePin(GREEN_LED_GPIO_Port, GREEN_LED_Pin, GPIO_PIN_SET);
        telemetry_busy_delay(9000000U);
        // HAL_GPIO_WritePin(GREEN_LED_GPIO_Port, GREEN_LED_Pin, GPIO_PIN_RESET);
        telemetry_busy_delay(5000000U);
        // HAL_GPIO_WritePin(GREEN_LED_GPIO_Port, GREEN_LED_Pin, GPIO_PIN_SET);
        telemetry_busy_delay(9000000U);
        // HAL_GPIO_WritePin(GREEN_LED_GPIO_Port, GREEN_LED_Pin, GPIO_PIN_RESET);
        telemetry_busy_delay(25000000U);
    }
}

static void telemetry_panic_led_loop_unknown(void)
{
    __disable_irq();
    for (;;)
    {
        /* Unknown panic: alternating BLUE/GREEN. */
        // HAL_GPIO_WritePin(BLUE_LEDS_GPIO_Port, BLUE_LEDS_Pin, GPIO_PIN_SET);
        // HAL_GPIO_WritePin(GREEN_LED_GPIO_Port, GREEN_LED_Pin, GPIO_PIN_RESET);
        telemetry_busy_delay(12000000U);
        // HAL_GPIO_WritePin(BLUE_LEDS_GPIO_Port, BLUE_LEDS_Pin, GPIO_PIN_RESET);
        // HAL_GPIO_WritePin(GREEN_LED_GPIO_Port, GREEN_LED_Pin, GPIO_PIN_SET);
        telemetry_busy_delay(12000000U);
    }
}

static int str_contains_ci_n(const char *s, size_t n, const char *needle)
{
    if (!s || !needle) return 0;
    size_t needle_len = strlen(needle);
    if (needle_len == 0U || n < needle_len) return 0;

    for (size_t i = 0; i + needle_len <= n; ++i)
    {
        size_t j = 0;
        for (; j < needle_len; ++j)
        {
            char a = s[i + j];
            char b = needle[j];
            if (a >= 'A' && a <= 'Z') a = (char)(a - 'A' + 'a');
            if (b >= 'A' && b <= 'Z') b = (char)(b - 'A' + 'a');
            if (a != b) break;
        }
        if (j == needle_len) return 1;
    }
    return 0;
}

static void telemetry_memory_profile_sample(void)
{
#ifdef TELEMETRY_USE_TLSF
    /* No heap walk in allocation hot paths. Exact snapshots are captured on failure. */
    ULONG available = g_telemetry_tlsf_region_bytes > g_telemetry_tlsf_live_bytes ?
        g_telemetry_tlsf_region_bytes - g_telemetry_tlsf_live_bytes : 0U;
    g_telemetry_pool_available = available;
    g_telemetry_pool_fragments = g_telemetry_tlsf_free_blocks;
    if (available < g_telemetry_pool_low_water) g_telemetry_pool_low_water = available;
#else

    ULONG available = 0U;
    ULONG fragments = 0U;
    if (rust_byte_pool_external != NULL &&
        tx_byte_pool_info_get(rust_byte_pool_external, TX_NULL,
                              &available, &fragments,
                              TX_NULL, TX_NULL, TX_NULL) == TX_SUCCESS)
    {
        g_telemetry_pool_available = available;
        g_telemetry_pool_fragments = fragments;
        if (available < g_telemetry_pool_low_water)
        {
            g_telemetry_pool_low_water = available;
        }
    }
#endif
}

void telemetry_set_byte_pool(TX_BYTE_POOL *pool)
{
#ifdef TELEMETRY_USE_TLSF
    telemetry_tlsf_register_pool(pool);
#else
    rust_byte_pool_external = pool;
    telemetry_memory_profile_sample();
#endif
}

void telemetry_init_lock(void)
{
    if (g_telemetry_mutex_ready == 0U)
    {
        if (tx_mutex_create(&g_telemetry_mutex, "telemetry_mutex", TX_INHERIT) == TX_SUCCESS)
        {
            g_telemetry_mutex_ready = 1U;
        }
    }
}
void telemetry_lock(void)
{
    if (g_telemetry_mutex_ready == 0U)
    {
        return;
    }

    TX_THREAD *self = tx_thread_identify();
    if (self == TX_NULL)
    {
        /* Never block in ISR/startup context. */
        return;
    }

    UINT st = tx_mutex_get(&g_telemetry_mutex, TX_WAIT_FOREVER);
    if (st != TX_SUCCESS)
    {
        g_telemetry_lock_get_fail++;
    }
}

void telemetry_unlock(void)
{
    if (g_telemetry_mutex_ready == 0U)
    {
        return;
    }

    TX_THREAD *self = tx_thread_identify();
    if (self == TX_NULL)
    {
        /* Never block/touch mutex in ISR/startup context. */
        return;
    }

    UINT st = tx_mutex_put(&g_telemetry_mutex);
    if (st != TX_SUCCESS)
    {
        g_telemetry_lock_put_fail++;
    }
}

/* C application ownership is checked separately from the unchanged Rust ABI
 * hooks. Reuse the recursive ThreadX mutex without adding shadow owner state. */
#ifdef TELEMETRY_ENABLED
int telemetry_router_context_ready(void)
{
    return g_telemetry_mutex_ready != 0U && __get_IPSR() == 0U && tx_thread_identify() != TX_NULL;
}

int telemetry_router_enter(void)
{
    if (!telemetry_router_context_ready()) return 0;
    if (tx_mutex_get(&g_telemetry_mutex, TX_WAIT_FOREVER) != TX_SUCCESS) {
        ++g_telemetry_lock_get_fail;
        return 0;
    }
    return 1;
}

int telemetry_router_leave(void)
{
    if (tx_mutex_put(&g_telemetry_mutex) != TX_SUCCESS) {
        ++g_telemetry_lock_put_fail;
        return 0;
    }
    return 1;
}
#endif

void *telemetryMalloc(size_t xSize)
{
#ifdef TELEMETRY_USE_TLSF
    void *ptr = telemetry_tlsf_malloc(xSize);
    if (ptr) ++g_telemetry_alloc_count;
    else {
        ++g_telemetry_alloc_fail;
        g_telemetry_alloc_failed_size = xSize;
#ifdef SEDS_FIRMWARE_SIM_TEST
        const uint32_t psp = __get_PSP();
        TX_THREAD *thread = tx_thread_identify();
        g_telemetry_alloc_failure_psp = psp;
        g_telemetry_alloc_failure_stack_words = 0U;
        if (thread != TX_NULL && psp >= (uintptr_t)thread->tx_thread_stack_start &&
            psp <= (uintptr_t)thread->tx_thread_stack_end) {
            const size_t words = ((uintptr_t)thread->tx_thread_stack_end - psp + 1U) / 4U;
            const size_t count = words < 128U ? words : 128U;
            const volatile uint32_t *stack = (const volatile uint32_t *)(uintptr_t)psp;
            for (size_t i = 0; i < count; ++i)
                g_telemetry_alloc_failure_stack[i] = stack[i];
            g_telemetry_alloc_failure_stack_words = count;
        }
#endif
    }
    telemetry_memory_profile_sample();
    return ptr;
#else
    void *ptr = NULL;

    /* Defensive: if byte pool isn't registered yet, return NULL */
    if (rust_byte_pool_external == NULL)
    {
        return NULL;
    }

    if (xSize == 0U)
    {
        /* Rust allocator contract expects non-NULL for successful alloc. */
        xSize = 1U;
    }

    /* Allocation runs under router locks. Sleeping here cannot let another
     * router caller release memory and delays acquisition behind that lock. */
    const UINT status = tx_byte_allocate(rust_byte_pool_external, &ptr, xSize, TX_NO_WAIT);
    if (status != TX_SUCCESS)
    {
        g_telemetry_alloc_last_error = status;
        g_telemetry_alloc_failed_size = xSize;
        g_telemetry_alloc_fail++;
        return NULL;
    }
    g_telemetry_alloc_count++;
    telemetry_memory_profile_sample();
    return ptr;
#endif
}

/* CAN's async queue uses fallible foreground allocations, never ISR heap
 * work. Leave at least 4 KiB available for router dispatch/control traffic. */
void *telemetry_can_tx_allocate(size_t bytes)
{
#ifdef TELEMETRY_USE_TLSF
    if (!telemetry_tlsf_admit(bytes + 512U, bytes)) return NULL;
#else
    ULONG available = 0U;
    if (!rust_byte_pool_external ||
        tx_byte_pool_info_get(rust_byte_pool_external, TX_NULL, &available,
                             TX_NULL, TX_NULL, TX_NULL, TX_NULL) != TX_SUCCESS)
        return NULL;
    if (bytes > (size_t)available || (size_t)available - bytes < 4096U)
        return NULL;
#endif
    return telemetryMalloc(bytes);
}

/* Only bounded priority CAN packets may borrow control headroom. Bulk queue
 * copies and diagnostic exports retain the ordinary 4 KiB reserve. */
void *telemetry_can_tx_allocate_priority(size_t bytes, uint8_t protected_control)
{
    if (!protected_control || bytes == 0U || bytes > 160U)
        return telemetry_can_tx_allocate(bytes);
#ifdef TELEMETRY_USE_TLSF
    if (!telemetry_tlsf_admit_can_control(bytes)) return NULL;
#else
    ULONG available = 0U;
    if (!rust_byte_pool_external ||
        tx_byte_pool_info_get(rust_byte_pool_external, TX_NULL, &available,
                             TX_NULL, TX_NULL, TX_NULL, TX_NULL) != TX_SUCCESS)
        return NULL;
    const size_t free_bytes = (size_t)available;
    const size_t working = bytes + 512U;
    if (working > free_bytes || free_bytes - working < 512U) return NULL;
#endif
    return telemetryMalloc(bytes);
}

void telemetryFree(void *pv)
{
#ifdef TELEMETRY_USE_TLSF
    if (pv) {
        telemetry_tlsf_free(pv);
        ++g_telemetry_free_count;
        telemetry_memory_profile_sample();
    }
#else
    if (pv != NULL)
    {
        (void)tx_byte_release(pv);
        g_telemetry_free_count++;
        telemetry_memory_profile_sample();
    }
#endif
}

void seds_error_msg(const char *str, size_t len)
{
    if (str != NULL && len > 0U)
    {
        g_last_err_memory_hint = (uint8_t)(
            str_contains_ci_n(str, len, "alloc") ||
            str_contains_ci_n(str, len, "memory") ||
            str_contains_ci_n(str, len, "oom"));
        g_last_err_mutex_hint = (uint8_t)(
            str_contains_ci_n(str, len, "mutex") ||
            str_contains_ci_n(str, len, "lock"));
        printf("%.*s\r\n", (int)len, str);
    }
}

void telemetry_panic_hook(const char *str, size_t len)
{
    g_telemetry_panic_count++;

    if (str != NULL && len > 0U)
    {
        // printf("PANIC: %.*s\r\n", (int)len, str);
    }

    /* Prefer explicit text match if available. */
    if ((str != NULL && len > 0U &&
         (str_contains_ci_n(str, len, "alloc") || str_contains_ci_n(str, len, "memory"))) ||
        (g_last_err_memory_hint != 0U) ||
        (g_telemetry_alloc_fail != 0U))
    {
        telemetry_panic_led_loop_memory();
    }

    if ((str != NULL && len > 0U &&
         (str_contains_ci_n(str, len, "mutex") || str_contains_ci_n(str, len, "lock"))) ||
        (g_last_err_mutex_hint != 0U) ||
        ((g_telemetry_lock_get_fail + g_telemetry_lock_put_fail) != 0U))
    {
        telemetry_panic_led_loop_mutex();
    }

    telemetry_panic_led_loop_unknown();
    
}
