University-at-Buffalo-SEDS/DAQ-Board/Core/Inc/daq_rates.h

#ifndef DAQ_RATES_H
#define DAQ_RATES_H
#include <stdint.h>
#include "daq_chamber_pressure.h"

/* Board-local settings. No network variables; rebuild/reflash to change.
 * MCLK is the physical CubeMX MCO output and must match the board clock. */
#ifndef DAQ_ADC_OSR
#if DAQ_CHAMBER_SCAN_MASK != 0U
/* SCAN conversions settle per channel, doubled by AZ_MUX. At16MHz,
 * OSR256 allows three fresh channels without reducing either load cell's
 * former OSR1024/two-channel fresh-sample density. Gain/scale stay unchanged. */
#define DAQ_ADC_OSR 256U
#else
#define DAQ_ADC_OSR 1024U
#endif
#endif
#ifndef DAQ_ADC_READ_RATE_HZ
#if DAQ_CHAMBER_SCAN_MASK != 0U
#define DAQ_ADC_READ_RATE_HZ 5556U
#else
#define DAQ_ADC_READ_RATE_HZ 3700U
#endif
#endif
#ifndef DAQ_ACQUISITION_PERIOD_MS
#define DAQ_ACQUISITION_PERIOD_MS 2U
#endif
#ifndef DAQ_BROADCAST_RATE_HZ
#define DAQ_BROADCAST_RATE_HZ 250U
#endif
/* DRDY controls actual reads. This legacy rate setting conservatively sizes
 * acquisition drains/batches; it does not program a timer or ADC conversion.
 * Three-channel defaults also budget settled SCAN time and AZ_MUX above. */
#if DAQ_CHAMBER_SCAN_MASK != 0U && DAQ_ADC_READ_RATE_HZ < 5556U
#error "Chamber fast scan requires DAQ_ADC_READ_RATE_HZ>=5556 and a compatible OSR; current settings would slow load cells"
#endif
#define DAQ_ADC_MCLK_HZ 16000000U
/* Temperature must refresh independently of acquisition-loop overruns. */
#define DAQ_TEMPERATURE_REPORT_PERIOD_MS 100U
/* Auxiliary channels run at 10 Hz; they do not need the load-cell cadence. */
#ifndef DAQ_ANALOG_REPORT_PERIOD_MS
#define DAQ_ANALOG_REPORT_PERIOD_MS 100U
#endif
#if DAQ_ANALOG_REPORT_PERIOD_MS < 100U || DAQ_ANALOG_REPORT_PERIOD_MS > 1000U
#error "Auxiliary analog period must be 100..1000 ms"
#endif
/* Acquisition outranks the I/O workers so reporting or SD backlogs cannot
 * consume its service budget. Live I/O workers share a bounded slice; storage
 * runs below them and sleeps for DMA. ADC interrupts remain independent. */
#define DAQ_IO_THREAD_PRIORITY 6U
/* Storage never runs at acquisition/report/network priority. */
#define DAQ_SD_WRITER_THREAD_PRIORITY 7U
#define DAQ_ACQUISITION_THREAD_PRIORITY 5U
#define DAQ_IO_THREAD_SLICE_MS 1U
/* Size each SD batch for the service interval plus bounded scheduling slack.
 * Keeping 96 records per 2 ms slot would waste most of the RAM reserve. */
#define DAQ_RAW_BATCH_CAPACITY (((DAQ_ADC_READ_RATE_HZ * DAQ_ACQUISITION_PERIOD_MS + 999U) / 1000U) + 4U)
/* Reserve for intermittent card/filesystem stalls, independent of network
 * cadence. The former 200 ms reserve overflowed during sustained bench runs. */
#ifndef DAQ_SD_RAW_BUFFER_MS
#define DAQ_SD_RAW_BUFFER_MS 800U
#endif
/* Full-batch equivalents used to budget the compact byte pool. The actual
 * pointer queue can hold more, smaller batches within that same RAM budget. */
#define DAQ_SD_RAW_QUEUE_DEPTH ((DAQ_SD_RAW_BUFFER_MS + DAQ_ACQUISITION_PERIOD_MS - 1U) / DAQ_ACQUISITION_PERIOD_MS + 1U)
#if DAQ_SD_RAW_QUEUE_DEPTH < 2 || DAQ_SD_RAW_QUEUE_DEPTH > 512
#error "SD raw reserve must fit between 2 and 512 batches"
#endif

#if DAQ_ADC_OSR == 32
#define DAQ_ADC_OSR_BITS 0U
#elif DAQ_ADC_OSR == 64
#define DAQ_ADC_OSR_BITS 1U
#elif DAQ_ADC_OSR == 128
#define DAQ_ADC_OSR_BITS 2U
#elif DAQ_ADC_OSR == 256
#define DAQ_ADC_OSR_BITS 3U
#elif DAQ_ADC_OSR == 512
#define DAQ_ADC_OSR_BITS 4U
#elif DAQ_ADC_OSR == 1024
#define DAQ_ADC_OSR_BITS 5U
#elif DAQ_ADC_OSR == 2048
#define DAQ_ADC_OSR_BITS 6U
#elif DAQ_ADC_OSR == 4096
#define DAQ_ADC_OSR_BITS 7U
#else
#error "Unsupported DAQ_ADC_OSR (choose a power of two from 32 to 4096)"
#endif
#if DAQ_ADC_READ_RATE_HZ < 1 || DAQ_ADC_READ_RATE_HZ > 12000
#error "DAQ_ADC_READ_RATE_HZ must be from 1 to 12000"
#endif
#if DAQ_ADC_READ_RATE_HZ > DAQ_ADC_MCLK_HZ / (4U * DAQ_ADC_OSR)
#error "ADC read rate exceeds conversion rate; reduce DAQ_ADC_OSR or read rate"
#endif
#if DAQ_ACQUISITION_PERIOD_MS < 1 || DAQ_ACQUISITION_PERIOD_MS > 1000
#error "DAQ_ACQUISITION_PERIOD_MS must be from 1 to 1000"
#endif
#if (DAQ_ADC_READ_RATE_HZ * DAQ_ACQUISITION_PERIOD_MS + 999U) / 1000U > DAQ_RAW_BATCH_CAPACITY
#error "ADC drain batch too small; reduce DAQ_ACQUISITION_PERIOD_MS"
#endif
#if DAQ_BROADCAST_RATE_HZ < 1 || DAQ_BROADCAST_RATE_HZ > 1000 / DAQ_ACQUISITION_PERIOD_MS
#error "DAQ_BROADCAST_RATE_HZ must not exceed the acquisition service rate"
#endif
#define DAQ_ADC_READ_INTERVAL_US ((1000000U + DAQ_ADC_READ_RATE_HZ - 1U) / DAQ_ADC_READ_RATE_HZ)
/* Datasheet Table 5-15: initial SINC3/SINC1 conversion settling. */
#define DAQ_ADC_SETTLE_CLOCKS ((DAQ_ADC_OSR <= 512U) ? (3U * DAQ_ADC_OSR) : (DAQ_ADC_OSR + 1024U))
#define DAQ_ADC_FIRST_CONVERSION_US ((DAQ_ADC_SETTLE_CLOCKS * 1000000ULL * 4U + DAQ_ADC_MCLK_HZ - 1U) / DAQ_ADC_MCLK_HZ + 32U)
#define DAQ_BROADCAST_PERIOD_MS ((1000U + DAQ_BROADCAST_RATE_HZ - 1U) / DAQ_BROADCAST_RATE_HZ)
#endif
