University-at-Buffalo-SEDS/DAQ-Board/build.py

#!/usr/bin/env python3
"""
Unified build + flash helper for CMake (Ninja) embedded projects.

Features
- Detect repo root by searching upwards for CMakeLists.txt
- Read project name from CMakeLists.txt `project(<name> ...)`
- Build Debug/Release with a toolchain file
- Generate .bin from .elf via arm-none-eabi-objcopy
- Flash via:
    * dfu-util (DFU)
    * st-flash (ST-LINK USB dongle, stlink tools)
    * st-util + arm-none-eabi-gdb (ST-LINK server + GDB "load")
    * ST-LINK_gdbserver + arm-none-eabi-gdb (CubeProgrammer gdbserver / ST-LINK server)
    * STM32_Programmer_CLI (STM32CubeProgrammer direct flash)
- Friendly, non-traceback error messages by default

Usage examples
  ./scripts/build.py build --make sure the can bus timings for the debug
  ./scripts/build.py build --release --no-telemetry
  ./scripts/build.py flash --debug --method st-flash
  ./scripts/build.py flash --release --method st-util --device /dev/ttyACM0
"""
from __future__ import annotations

import argparse
import io
import os
import re
import shlex
import shutil
import socket
import subprocess
import sys
import time
from dataclasses import dataclass
from pathlib import Path
from typing import Iterable, Optional


# ---------------------------
# UI / formatting (emoji-safe)
# ---------------------------

import stat


# Internal implementation of `build.py clean`; no separate cleanup command.
def format_reclaimed(size: int) -> str:
    amount = float(size)
    for unit in ('B', 'KiB', 'MiB', 'GiB', 'TiB'):
        if amount < 1024 or unit == 'TiB':
            return f'{size} B' if unit == 'B' else f'{amount:.2f} {unit}'
        amount /= 1024

def clean_generated(build_root: Path, target: Path) -> tuple[list[Path], int]:
    build_root = Path(os.path.abspath(build_root))
    repo_root = build_root.parent
    target = Path(os.path.abspath(target))
    try:
        target.relative_to(build_root)
    except ValueError as error:
        raise ValueError(f'Refusing to clean outside the build directory: {target}') from error
    crc_root = repo_root / 'third_party' / 'embedded-crc32fast'
    candidates = [target, crc_root / 'target', crc_root / 'Cargo.lock']
    # Validate every ancestor before removing anything. Never follow a generated
    # directory (or a third_party parent) symlink into unrelated source/artifacts.
    for path in candidates:
        relative = path.relative_to(repo_root)
        current = repo_root
        for part in relative.parts:
            current /= part
            if current.is_symlink():
                raise ValueError(f'Refusing to clean through a symbolic link: {current}')
    present = [path for path in candidates if path.exists()]
    inodes = {}
    for path in present:
        files = (Path(folder) / name for folder, _, names in os.walk(path)
                 for name in names) if path.is_dir() else [path]
        for file in files:
            info = file.lstat()
            if not stat.S_ISREG(info.st_mode):
                continue
            key = (info.st_dev, info.st_ino)
            previous = inodes.get(key, (info, 0))
            inodes[key] = (info, previous[1] + 1)
    # Hard links only free storage when all links are removed. APFS clones and
    # snapshots can retain blocks, so the displayed total is an estimate.
    reclaimed = sum(getattr(info, 'st_blocks', None) * 512
                    if hasattr(info, 'st_blocks') else info.st_size
                    for info, count in inodes.values() if count >= info.st_nlink)
    for path in present:
        if path.is_dir():
            shutil.rmtree(path)
        else:
            path.unlink()
    return present, reclaimed


def _supports_unicode() -> bool:
    enc = (sys.stdout.encoding or "").lower()
    if "utf" not in enc:
        return False
    # If piped, some envs lie about encoding; keep conservative:
    return sys.stdout.isatty()


@dataclass(frozen=True)
class UI:
    emoji: str  # "auto" | "on" | "off"

    def sym(self, kind: str) -> str:
        use_emoji = (self.emoji == "on") or (self.emoji == "auto" and _supports_unicode())
        if not use_emoji:
            return {
                "ok": "[OK]",
                "warn": "[WARN]",
                "err": "[ERR]",
                "run": "[RUN]",
                "info": "[INFO]",
            }.get(kind, "[*]")
        return {
            "ok": "✅",
            "warn": "⚠️ ",
            "err": "❌",
            "run": "▶️ ",
            "info": "ℹ️ ",
        }.get(kind, "•")

    def say(self, kind: str, msg: str) -> None:
        print(f"{self.sym(kind)} {msg}")


# ---------------------------
# Errors (no raw tracebacks)
# ---------------------------

class FriendlyError(RuntimeError):
    pass


def die(ui: UI, msg: str, code: int = 2) -> None:
    ui.say("err", msg)
    raise SystemExit(code)


def _wrap_unhandled(ui: UI):
    def excepthook(exc_type, exc, tb):
        # For FriendlyError and SystemExit, let normal flow handle it.
        if isinstance(exc, SystemExit):
            raise exc
        if isinstance(exc, FriendlyError):
            die(ui, str(exc), code=2)
        # Otherwise, hide traceback and show hint.
        die(ui, f"Unexpected error: {exc_type.__name__}: {exc}\n"
                f"Tip: re-run with --trace to see a full traceback.", code=2)
    return excepthook


# ---------------------------
# Utilities
# ---------------------------

def which(cmd: str) -> Optional[str]:
    from shutil import which as _which
    return _which(cmd)


def run(ui: UI, cmd: list[str], cwd: Optional[Path] = None, env: Optional[dict[str, str]] = None) -> None:
    ui.say("run", " ".join(shlex.quote(c) for c in cmd))
    try:
        subprocess.run(cmd, check=True, cwd=str(cwd) if cwd else None, env=env)
    except FileNotFoundError:
        raise FriendlyError(f"Command not found: {cmd[0]}\n"
                            f"Make sure it's installed and on PATH.")
    except subprocess.CalledProcessError as e:
        raise FriendlyError(f"Command failed (exit {e.returncode}): {cmd[0]}\n"
                            f"See output above for details.")


def popen(ui: UI, cmd: list[str], cwd: Optional[Path] = None) -> subprocess.Popen:
    ui.say("run", " ".join(shlex.quote(c) for c in cmd))
    try:
        return subprocess.Popen(cmd, cwd=str(cwd) if cwd else None)
    except FileNotFoundError:
        raise FriendlyError(f"Command not found: {cmd[0]}\n"
                            f"Make sure it's installed and on PATH.")




def run_gtests(ui: UI, repo_root: Path) -> None:
    source = repo_root / "tests" / "gtest"
    if not (source / "CMakeLists.txt").is_file():
        raise FriendlyError(
            "GoogleTest suite is missing (expected tests/gtest/CMakeLists.txt)."
        )
    cmake = which("cmake")
    if cmake is None:
        raise FriendlyError(
            "CMake is required for GoogleTest.\n"
            "Install CMake and ensure the 'cmake' command is on PATH."
        )
    build_dir = repo_root / "build" / "host-gtests"
    generator = "Ninja" if which("ninja") else "Unix Makefiles"
    run(ui, [cmake, "-S", str(source), "-B", str(build_dir), "-G", generator],
        cwd=repo_root)
    run(ui, [cmake, "--build", str(build_dir), "--parallel"], cwd=repo_root)
    run(ui, ["ctest", "--test-dir", str(build_dir), "--output-on-failure",
             "--no-tests=error"],
        cwd=repo_root)


def _test_failure_help(stage: str) -> str:
    if stage == "Docker readiness":
        return (
            "Start Docker Desktop/the Docker daemon, then verify 'docker info' works.\n"
            "If the registry image is unavailable, the runner will clone and build "
            "FirmwareSimulator locally."
        )
    if stage == "GoogleTest unit tests":
        return (
            "Install CMake and a C++17 compiler. GoogleTest is discovered locally "
            "or fetched automatically during configure.\n"
            "Re-run with --trace if configure or compilation details are needed."
        )
    if stage == "Host and Python unit tests":
        return (
            "Read the first failing assertion above and run that test directly.\n"
            "For Python: python3 -m unittest discover -s tests -p 'test_*.py'."
        )
    if stage in {"Factory firmware build", "OTA package build"}:
        return (
            "Confirm the ARM GNU toolchain, CMake, Ninja, Rust, and Cargo are on PATH.\n"
            "Remove only this board's selected build directory if its CMake cache is stale."
        )
    if stage == "Long-duration memory profile":
        return (
            "Inspect the memory-probe table for pool loss, low-water, allocation failures, "
            "or stack errors. A falling reserve usually indicates a missing free or queue drain."
        )
    if stage == "Disconnected CAN survival":
        return ("Inspect CAN TX-failure and stack probes. The board must remain alive when no "
                "peer acknowledges its transmissions; repeated transport errors must be bounded.")
    if stage == "Network discovery and time sync":
        return (
            "Check that this board and its RF/Power peer export network_ready, use the configured "
            "FDCAN peripheral, and reach discovery plus a valid SEDSNet network clock."
        )
    return (
        "Review the simulator matrix above for the failing row. Check missing ELF symbols, "
        "memory thresholds, peripheral configuration, and boot/OTA artifact paths.\n"
        "Re-run with --trace for a Python traceback."
    )


def _print_test_summary(ui: UI, results: list[tuple[str, str]]) -> None:
    width = max([len("Test stage"), *(len(name) for name, _ in results)])
    print("\nFirmware test summary")
    print(f"{'Test stage':<{width}}  Result")
    print(f"{'-' * width}  ------")
    for name, result in results:
        print(f"{name:<{width}}  {result}")
    passed = sum(result == "PASS" for _, result in results)
    if passed == len(results):
        ui.say("ok", f"All {passed} test stages passed.")
    else:
        ui.say("err", f"{passed}/{len(results)} completed test stages passed.")


def _run_test_stage(ui: UI, results: list[tuple[str, str]], stage: str,
                    action) -> None:
    try:
        action()
    except Exception as exc:
        results.append((stage, "FAIL"))
        _print_test_summary(ui, results)
        detail = str(exc).strip() or type(exc).__name__
        raise FriendlyError(
            f"{stage} failed.\n\nPossible solutions:\n"
            f"- {_test_failure_help(stage)}\n\nDetails: {detail}"
        ) from None
    results.append((stage, "PASS"))


def find_repo_root(start: Path) -> Path:
    p = start.resolve()
    for cand in [p, *p.parents]:
        if (cand / "CMakeLists.txt").is_file():
            return cand
    raise FriendlyError(f"Could not find CMakeLists.txt when searching from: {start}")


def run_host_tests(ui: UI, repo_root: Path) -> None:
    # Native ownership tests link the real matching SDK. No manual archive
    # flag is required; source selection and host builds use an owned cache.
    import runpy
    try:
        runpy.run_path(str(repo_root / "tests/native_sdk.py"))["prepare_native_sdk"](repo_root)
    except (RuntimeError, OSError, ValueError, KeyError) as error:
        raise FriendlyError("Host SDK native prerequisite: " + str(error)) from None
    tests = repo_root / "tests"
    if tests.is_dir():
        run(ui, [sys.executable, "-m", "unittest", "discover", "-s", "tests",
                 "-p", "test_*.py"], cwd=repo_root)


# --- CMake parsing helpers ---
# We intentionally keep this parser "simple but practical" (no full CMake eval),
# covering the patterns most embedded templates use (CubeMX included).

_COMMENT_RE = re.compile(r"(?m)#.*$")

# Matches: set(VAR value) or set(VAR "value")
_SET_RE = re.compile(
    r"(?is)\bset\s*\(\s*([A-Za-z0-9_]+)\s+(.+?)\s*\)",
)

# Matches: project(name ...) or project(${VAR} ...)
_PROJECT_CALL_RE = re.compile(
    r"(?is)\bproject\s*\(\s*([^\s\)]+)",
)

_VAR_REF_RE = re.compile(r"^\$\{([A-Za-z0-9_]+)\}$")


def _strip_quotes(s: str) -> str:
    s = s.strip()
    if (len(s) >= 2) and ((s[0] == s[-1] == '"') or (s[0] == s[-1] == "'")):
        return s[1:-1].strip()
    return s


def parse_project_name(cmakelists: Path) -> str:
    raw = cmakelists.read_text(encoding="utf-8", errors="replace")
    text = _COMMENT_RE.sub("", raw)

    # 1) Collect simple set(VAR value) assignments.
    vars: dict[str, str] = {}
    for m in _SET_RE.finditer(text):
        var = m.group(1).strip()
        rhs = m.group(2).strip()

        # Take the first token of rhs as the variable's value.
        # This handles: set(CMAKE_PROJECT_NAME Valve_Board26)
        # and ignores CubeMX noise like CACHE/STRING/FORCE if present.
        token = rhs.split()[0] if rhs else ""
        token = _strip_quotes(token)

        if token:
            vars[var] = token

    # 2) If the file sets CMAKE_PROJECT_NAME explicitly, prefer that.
    if "CMAKE_PROJECT_NAME" in vars:
        return vars["CMAKE_PROJECT_NAME"]

    # 3) Otherwise, try to parse project(<first-arg>) and resolve ${VAR}.
    pm = _PROJECT_CALL_RE.search(text)
    if pm:
        first_arg = _strip_quotes(pm.group(1).strip())
        vm = _VAR_REF_RE.match(first_arg)
        if vm:
            var = vm.group(1)
            if var in vars:
                return vars[var]
            raise FriendlyError(
                f"Found project({first_arg} ...) in {cmakelists}, but {var} wasn't set to a simple value.\n"
                f"Tip: add a line like: set({var} MyProjectName)\n"
                f"Or pass --project MyProjectName to the script."
            )
        return first_arg

    # 4) Give a helpful failure message with hints.
    raise FriendlyError(
        f"Couldn't parse project name from {cmakelists}\n"
        f"Expected either:\n"
        f"  - project(MyProject ...)\n"
        f"  - set(CMAKE_PROJECT_NAME MyProject) then project(${{CMAKE_PROJECT_NAME}})\n"
        f"Tip: you can override with --project <name>."
    )
def pick_elf(build_dir: Path, preferred_name: Optional[str]) -> Path:
    if preferred_name:
        p = build_dir / f"{preferred_name}.elf"
        if p.exists():
            return p

    # fallback: any *.elf in build dir (common for embedded)
    elfs = sorted(build_dir.glob("*.elf"))
    if len(elfs) == 1:
        return elfs[0]
    if len(elfs) > 1:
        names = ", ".join(e.name for e in elfs[:10])
        raise FriendlyError(
            f"Multiple .elf files found in {build_dir}: {names}\n"
            f"Pass --artifact <name> to select one (without extension)."
        )
    raise FriendlyError(
        f"No .elf produced in {build_dir}.\n"
        f"Tip: check your CMake target output or pass --artifact <name>."
    )


def wait_port(host: str, port: int, timeout_s: float = 5.0) -> None:
    deadline = time.time() + timeout_s
    last_err = None
    while time.time() < deadline:
        try:
            with socket.create_connection((host, port), timeout=0.5):
                return
        except OSError as e:
            last_err = e
            time.sleep(0.1)
    raise FriendlyError(f"Timed out waiting for {host}:{port} to open ({timeout_s:.1f}s). Last error: {last_err}")


# ---------------------------
# Build
# ---------------------------

@dataclass
class BuildConfig:
    repo_root: Path
    build_type: str  # "Debug" | "Release"
    telemetry: bool
    generator: str
    toolchain_file: Path
    build_subdir: str
    project_name: str
    artifact: Optional[str]  # base name without extension (if known/forced)

    allocator: str = "tlsf"
    packet_store: str = "compact"
    sedsnet_ref: str = "main"
    watchdog: bool = True
    network_rate_hz: Optional[int] = None

    @property
    def build_dir(self) -> Path:
        return self.repo_root / "build" / self.build_subdir


def clean_build(ui: UI, repo_root: Path, build_subdir: str | None = None) -> None:
    """Remove selected build outputs and shared CRC32 artifacts; report space."""
    build_root = repo_root / "build"
    target = build_root if build_subdir is None else build_root / build_subdir
    try:
        removed, reclaimed = clean_generated(build_root, target)
    except ValueError as exc:
        raise FriendlyError(str(exc)) from exc
    for path in removed:
        ui.say("ok", f"Cleaned build artifacts: {path}")
    if not removed:
        ui.say("info", "Already clean")
    ui.say("ok", f"Reclaimed approximately {format_reclaimed(reclaimed)} ({reclaimed:,} allocated file bytes)")


def configure(ui: UI, cfg: BuildConfig) -> None:
    cfg.build_dir.mkdir(parents=True, exist_ok=True)

    telemetry_flag = f"-DENABLE_TELEMETRY={'ON' if cfg.telemetry else 'OFF'}"
    watchdog_flag = f"-DENABLE_BOARD_WATCHDOG={'ON' if cfg.watchdog else 'OFF'}"
    simulator_flag = f"-DSEDS_FIRMWARE_SIM_TEST={'ON' if os.environ.get('SEDS_FIRMWARE_SIM_TEST') == '1' else 'OFF'}"

    run(ui, [
        "cmake",
        f"-DCMAKE_BUILD_TYPE={cfg.build_type}",
        "-DCMAKE_EXPORT_COMPILE_COMMANDS=ON",
        f"-DCMAKE_TOOLCHAIN_FILE={str(cfg.toolchain_file)}",
        "-DCMAKE_COMMAND=cmake",
        watchdog_flag,
        f"-DDAQ_NETWORK_RATE_HZ={cfg.network_rate_hz if cfg.network_rate_hz is not None else ''}",
        f"-DTELEMETRY_USE_TLSF={'ON' if cfg.allocator == 'tlsf' else 'OFF'}",
        f"-DSEDSNET_GIT_REF={cfg.sedsnet_ref}",
        f"-DSEDSNET_COMPACT_PACKET_STORE={'ON' if cfg.packet_store == 'compact' else 'OFF'}",
        "-DSEDSNET_COMPACT_PACKET_COMPRESSION=OFF",
        telemetry_flag,
        simulator_flag,
        "-DENABLE_TELEMETRY_CAN_BUS=ON",
        "-DENABLE_TELEMETRY_BOARD_LINK_UART=OFF",
        "-S", str(cfg.repo_root),
        "-B", str(cfg.build_dir),
        "-G", cfg.generator,
    ], cwd=cfg.repo_root)


def ensure_test_dependencies(ui: UI, cfg: BuildConfig) -> None:
    """Native tests reuse LaunchCore from a configured build's FetchContent
    cache; a fresh checkout has none, so configure once (no build)."""
    if not any(cfg.repo_root.glob("build/*/_deps/sedslaunchcore-src/CMakeLists.txt")):
        configure(ui, cfg)


def configure_and_build(ui: UI, cfg: BuildConfig, target: str | None = None) -> tuple[Path, Path]:
    configure(ui, cfg)

    build_cmd = ["cmake", "--build", str(cfg.build_dir)]
    if target:
        build_cmd += ["--target", target]
    build_cmd.append("--parallel")
    run(ui, build_cmd, cwd=cfg.repo_root)

    # Find elf, then objcopy -> bin
    preferred = cfg.artifact or (
        target if target and target != "factory-image" else cfg.project_name
    )
    elf = pick_elf(cfg.build_dir, preferred)
    bin_path = elf.with_suffix(".bin")

    # Prefer arm-none-eabi-objcopy but allow override via env
    objcopy = os.environ.get("OBJCOPY", "arm-none-eabi-objcopy")
    run(ui, [objcopy, "-O", "binary", str(elf), str(bin_path)], cwd=cfg.repo_root)

    ui.say("ok", f"Built: {elf.name} -> {bin_path.name}")
    return elf, bin_path


@dataclass(frozen=True)
class BuiltArtifact:
    kind: str
    path: Path
    address: str
    elf: Path


@dataclass(frozen=True)
class OtaLayout:
    mode: str
    secondary_size: int = 0


# What a persistent-store erase wipes on this board. The bootloader, the
# application slot and LaunchCore metadata are separate pages and stay.
PERSIST_CONTENTS = ("every LaunchCore persistent record: the cached flight state, boot identity, "
                    "recovery floor and commissioning record, and the load-cell calibration and "
                    "KG50 input setting")


@dataclass(frozen=True)
class PersistRegion:
    base: int
    size: int
    page_size: int
    flash_base: int

    @property
    def pages(self) -> range:
        first = (self.base - self.flash_base) // self.page_size
        return range(first, first + self.size // self.page_size)


def persist_region(repo_root: Path) -> PersistRegion:
    region = PersistRegion(board_macro(repo_root, "PERSIST_BASE"), board_macro(repo_root, "PERSIST_SIZE"),
                           board_macro(repo_root, "FLASH_ERASE_SIZE"),
                           board_macro(repo_root, "INTERNAL_FLASH_BASE"))
    if (region.size <= 0 or region.base < region.flash_base or
            (region.base - region.flash_base) % region.page_size or region.size % region.page_size):
        raise FriendlyError("The persistent store region is not whole flash pages: check board_config.h")
    return region


def describe_persist_erase(region: PersistRegion) -> str:
    return (f"Erasing the persistent store 0x{region.base:08X}-0x{region.base + region.size - 1:08X} "
            f"({region.size // 1024} KiB, pages {region.pages.start}-{region.pages.stop - 1}): "
            f"{PERSIST_CONTENTS}. Pass --keep-persist to keep them.")


def persist_erase_selected(args: argparse.Namespace, kind: str) -> bool:
    """Factory flashes erase the store by default; app-only flashes keep it."""
    if args.keep_persist:
        return False
    return bool(args.erase_persist) or kind == "factory"


def board_macro_optional(repo_root: Path, suffix: str) -> int | None:
    text = (repo_root / "Bootloader" / "board_config.h").read_text(encoding="utf-8")
    matches = re.findall(
        rf"(?m)^#define\s+([A-Za-z0-9_]*{re.escape(suffix)})\s+"
        rf"(0x[0-9A-Fa-f]+|[0-9]+)u?\s*$",
        text,
    )
    if len(matches) > 1:
        raise FriendlyError(f"Expected at most one BSP macro ending in {suffix}; found {len(matches)}")
    if not matches:
        return None
    return int(matches[0][1], 0)


def board_macro(repo_root: Path, suffix: str) -> int:
    value = board_macro_optional(repo_root, suffix)
    if value is None:
        raise FriendlyError(f"BSP macro ending in {suffix} is required")
    return value


def detect_ota_layout(repo_root: Path) -> OtaLayout:
    storage = "\n".join(
        source.read_text(encoding="utf-8", errors="replace")
        for source in sorted((repo_root / "Bootloader").glob("*.c"))
    )
    delta_size = board_macro_optional(repo_root, "DELTA_SIZE")
    slot_b_size = board_macro_optional(repo_root, "SLOT_B_SIZE")
    staging_size = board_macro_optional(repo_root, "APP_STAGING_SIZE")
    slot_b_is_delta = re.search(
        r"\.slot_b_is_delta\s*=\s*true\b", storage
    ) is not None

    if delta_size:
        return OtaLayout("delta", delta_size)
    if slot_b_size:
        return OtaLayout("delta" if slot_b_is_delta else "ab", slot_b_size)
    if staging_size:
        return OtaLayout("staging", staging_size)
    return OtaLayout("recovery")


def _cache_value(cache: Path, key: str) -> Optional[str]:
    if not cache.exists():
        return None
    prefix = f"{key}:"
    for line in cache.read_text(encoding="utf-8", errors="replace").splitlines():
        if line.startswith(prefix) and "=" in line:
            return line.split("=", 1)[1].strip()
    return None


def build_selected_artifact(
    ui: UI,
    cfg: BuildConfig,
    kind: str,
    ota_base: str | None,
    ota_output: str | None,
    force_delta: bool,
) -> BuiltArtifact:
    app_target = cfg.project_name
    boot_target = f"{cfg.project_name}Bootloader"
    target = {"firmware": app_target, "bootloader": boot_target,
              "factory": "factory-image", "ota": app_target}[kind]
    ota_layout = detect_ota_layout(cfg.repo_root) if kind == "ota" else None
    if ota_base and ota_layout is not None and ota_layout.mode != "delta":
        raise FriendlyError("--ota-base is only valid for a delta-mode BSP.")
    automatic_base: Path | None = None
    if ota_layout is not None and ota_layout.mode == "delta" and not ota_base:
        previous = cfg.build_dir / f"{cfg.project_name}.launchcore.img"
        if previous.is_file():
            automatic_base = cfg.build_dir / f".{cfg.project_name}.ota-base.launchcore.img"
            shutil.copy2(previous, automatic_base)
    elf, raw_bin = configure_and_build(ui, cfg, target)

    if kind == "bootloader":
        return BuiltArtifact(kind, raw_bin, "0x08000000", elf)

    app_image = cfg.build_dir / f"{cfg.project_name}.launchcore.img"
    if not app_image.is_file():
        raise FriendlyError(f"Packaged LaunchCore application was not produced: {app_image}")
    slot_base = board_macro(cfg.repo_root, "SLOT_A_BASE")
    if kind == "firmware":
        ui.say("ok", f"Firmware image: {app_image} (flash at 0x{slot_base:08X})")
        return BuiltArtifact(kind, app_image, f"0x{slot_base:08X}", elf)

    if kind == "factory":
        factory = cfg.build_dir / f"{cfg.project_name}.factory.bin"
        if not factory.is_file():
            raise FriendlyError(f"LaunchCore factory image was not produced: {factory}")
        ui.say("ok", f"Factory image: {factory} (flash at 0x08000000)")
        return BuiltArtifact(kind, factory, "0x08000000", elf)

    base = Path(ota_base).expanduser().resolve() if ota_base else automatic_base
    if ota_base and (base is None or not base.is_file()):
        raise FriendlyError(f"OTA baseline image not found: {base}")
    output = (Path(ota_output).expanduser().resolve() if ota_output else
              cfg.build_dir / f"{cfg.project_name}.seds")
    output.parent.mkdir(parents=True, exist_ok=True)
    if ota_layout is None:
        raise FriendlyError("Could not determine the BSP OTA layout.")
    if ota_layout.mode != "delta":
        shutil.copy2(app_image, output)
        kind_name = {"ab": "A/B slot", "staging": "single-slot staging",
                     "recovery": "bootloader recovery"}[ota_layout.mode]
        ui.say("ok", f"Built {kind_name} OTA: {output}")
        return BuiltArtifact(f"ota-{ota_layout.mode}", output, "", elf)
    if base is None:
        shutil.copy2(app_image, output)
        ui.say("ok", f"Built full-image recovery OTA: {output}")
        return BuiltArtifact("ota-recovery", output, "", elf)
    configured_launchcore = _cache_value(
        cfg.build_dir / "CMakeCache.txt", "FETCHCONTENT_SOURCE_DIR_SEDSLAUNCHCORE"
    )
    launchcore_source = (Path(configured_launchcore) if configured_launchcore else
                         cfg.build_dir / "_deps" / "sedslaunchcore-src")
    delta_tool = launchcore_source / "tools" / "mkdelta.py"
    if not delta_tool.is_file():
        raise FriendlyError(f"LaunchCore delta tool was not fetched: {delta_tool}")
    cmd = [sys.executable, str(delta_tool), "--base", str(base),
           "--target", str(app_image), "--output", str(output),
           "--erase-size", hex(board_macro(cfg.repo_root, "FLASH_ERASE_SIZE")),
           "--slot-size", hex(board_macro(cfg.repo_root, "SLOT_A_SIZE")),
           "--delta-slot-size", hex(ota_layout.secondary_size)]
    if force_delta:
        cmd.append("--force")
    try:
        ui.say("run", " ".join(shlex.quote(c) for c in cmd))
        delta = subprocess.run(cmd, cwd=cfg.repo_root, capture_output=True, text=True)
        if delta.returncode != 0:
            shutil.copy2(app_image, output)
            ui.say("info", "Delta is unavailable or does not fit; using bootloader recovery.")
            ui.say("ok", f"Built full-image recovery OTA: {output}")
            return BuiltArtifact("ota-recovery", output, "", elf)
    finally:
        if automatic_base is not None:
            automatic_base.unlink(missing_ok=True)
    ui.say("ok", f"Built OTA delta: {output}")
    return BuiltArtifact("ota-delta", output, "", elf)


# ---------------------------
# Flashing
# ---------------------------

def flash_dfu(ui: UI, bin_path: Path, addr: str, erase: Optional[PersistRegion] = None) -> None:
    if which("dfu-util") is None:
        raise FriendlyError("dfu-util not found.\n"
                            "Install it (e.g., apt-get install dfu-util, brew install dfu-util) "
                            "or use --method st-flash / st-util.")
    if erase is not None:
        # dfu-util cannot erase a page range alone: mass-erase the chip, then
        # write the factory image (bootloader, application and metadata).
        if ":" in addr or int(addr, 0) != erase.flash_base:
            raise FriendlyError("A DFU persistent-store erase mass-erases the chip, so it needs the "
                                "factory image at the flash base. Use --keep-persist, or flash the "
                                "factory image.")
        ui.say("warn", describe_persist_erase(erase) + " DFU erases the whole chip first.")
        dfuse_address = f"{addr}:mass-erase:force:leave"
    else:
        dfuse_address = addr if ":" in addr else f"{addr}:leave"
    cmd = ["dfu-util", "-a", "0", "-s", dfuse_address, "-D", str(bin_path)]
    ui.say("run", " ".join(shlex.quote(part) for part in cmd))
    try:
        process = subprocess.Popen(
            cmd,
            stdout=subprocess.PIPE,
            stderr=subprocess.STDOUT,
            bufsize=0,
        )
    except FileNotFoundError:
        raise FriendlyError("Command not found: dfu-util")

    output_chunks = []
    line_chunks = []
    deferred_status = ""
    assert process.stdout is not None
    stream = io.TextIOWrapper(
        process.stdout, encoding="utf-8", errors="replace", newline=""
    )
    while text := stream.read(1):
        output_chunks.append(text)
        line_chunks.append(text)
        if text in ("\r", "\n"):
            line = "".join(line_chunks)
            line_chunks.clear()
            if "dfu-util: Error during download get_status" in line:
                deferred_status += line
            else:
                print(line, end="", flush=True)
    if line_chunks:
        line = "".join(line_chunks)
        if "dfu-util: Error during download get_status" in line:
            deferred_status += line
        else:
            print(line, end="", flush=True)
    returncode = process.wait()
    output = "".join(output_chunks)

    reset_disconnect = (
        returncode == 74
        and "File downloaded successfully" in output
        and "Submitting leave request" in output
        and "Error during download get_status" in output
    )
    if reset_disconnect:
        return
    if deferred_status:
        print(deferred_status, end="", flush=True)
    if returncode != 0:
        raise FriendlyError(f"Command failed (exit {returncode}): dfu-util")


def st_flash_version(exe: str) -> tuple[int, ...]:
    probe = subprocess.run([exe, "--version"], capture_output=True, text=True, timeout=10)
    found = re.search(r"v?(\d+)\.(\d+)\.(\d+)", probe.stdout + probe.stderr)
    return tuple(int(part) for part in found.groups()) if found else ()


def flash_st_flash(ui: UI, bin_path: Path, addr: str, reset: bool,
                   erase: Optional[PersistRegion] = None) -> None:
    # st-flash comes from stlink tools
    exe = which("st-flash")
    if exe is None:
        raise FriendlyError("st-flash not found.\n"
                            "Install STLink tools (stlink). On Ubuntu: apt-get install stlink-tools. "
                            "On macOS: brew install stlink.")
    if erase is not None:
        # A range erase needs stlink 1.8.0; an older st-flash erases the whole chip.
        if st_flash_version(exe) < (1, 8, 0):
            raise FriendlyError("st-flash 1.8.0 or newer is needed to erase only the persistent "
                                "store. Update stlink, use --method stm32prog-cli, or pass --keep-persist.")
        ui.say("warn", describe_persist_erase(erase))
        run(ui, ["st-flash", "erase", f"0x{erase.base:08x}", str(erase.size)])
    cmd = ["st-flash"]
    if reset:
        cmd.append("--reset")
    cmd += ["write", str(bin_path), addr]
    run(ui, cmd)


def verify_stm32_target(exe: str, connect: str) -> None:
    """Refuse a CubeProgrammer write when the connected MCU family is wrong."""
    probe = subprocess.run([exe, "-c", *connect.split()], capture_output=True,
                           text=True, timeout=30)
    output = re.sub(r"\x1b\[[0-9;]*m", "", probe.stdout + probe.stderr)
    found = re.search(r"Device ID\s*:\s*(0x[0-9a-fA-F]+)", output)
    if probe.returncode or found is None or int(found.group(1), 16) != 0x482:
        actual = found.group(1) if found else "unidentified"
        raise RuntimeError(f"Refusing flash: expected STM32 device 0x482, got {actual}. Check ST-Link wiring.")


def flash_stm32prog_cli(
    ui: UI,
    bin_path: Path,
    addr: str,
    reset: bool,
    stm32prog_cli: str | None,
    connect: str,
    extra_args: list[str],
    erase: Optional[PersistRegion] = None,
) -> None:
    exe = (
        stm32prog_cli
        or os.environ.get("STM32_PROGRAMMER_CLI")
        or which("STM32_Programmer_CLI")
        or which("STM32ProgrammerCLI")
    )
    if exe is None:
        raise FriendlyError("STM32_Programmer_CLI not found.\n"
                            "Install STM32CubeProgrammer and add it to PATH, "
                            "or pass --stm32prog-cli /path/to/STM32_Programmer_CLI.")
    verify_stm32_target(exe, connect)
    cmd = [exe, "-c", connect]
    if erase is not None:
        ui.say("warn", describe_persist_erase(erase))
        cmd += ["-e", *[str(page) for page in erase.pages]]
    cmd += ["-w", str(bin_path), addr, "-v"]
    if reset:
        cmd.append("-rst")
    cmd += extra_args
    run(ui, cmd)


def flash_selected(ui: UI, repo_root: Path, args: argparse.Namespace, artifact: BuiltArtifact) -> None:
    method = args.method
    addr = args.addr or artifact.address
    erase = persist_region(repo_root) if persist_erase_selected(args, artifact.kind) else None
    if erase is not None and method in ("st-util", "stlink-gdbserver"):
        raise FriendlyError(f"--method {method} cannot erase the persistent store. Use dfu, st-flash or "
                            "stm32prog-cli, or pass --keep-persist.")

    if method == "dfu":
        flash_dfu(ui, artifact.path, addr, erase=erase)
    elif method == "st-flash":
        flash_st_flash(ui, artifact.path, addr, reset=(not args.no_reset), erase=erase)
    elif method == "st-util":
        port = args.port or 4242
        st_args = shlex.split(args.st_util_args) if args.st_util_args else []
        flash_st_util(ui, artifact.path, addr, args.gdb, args.host, port, st_args)
    elif method == "stlink-gdbserver":
        # Reasonable default port used by some gdbservers (override with --port).
        port = args.port or 61234
        gs_args = shlex.split(args.gdbserver_args) if args.gdbserver_args else []
        # If user didn't specify port in args, try to nudge server via args when possible.
        # We won't guess vendor-specific flags; user can pass them in --gdbserver-args.
        flash_stlink_gdbserver(ui, artifact.path, addr, args.gdb, args.host, port, args.gdbserver, gs_args)
    elif method == "stm32prog-cli":
        sp_args = shlex.split(args.stm32prog_args) if args.stm32prog_args else []
        flash_stm32prog_cli(
            ui,
            artifact.path,
            addr,
            reset=(not args.no_reset),
            stm32prog_cli=args.stm32prog_cli,
            connect=args.stm32prog_connect,
            extra_args=sp_args,
            erase=erase,
        )
    else:
        raise FriendlyError(f"Unknown method: {method}")

    ui.say("ok", f"Flashed using method: {method}")


def flash_binary_via_gdb(
    ui: UI, image_path: Path, addr: str, host: str, port: int, gdb: str
) -> None:
    if which(gdb) is None:
        raise FriendlyError(f"{gdb} not found.\n"
                            "Install the ARM GNU toolchain that provides arm-none-eabi-gdb "
                            "or pass --gdb <path>.")
    image = str(image_path.resolve()).replace("\\", "\\\\").replace('"', '\\"')
    cmds = [
        "set confirm off",
        "set pagination off",
        f"target extended-remote {host}:{port}",
        "monitor reset halt",
        f'restore "{image}" binary {addr}',
        "monitor reset run",
        "quit",
    ]
    run(ui, [gdb, "-q", "-batch", *sum([["-ex", c] for c in cmds], [])])


def flash_st_util(ui: UI, image_path: Path, addr: str, gdb: str, host: str, port: int, st_util_args: list[str]) -> None:
    # st-util comes from stlink tools; it provides a GDB server (default :4242).
    if which("st-util") is None:
        raise FriendlyError("st-util not found.\n"
                            "Install STLink tools (stlink). On Ubuntu: apt-get install stlink-tools. "
                            "On macOS: brew install stlink.")
    proc = popen(ui, ["st-util", *st_util_args])
    try:
        wait_port(host, port, timeout_s=8.0)
        flash_binary_via_gdb(ui, image_path, addr, host, port, gdb)
    finally:
        proc.terminate()
        try:
            proc.wait(timeout=2.0)
        except subprocess.TimeoutExpired:
            proc.kill()


def flash_stlink_gdbserver(ui: UI, image_path: Path, addr: str, gdb: str, host: str, port: int, gdbserver: str, gdbserver_args: list[str]) -> None:
    # Common names: ST-LINK_gdbserver (CubeProgrammer) or ST-LINK_gdbserver.exe on Windows.
    if which(gdbserver) is None:
        raise FriendlyError(f"{gdbserver} not found.\n"
                            "Install STM32CubeProgrammer (for ST-LINK_gdbserver) or provide --gdbserver <path>.\n"
                            "Alternatively use --method st-flash.")
    proc = popen(ui, [gdbserver, *gdbserver_args])
    try:
        wait_port(host, port, timeout_s=10.0)
        # Some servers don't support monitor reset; keep it, but allow override
        flash_binary_via_gdb(ui, image_path, addr, host, port, gdb)
    finally:
        proc.terminate()
        try:
            proc.wait(timeout=2.0)
        except subprocess.TimeoutExpired:
            proc.kill()


# ---------------------------
# CLI
# ---------------------------

def make_parser() -> argparse.ArgumentParser:
    p = argparse.ArgumentParser(
        prog="build.py",
        description="Build (CMake/Ninja) and flash firmware with friendly errors.",
    )
    p.add_argument("--trace", action="store_true", help="Show full Python tracebacks on errors.")
    p.add_argument("--emoji", choices=["auto", "on", "off"], default="auto",
                   help="UI symbols. 'auto' uses emoji only when it looks safe.")
    p.add_argument("--toolchain", default=None,
                   help="Toolchain file path (default: <repo>/cmake/gcc-arm-none-eabi.cmake)")
    p.add_argument("--generator", default="Ninja", help="CMake generator (default: Ninja)")
    p.add_argument("--artifact", default=None,
                   help="Base name of output artifact (without extension), if not equal to project name.")
    p.add_argument("--project", default=None,
                   help="Override project name (otherwise read from CMakeLists.txt).")
    p.add_argument("--build-subdir", default=None,
                   help="Build folder name under ./build (default: Debug_Script or Release_Script)")


    # Build-mode flags are accepted on subcommands (and we also support them before/after via argv normalization).

    sub = p.add_subparsers(dest="cmd", required=True)

    sub.add_parser("clean", help="Remove build/ and CRC32 artifacts; report reclaimed space")

    def add_mode_and_common(sp: argparse.ArgumentParser) -> None:
        mode = sp.add_mutually_exclusive_group()
        mode.add_argument("--debug", action="store_true", help="Debug build (default).")
        mode.add_argument("--release", action="store_true", help="Release build.")
        sp.add_argument("--allocator", choices=["threadx", "tlsf"], default="tlsf",
                        help="SEDSnet allocator (default: tlsf); scheduling remains ThreadX.")
        sp.add_argument("--packet-store", choices=["heap", "compact"], default="compact",
                        help="Compact packet arena (default); uses main unless --sedsnet-ref is explicit.")
        sp.add_argument("--sedsnet-ref", choices=["main", "dev"], default=None,
                        help="SEDSnet branch; current remote commit is fetched, with offline fallback.")
        sp.add_argument("--no-telemetry", action="store_true", help="Configure with -DENABLE_TELEMETRY=OFF")
        sp.add_argument("--network-rate-hz", type=int, default=None,
                        help="Override the aggregate live sensor cap from daq_network_config.h (default 100); ADC/SD cadence unchanged.")
        watchdog = sp.add_mutually_exclusive_group()
        watchdog.add_argument("--watchdog", dest="watchdog", action="store_true", default=True,
                              help="Enable the task-progress hardware watchdog (default; matching bootloader required).")
        watchdog.add_argument("--no-watchdog", dest="watchdog", action="store_false",
                              help="Disable the hardware watchdog for a diagnostic build.")
        sp.add_argument("--image", choices=["firmware", "bootloader", "factory", "ota"],
                        default="factory",
                        help="Artifact to build (default: factory bootloader+firmware image).")
        sp.add_argument("--ota", action="store_true",
                        help="Shortcut for --image ota using the previous build as its baseline.")
        sp.add_argument("--ota-base",
                        help="Override the automatic previous-build OTA baseline.")
        sp.add_argument("--ota-output", help="Output path for the generated OTA delta.")
        sp.add_argument("--force-delta", action="store_true",
                        help="Keep a delta even when LaunchCore estimates a full image is smaller.")

    b = sub.add_parser("build", help="Configure + build + objcopy to .bin")
    add_mode_and_common(b)

    f = sub.add_parser("flash", help="Build then flash")
    add_mode_and_common(f)

    f.add_argument("--method", choices=["dfu", "st-flash", "st-util", "stlink-gdbserver", "stm32prog-cli"], default="st-flash",
                   help="Flashing method.")
    f.add_argument("--addr", default=None,
                   help="Override the BSP-derived flash address.")
    f.add_argument("--no-reset", action="store_true", help="Do not reset after flash (st-flash/stm32prog-cli).")
    f.add_argument("--app-only", action="store_true",
                   help="Deprecated alias for --image firmware.")
    persist = f.add_mutually_exclusive_group()
    persist.add_argument("--erase-persist", action="store_true",
                         help="Erase the LaunchCore persistent store (cached flight state, boot identity, "
                              "recovery floor and other stored settings) with this flash. "
                              "Default for factory images.")
    persist.add_argument("--keep-persist", action="store_true",
                         help="Keep the persistent store on a factory flash.")

    t = sub.add_parser("test", help="Run unit tests and optional full firmware simulation")
    add_mode_and_common(t)
    t.add_argument("--all", "--full", dest="all_tests", action="store_true",
                   help="Build the selected configuration and run all unit and Docker firmware simulation tests (--full is an alias).")
    t.add_argument("--ultra-soak", action="store_true",
                   help="After --all, run an additional 10-minute linked-network fault/rejoin soak.")

    # st-util options
    f.add_argument("--host", default="127.0.0.1", help="GDB server host (default: 127.0.0.1)")
    f.add_argument("--port", type=int, default=None,
                   help="GDB server port (st-util default 4242; gdbserver varies).")
    f.add_argument("--gdb", default="arm-none-eabi-gdb", help="GDB executable (default: arm-none-eabi-gdb)")
    f.add_argument("--st-util-args", default="", help="Extra args for st-util (quoted string).")
    f.add_argument("--gdbserver", default="ST-LINK_gdbserver", help="GDB server executable (default: ST-LINK_gdbserver)")
    f.add_argument("--gdbserver-args", default="", help="Extra args for gdbserver (quoted string).")
    f.add_argument("--stm32prog-cli", default=None,
                   help="STM32CubeProgrammer CLI executable path (default: env STM32_PROGRAMMER_CLI or PATH).")
    f.add_argument("--stm32prog-connect", default="port=SWD",
                   help="STM32_Programmer_CLI -c argument value (default: port=SWD).")
    f.add_argument("--stm32prog-args", default="",
                   help="Extra args for STM32_Programmer_CLI (quoted string).")

    return p


def build_cfg_from_args(ui: UI, args: argparse.Namespace) -> BuildConfig:
    script_dir = Path(__file__).resolve().parent
    repo_root = find_repo_root(script_dir)

    cmakelists = repo_root / "CMakeLists.txt"
    project_name = args.project or parse_project_name(cmakelists)

    build_type = "Release" if args.release else "Debug"
    build_subdir = args.build_subdir
    if build_subdir is None:
        build_subdir = "Release_Script" if build_type == "Release" else "Debug_Script"

    toolchain = Path(args.toolchain) if args.toolchain else (repo_root / "cmake" / "gcc-arm-none-eabi.cmake")
    if not toolchain.exists():
        raise FriendlyError(f"Toolchain file not found: {toolchain}\n"
                            f"Pass --toolchain <path> to set it explicitly.")

    if args.network_rate_hz is not None and not 1 <= args.network_rate_hz <= 1000:
        raise FriendlyError("--network-rate-hz must be from 1 to 1000")

    return BuildConfig(
        repo_root=repo_root,
        build_type=build_type,
        telemetry=not args.no_telemetry,
        watchdog=args.watchdog,
        network_rate_hz=args.network_rate_hz,
        allocator=args.allocator,
        packet_store=args.packet_store,
        sedsnet_ref=args.sedsnet_ref or "main",
        generator=args.generator,
        toolchain_file=toolchain,
        build_subdir=build_subdir,
        project_name=project_name,
        artifact=args.artifact,
    )


def main() -> None:
    parser = make_parser()
    args = parser.parse_args()

    ui = UI(emoji=args.emoji)

    if not args.trace:
        sys.excepthook = _wrap_unhandled(ui)

    if args.cmd == "clean":
        clean_build(ui, find_repo_root(Path(__file__).resolve().parent), args.build_subdir)
        return

    cfg = build_cfg_from_args(ui, args)

    if args.cmd == "test":
        if args.ultra_soak and not args.all_tests:
            raise FriendlyError("--ultra-soak requires --all (or --full).")
        results: list[tuple[str, str]] = []
        _run_test_stage(
            ui, results, "Host and Python unit tests",
            lambda: (ensure_test_dependencies(ui, cfg), run_host_tests(ui, cfg.repo_root)),
        )
        _run_test_stage(
            ui, results, "GoogleTest unit tests",
            lambda: run_gtests(ui, cfg.repo_root),
        )
        if args.all_tests:
            # Qualification needs observability probes that are intentionally
            # excluded from production/flash builds.
            os.environ["SEDS_FIRMWARE_SIM_TEST"] = "1"
            from sim.run_full import (
                require_docker,
                run_full_simulation,
                run_memory_profile,
                run_network_simulation,
                run_network_qualification,
                run_unacknowledged_can_simulation,
            )
            _run_test_stage(ui, results, "Docker readiness", require_docker)
            _run_test_stage(
                ui, results, "Factory firmware build",
                lambda: build_selected_artifact(
                    ui, cfg, "factory", None, None, False
                ),
            )
            _run_test_stage(
                ui, results, "OTA package build",
                lambda: build_selected_artifact(
                    ui, cfg, "ota", None, None, False
                ),
            )
            _run_test_stage(
                ui, results, "Firmware simulation",
                lambda: run_full_simulation(
                    ui, cfg.repo_root, "stm32u5", cfg.build_subdir
                ),
            )
            _run_test_stage(
                ui, results, "Allocator stress and memory probes",
                lambda: run_memory_profile(
                    ui, cfg.repo_root, "stm32u5", cfg.build_subdir
                ),
            )
            _run_test_stage(
                ui, results, "Disconnected CAN survival",
                lambda: run_unacknowledged_can_simulation(
                    ui, cfg.repo_root, "stm32u5", cfg.build_subdir
                ),
            )
            _run_test_stage(
                ui, results, "Network discovery and time sync",
                lambda: run_network_qualification(
                    ui, cfg.repo_root, "stm32u5", cfg.build_subdir
                ),
            )
            if args.ultra_soak:
                _run_test_stage(
                    ui, results, "10-minute network fault/rejoin soak",
                    lambda: run_network_simulation(
                        ui, cfg.repo_root, "stm32g4", cfg.build_subdir,
                        ultra_soak=True,
                    ),
                )
        _print_test_summary(ui, results)
        return

    if args.cmd == "build":
        kind = "ota" if args.ota else args.image
        build_selected_artifact(
            ui, cfg, kind, args.ota_base, args.ota_output, args.force_delta
        )
        return

    if args.cmd == "flash":
        kind = "firmware" if args.app_only else ("ota" if args.ota else args.image)
        artifact = build_selected_artifact(
            ui, cfg, kind, args.ota_base, args.ota_output, args.force_delta
        )
        if artifact.kind.startswith("ota"):
            transport = {
                "ota-delta": "the SEDSNet delta stream",
                "ota-ab": "the LaunchCore A/B full-image stream",
                "ota-staging": "the LaunchCore staging stream",
                "ota-recovery": "the LaunchCore bootloader recovery transport",
            }[artifact.kind]
            raise FriendlyError(
                f"This OTA artifact is uploaded through {transport}; it is not directly "
                "address-flashable. Upload the generated .seds artifact instead."
            )

        flash_selected(ui, cfg.repo_root, args, artifact)
        return

    raise FriendlyError("No command provided. Use 'build' or 'flash'.")


if __name__ == "__main__":
    main()
