University-at-Buffalo-SEDS/DAQ-Board/Core/Src/telemetry_thread.c

#include "board_watchdog.h"
#include <stdbool.h>
// telemetry_thread.c
#include "DAQ-Threads.h"
#include "daq_rates.h"
#ifdef TELEMETRY_BOARD_LINK_UART
#include "board_link_uart.h"
#endif
#include "tx_api.h"
#include "telemetry.h"
#include "ota_stream.h"
#include "sd_file_stream.h"
#ifdef TELEMETRY_CAN_BUS
#include "can_bus.h"
#endif
#include "main.h"

TX_THREAD telemetry_thread;
#define TELEMETRY_THREAD_STACK_SIZE (32U * 1024U)

volatile uint32_t g_telemetry_stack_remaining = TELEMETRY_THREAD_STACK_SIZE;

#ifdef SEDS_FIRMWARE_SIM_TEST
/* Allocation-free, sampled with the existing 4 Hz stack diagnostic rather
 * than in the publication hot path. Production does not run these probes. */
volatile uint32_t g_sim_daq_sdk_shared_peak;
volatile uint32_t g_sim_daq_sdk_queue_budget;
volatile uint32_t g_sim_daq_sdk_snapshots;
volatile uint32_t g_sim_daq_sdk_snapshot_failures;
volatile uint32_t g_sim_daq_sdk_admission_drops;
static void sample_sdk_queue_budget(void)
{
    if (g_router.r == NULL) return;
    uint32_t counters[16];
    if (seds_router_copy_memory_counters(g_router.r, counters, 16U) != 16)
    {
        ++g_sim_daq_sdk_snapshot_failures;
        return;
    }
    g_sim_daq_sdk_queue_budget = counters[1];
    if (counters[2] > g_sim_daq_sdk_shared_peak)
        g_sim_daq_sdk_shared_peak = counters[2];
    g_sim_daq_sdk_admission_drops = (uint32_t)seds_memory_admission_rejected();
    ++g_sim_daq_sdk_snapshots;
}
#endif

/* ST-Link requests a snapshot by setting request to 1. Export in the owning
 * thread, never by calling Rust/router functions from a halted debugger.
 * Idle in normal operation; buffers remain stable until the next request. */
volatile uint32_t g_telemetry_diag_request = 0U;
volatile uint32_t g_telemetry_diag_sequence = 0U;
volatile int32_t g_telemetry_diag_runtime_result = SEDS_OK;
volatile int32_t g_telemetry_diag_topology_result = SEDS_OK;
char g_telemetry_diag_runtime[12288];
char g_telemetry_diag_topology[8192];

static void sample_router_diagnostics(void)
{
    if (g_telemetry_diag_request == 0U || g_router.r == NULL) return;
    g_telemetry_diag_runtime[0] = '\0';
    g_telemetry_diag_topology[0] = '\0';
    g_telemetry_diag_runtime_result = seds_router_export_runtime_stats(
        g_router.r, g_telemetry_diag_runtime, sizeof(g_telemetry_diag_runtime));
    g_telemetry_diag_topology_result = seds_router_export_topology(
        g_router.r, g_telemetry_diag_topology, sizeof(g_telemetry_diag_topology));
    __DMB();
    g_telemetry_diag_sequence++;
    g_telemetry_diag_request = 0U;
}

static void sample_telemetry_stack(void)
{
    const volatile uint32_t *const start =
        (const volatile uint32_t *)telemetry_thread.tx_thread_stack_start;
    const volatile uint32_t *const end =
        (const volatile uint32_t *)telemetry_thread.tx_thread_stack_end;
    static const volatile uint32_t *high_water;
    if (start == NULL || end == NULL || start >= end) return;
    if (high_water == NULL || high_water < start || high_water > end) {
        high_water = start;
        while (high_water < end && *high_water == 0xEFEFEFEFUL) ++high_water;
    } else {
        while (high_water > start && high_water[-1] != 0xEFEFEFEFUL) --high_water;
    }
    const uint32_t remaining = (uint32_t)((uintptr_t)high_water -
        (uintptr_t)telemetry_thread.tx_thread_stack_start);
    if (remaining < g_telemetry_stack_remaining)
        g_telemetry_stack_remaining = remaining;
}
#ifdef TELEMETRY_CAN_BUS
extern FDCAN_HandleTypeDef hfdcan1;
#endif
#ifdef TELEMETRY_BOARD_LINK_UART
extern UART_HandleTypeDef huart1;
#endif

/* A fixed idle sleep capped dispatch near500 packets/s when each busy pass
 * consumed its 1 ms budget. Two250 Hz loadcell streams plus pressure receipts
 * exceed that cap. Keep draining a bounded burst, yielding to equal-priority
 * SD/report workers each time; acquisition remains higher priority. */
static uint8_t immediate_work_passes;
#ifdef TELEMETRY_CAN_BUS
extern volatile uint32_t g_can_tx_rejected;
#define CAN_TX_REFUSALS() g_can_tx_rejected
#else
#define CAN_TX_REFUSALS() 0U
#endif
/* Queued SDK work that the CAN TX queue just refused cannot move until the
 * bus drains; spinning on it starves the lower-priority SD writer, so the
 * local record would be lost exactly when the network link is down. */
static void wait_for_telemetry_work(ULONG poll_ticks, bool can_refused)
{
    if(!can_refused && g_router.r != NULL && seds_router_has_queued_work(g_router.r)>0 &&
       immediate_work_passes<4U){
        ++immediate_work_passes;
        tx_thread_relinquish();
    }else{
        immediate_work_passes=0U;
        tx_thread_sleep(poll_ticks);
    }
}

void telemetry_thread_entry(ULONG initial_input)
{
    (void)initial_input;
    const ULONG poll_ticks = (TX_TIMER_TICKS_PER_SECOND + 999U) / 1000U;
    const ULONG stack_sample_ticks = (TX_TIMER_TICKS_PER_SECOND + 3U) / 4U;
    ULONG last_stack_sample = tx_time_get() - stack_sample_ticks;

#ifdef TELEMETRY_CAN_BUS
    (void)can_bus_init(&hfdcan1);
#endif
#ifdef TELEMETRY_BOARD_LINK_UART
    board_link_uart_init(&huart1);
    (void)board_link_uart_start_rx();
#endif
    // Ensure router exists early (so we can send requests immediately)
    (void)init_telemetry_router();

    for (;;)
    {
        const uint32_t can_rejected = CAN_TX_REFUSALS();
        board_watchdog_progress(BOARD_WATCHDOG_NETWORK);
#ifdef TELEMETRY_BOARD_LINK_UART
        board_link_uart_process();
#endif
#ifdef TELEMETRY_CAN_BUS
        can_bus_process_rx();
#endif
        (void)telemetry_poll_discovery();
        (void)process_all_queues_timeout(1);
#ifdef TELEMETRY_BOARD_LINK_UART
        board_link_uart_process();
#endif
        (void)telemetry_poll_timesync();
        ota_stream_poll();
        sd_file_stream_poll();
        sample_router_diagnostics();

        /* The DAQ tick is 20 us, not 1 ms. Bound this higher-priority
         * worker's polling and diagnostic cost so ADC/SD workers can run. */
        const ULONG now = tx_time_get();
        if ((now - last_stack_sample) >= stack_sample_ticks)
        {
            sample_telemetry_stack();
#ifdef SEDS_FIRMWARE_SIM_TEST
            sample_sdk_queue_budget();
#endif
            last_stack_sample = now;
        }

        wait_for_telemetry_work(poll_ticks, CAN_TX_REFUSALS() != can_rejected);
    }
}

UINT create_telemetry_thread(TX_BYTE_POOL *byte_pool)
{

    CHAR *pointer;

    /* Allocate the stack for test  */
    if (tx_byte_allocate(byte_pool, (VOID **)&pointer,
                         TELEMETRY_THREAD_STACK_SIZE, TX_NO_WAIT) != TX_SUCCESS)
    {
        return TX_POOL_ERROR;
    }

    /* Discovery/queue work can span an acquisition deadline. Let acquisition
     * preempt it and share a bounded slice with the other I/O workers. */
    UINT status = tx_thread_create(&telemetry_thread,
                                   "Telemetry Thread",
                                   telemetry_thread_entry,
                                   0,
                                   pointer,
                                   TELEMETRY_THREAD_STACK_SIZE,
                                   DAQ_IO_THREAD_PRIORITY,
                                   DAQ_IO_THREAD_PRIORITY,
                                   (TX_TIMER_TICKS_PER_SECOND * DAQ_IO_THREAD_SLICE_MS + 999U) / 1000U,
                                   TX_AUTO_START);

    return status;
}
