University-at-Buffalo-SEDS/DAQ-Board/Core/Src/board_health.c

#include "board_health.h"
#include "board_temperature.h"
#include "board_uptime.h"
#include "board_watchdog.h"
#include "telemetry.h"
#include "main.h"
#include "sd_card.h"
#include <stdint.h>
#include <stdbool.h>
#if __BYTE_ORDER__ != __ORDER_LITTLE_ENDIAN__
#error "Board diagnostic words require little-endian encoding"
#endif
#ifdef TELEMETRY_USE_TLSF
extern volatile uint32_t g_telemetry_tlsf_live_bytes, g_telemetry_tlsf_peak_bytes, g_telemetry_tlsf_region_bytes, g_telemetry_tlsf_failures;
#endif
extern uint32_t board_health_can_rx_drops(void);
extern int telemetry_router_enter(void);
extern int telemetry_router_leave(void);
#if !defined(DISABLE_SD_CARD) || DISABLE_SD_CARD == 0
extern volatile uint32_t g_sd_raw_records_enqueued_count, g_sd_raw_records_written_count, g_sd_raw_records_dropped_count, g_sd_raw_records_flushed_count, g_sd_raw_records_io_lost_count, g_sd_write_error_count, g_sd_max_write_ms;
#endif
extern uint32_t board_health_adc_overruns(void);

void board_health_poll(SedsRouter *router)
{
#ifdef TELEMETRY_ENABLED
  static uint32_t last_report_ms;
  static uint32_t failures;
  if (!router) return;
  const uint64_t uptime = board_uptime_ticks();
  const uint32_t now = (uint32_t)uptime;
  if ((uint32_t)(now - last_report_ms) < 5000U) return;
  last_report_ms = now;

  uint32_t words[24] = {1U, 2U, (uint32_t)uptime, (uint32_t)(uptime >> 32U), BOARD_UPTIME_FREQUENCY_HZ};
  const uint32_t saved = __get_PRIMASK(); __disable_irq();
  words[5] = g_watchdog_reset_flags; words[6] = g_watchdog_missing_mask;
#ifdef TELEMETRY_USE_TLSF
  /* Exact existing occupied-byte counters. Avoid interrupt-disabled heap
   * walks, and do not mislabel occupied headroom as contiguous free space. */
  words[1] |= 1U;
  words[7] = g_telemetry_tlsf_live_bytes; words[8] = g_telemetry_tlsf_peak_bytes;
  words[9] = g_telemetry_tlsf_region_bytes; words[10] = g_telemetry_tlsf_failures;
#endif
  words[12] = board_health_can_rx_drops();
#if !defined(DISABLE_SD_CARD) || DISABLE_SD_CARD == 0
  words[1] |= 16U | 128U;
  words[16] = g_sd_raw_records_enqueued_count; words[17] = g_sd_raw_records_written_count;
  words[18] = g_sd_raw_records_dropped_count + g_sd_raw_records_io_lost_count; words[19] = g_sd_raw_records_flushed_count;
  words[20] = g_sd_write_error_count; words[21] = g_sd_max_write_ms;
#endif
  words[1] |= 32U; words[22] = board_health_adc_overruns();
  __set_PRIMASK(saved);
  words[11] = (uint32_t)seds_memory_admission_rejected();
  words[23] = failures;
  words[1] |= board_temperature_health_flags();
  if (!telemetry_router_enter()) { ++failures; return; }
  /* Static UInt32 schema + exact little-endian bytes: use the existing
   * bounded byte path without pulling every generic numeric converter in. */
  const SedsResult result = seds_router_log_bytes_ex(router, SEDS_DT_BOARD_HEALTH,
      (const uint8_t *)words, sizeof(words), NULL, true);
  const int released = telemetry_router_leave();
  if (result != SEDS_OK || !released) ++failures;
#if !defined(DISABLE_SD_CARD) || DISABLE_SD_CARD == 0
  uint32_t sd_words[8]; sd_card_health_snapshot(sd_words);
  if (!telemetry_router_enter()) { ++failures; return; }
  (void)seds_router_log_bytes_ex(router, SEDS_DT_DAQ_SD_HEALTH,
      (const uint8_t *)sd_words, sizeof(sd_words), NULL, true);
  if (!telemetry_router_leave()) ++failures;
  uint32_t launch_words[7]; sd_card_launch_log_snapshot(launch_words);
  if (!telemetry_router_enter()) { ++failures; return; }
  (void)seds_router_log_bytes_ex(router, SEDS_DT_DAQ_LAUNCH_LOG_STATUS,
      (const uint8_t *)launch_words, sizeof(launch_words), NULL, true);
  if (!telemetry_router_leave()) ++failures;
#endif
#else
  (void)router;
#endif
}
