University-at-Buffalo-SEDS/DAQ-Board/(commit log)

2026-02-19 enable usb interrupt
2026-03-18 added some drivers and a sketch for the MCP3564R driver. also added task structure for external and internal logging.
2026-03-19 change board name
2026-03-23 enable dma for external adc
2026-04-06 name fixes for daq board
    [DAQ-Board.ioc]
2026-04-12 can bus config
2026-04-13 relinquish the thread don't sleep
2026-04-13 better thread yielding and removed dupicate prototype
2026-05-02 sleep the thread
2026-05-07 working can bus
2026-05-09 daq driver fixes
2026-05-09 working daq driver
2026-05-09 adc changes
2026-05-09 more adc async impovments
2026-05-09 timer based dma
2026-05-09 timer dma driver
2026-05-11 switch muxes
2026-05-11 fix the adc
2026-08-27 Pin LaunchCore merged mainline
2026-08-28 fix: make LaunchCore factory images bootable
    [board_config.h, build.py, test_build_script.py]
2026-08-28 fix: accept expected DFU leave disconnect
    [build.py, test_build_script.py]
2026-08-28 fix: stream DFU upload progress
    [build.py, test_build_script.py]
2026-08-28 fix: preserve DFU carriage returns
    [build.py, test_build_script.py]
2026-08-28 fix: hide expected DFU reset status
    [build.py, test_build_script.py]
2026-08-28 build: pin SEDSNet main
2026-08-29 Fix DAQ startup and simulation hardware model
    [app_threadx.c, main.c, sd_card.c, sd_card.h]
2026-08-29 Fail fast when Docker is unavailable
    [build.py, test_build_script.py]
2026-08-29 Build simulator locally when registry image is missing
    [test_build_script.py]
2026-08-29 Fix cross-platform simulator image resolution
    [test_build_script.py]
2026-08-30 Migrate board simulation to v0.2.0
2026-08-30 fix include capitalization error
    [telemetry.c]
2026-08-30 test: add comprehensive board test reporting
2026-08-31 fix simulator execution and progress
    [test_build_script.py, test_qualification_contract.py]
2026-08-31 track latest firmware simulator image
2026-08-31 fix LaunchCore application handoff
    [test_launchcore_handoff.py]
2026-08-31 avoid topology allocation in health polling
    [telemetry.c, test_qualification_contract.py]
2026-08-31 fix: restore fill CAN and fragment flow
    [DAQ-Board.ioc, can_bus.c, main.c, test_can_hardware_contract.py]
2026-09-01 Fix routed SEDSNet communication and full-bay validation
    [DAQ-Board.ioc, build.py, can_bus.c, main.c, sim_network_probe.h, telemetry.c, test_build_script.py]
2026-09-02 Profile telemetry thread stack margin
2026-09-02 Pin SEDSNet discovered-route fix
2026-09-04 Relay SEDSNet variable refreshes to owners
2026-09-05 Bound isolated CAN trace memory
2026-09-05 Expect fail-safe abort during simulated power loss
2026-09-05 Assert planned fail-safe at final network sample
2026-09-07 Pin safe incremental discovery
2026-09-08 Update DAQ board to SEDSNet v4.0.20
2026-09-08 Prevent flight-state polling from blocking telemetry
    [flight_state_cache.c, test_flight_state_persistence.py]
2026-09-11 checkpoint firmware networking, configurable telemetry and qualification fixes
    [DAQ-Board.ioc, app_threadx.c, build.py, can_bus.c, daq_adc1.c, daq_board.c, daq_board.h, daq_calibration.c]
2026-09-15 fix firmware qualification and pin sedsnet 4.0.28 and simulator 0.4.11
    [DAQ-Board.ioc, can_bus.c, daq_downsample.h, daq_thread.c, main.c, sd_card.c, sd_hal_limits.h]
2026-09-15 pin sedsnet v4.0.29 ack routing release
2026-09-15 fix: wait for SD programming and preserve partition boot offsets
    [sd_card.c, test_sd_partition_driver.py, test_sd_polling_io.py]
2026-09-15 fix: enable DAQ SDMMC flow control for polling transfers
    [DAQ-Board.ioc, main.c, test_sd_polling_io.py]
2026-09-15 fix: set DAQ SD volume label without reformatting provisioned cards
    [sd_card.c, test_sd_startup.py]
2026-09-15 separate raw ADC and telemetry logs with independent calibration rotation
2026-09-16 qualify state recovery and pin SEDSNet v4.0.31 for hardware testing
2026-09-16 track SEDSNet main with validated v4.0.32 recovery
2026-09-19 add independent 50 kg load-cell acquisition and calibration
2026-09-21 Increase loadcell reporting target to 500 Hz
2026-09-21 fix SD log sessions and persist launch timing across reconnects
    [daq_log_clock.c, daq_log_clock.h, daq_thread.c, sd_calendar.h, sd_card.c, sd_card.h, sedsnet_config.h, telemetry.c]
2026-09-22 Add ADC temperature compensation and calibrated load-cell filtering
2026-09-22 fix boot flash reads, temperature acquisition, and SD buffering
    [daq_rates.h, daq_thread.c, fx_user.h, mcp3564r.c, mcp3564r_board_config.h, sd_card.c, sd_writer_thread.c, storage_internal_flash.c]
2026-09-24 add schematic-mapped analog acquisition and telemetry
    Expose SAR, auxiliary MCP, current-sense and supply-monitor channels with fixed wire IDs and SD records. Run slow reporting in a bounded worker to protect load-cell acquisition. Document mapping, calibration limits and the existing simulator startup-overrun qualification failure.
    [DAQ-Board.ioc, daq_adc1.c, daq_adc1.h, daq_adc4.c, daq_board.c, daq_board.h, daq_rates.h, daq_thread.c]
2026-09-25 decouple DAQ reporting and default loadcells to 250 Hz
2026-10-02 Track SEDSnet main with automatic offline source fallback
2026-10-03 Add board-owned task-progress hardware watchdog
2026-10-05 Support TLSF builds and correct watchdog startup defaults
    [board_watchdog.c, build.py, telemetry.c, telemetry_hooks.c, telemetry_tlsf.c, telemetry_tlsf.h, test_board_watchdog.py, test_build_allocator.py]
2026-10-16 validate linked transport timing and simulator probes
2026-10-16 qualify both Pico transports with isolated settings and latency bounds
2026-10-16 default linked qualification to Pico Ethernet TCP
2026-10-19 preserve raw SD samples and qualify network recovery
2026-10-21 keep embedded crc selection on the board implementation
2026-10-21 allow bounded DAQ discovery bursts without publication refusal
    Raise the logical queue ceiling from 12 to 16 KiB, keeping the allocator pool and sampling rate unchanged. Preserve the first simulator publication refusal in existing diagnostics.
    Validation: 186 unit tests, macOS factory build and strict 120-second all-board Ethernet qualification pass. Sustained qualification remains pending.
2026-10-21 use corrected simulator models for board qualification
2026-10-23 record source-timed pressure batches without starving telemetry
2026-10-25 update queue saturation harness for current SDK errors
2026-10-25 Let time-sync holdover yield to returning RF and GroundStation sources
2026-10-25 Keep allocator diagnostics warning-free across TLSF and ThreadX
2026-10-28 keep battery report delivery consistent across discovery peers
2026-10-29 Match simulator DAQ observers to current publication cadence
2026-10-29 add chamber pressure telemetry and durable launch logging
2026-10-30 enable HVAIN1 chamber pressure with settled ADC scans
2026-10-30 service ADC data-ready interrupts with SPI DMA
    Wire PB10 EXTI to bounded asynchronous ADC reads, validate conversion status, and recover stalled DMA from the acquisition thread. Keep DMA buffers in startup-zeroed internal SRAM and preserve loadcell, chamber pressure, and SD paths.
2026-10-30 Finish chamber pressure scan before switching to P6 gain
2026-10-30 Accept valid ADC status and preserve chamber CAN delivery
2026-10-30 Batch SD records and reserve capacity for loadcells and pressure
2026-10-31 Fix direct DAQ sensor plots and expose SD write health
2026-10-31 Isolate live DAQ telemetry from SD allocation and transfer stalls
2026-10-31 include OX tank pressure in main DAQ launch recordings
2026-11-01 add verified startup state reset and board status queries
2026-11-01 retain valve pressure capture across discovered sender identities
2026-11-02 suppress chamber pressure below 4.5 psi
2026-11-03 Defer DAQ state persistence without blocking network recovery
    Keep volatile state application responsive during flash contention, retain original SDK retry identity, and require current durable proof before completing Startup recovery. Track in-flight logging ownership without enabling the new thermal transaction service.
    Exact reviewed source passes all 327 native tests with zero skips, three GoogleTests and both ARM configurations. Fleet, flash RWW and complete SD-writer stack qualification remain separate.
2026-11-07 Persist the 50 kg input selection across DAQ reboots
2026-11-08 Project samples drained after the clock read forward in time
    The acquisition loop reads its uptime/UTC pair once, then keeps draining
    samples that arrive during the loop. board_uptime_project treated such a
    newer 32-bit capture tick as a wrapped, 49-day-old capture and returned 0,
    so the row's network timestamp became UTC minus the whole uptime (seen as
    a chamber row stamped T-177.9 s in the launch file). Project newer
    captures forward, and date a sample after the clock pair by its offset.
2026-11-08 Log one regular file per session and one file per launch window
    The SD writer kept raw ADC rows and telemetry rows in two handles, and
    the telemetry handle was keyed on each row's launch session. While a
    launch session was active (from the launch command), VB pressure rows
    captured outside [T0, T+20 s) were routed with session 0 and every
    other telemetry row with the launch session, so each 4-sample pressure
    batch closed and reopened the telemetry file (sd_write_telemetry_row).
    Each switch flushed, truncated, closed, scanned the growing directory,
    created and preallocated a new file and flushed its header on the only
    writer thread, so the raw queue overflowed: a simulated test fire kept
    5-10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
2026-11-08 Shed optional raw rows only after a worst-case SD busy stall
    The optional-channel guard shed rows once the raw backlog exceeded 256
    records (about 70 ms at the ADC rate), so ordinary file creation,
    preallocation or FAT updates dropped a ch2-ch7 group at boot and during
    normal running, leaving raw sequence gaps. Admit optional rows until the
    backlog covers 500 ms at the full ADC rate (the SD specification's SDXC
    write timeout; 250 ms for SDSC/SDHC); the quarter-pool reserve for
    essential channels is unchanged and a static assert keeps the budget
    within half the raw pool.
2026-11-09 Recover without a synced network clock and never hold a board on a refused reset
    The Actuator Board bench showed a network clock reading about the board's own
    uptime, so every GS QUERY looked stale and RECOVER was refused. SEDSnet's
    disciplined clock takes its first announce as an anchor and afterwards only
    slews at 5%; the verified request/response exchange that could step it does
    not complete for a consumer behind a relay. A source with no real time, such
    as an RF board without a GPS fix, announces its uptime, so a board that heard
    such an announce first keeps an uptime-like clock. This board shares the same
    commissioning transport and network clock, so the same failure applied.
    Freshness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
2026-11-09 Find the configured LaunchCore in the recovery tests without an override
    The station-clock and recovery transport tests read SDK_FREE_LAUNCHCORE_SOURCE
    directly. A normal build.py test run does not set it, so both errored. Port
    configured_dependency_source from the other boards' native_sdk.py so the tests
    use the LaunchCore the firmware configure fetched; the override stays optional.
    Test-only; the firmware image is unchanged.
2026-11-09 Pace network clock restarts to one per 30 s of ticks
    Bench (SEDSnet 4.3.14): when a board's time source disagreed with the GS
    clock by more than 60 s (about 607 s on the bench), the station-clock check
    restarted SEDSnet timesync on every GS heartbeat once the clock re-anchored.
    A restart cannot fix a source that keeps disagreeing, and repeating it kept
    the network clock invalid almost all the time, so data were stamped with
    uptime. The Valve Board's valve-state reports stopped entirely this way.
    A restart now waits at least 30 s of ThreadX ticks after the previous one
    (wrap-safe; the first restart is immediate). The station-clock rule and
    its 60 s threshold are unchanged.
    The new test mode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
2026-11-09 Acknowledge reliable packets the DAQ refuses instead of failing them
    SEDSnet 4.3.14 withholds the end-to-end ACK when a receive callback fails,
    forgets the packet so it reruns on the next copy, and for a network-variable
    callback aborts RX before the hop ACK and any relay. A deterministic refusal
    (stale, not the station, malformed, invalid) can never succeed on a
    retransmit, so the sender repeated it for its whole retry budget.
    These refusals now return SEDS_OK, are never applied, and are counted in the
    new g_reliable_refusal_count:
    - FLIGHT_STATE network variable: malformed, or not allowed (stale, unready,
    not the station). The SDK cache observation is still retired.
    - BOARD_RECOVERY_REQ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
2026-11-09 Apply every 50 kg input selection the station delivers
    The station owns DAQ_KG50_INPUT and re-sends it while the DAQ reports
    another input. SEDSnet drops, yet acknowledges, a managed value stamped
    older than the one cached from the same sender, before any callback runs.
    The station's revision stamps are kept per calibration file (one per
    station mode) and follow its clock, so once the DAQ cached a newer-stamped
    value from "GS" (a stray write, another mode's file, a clock step) every
    later selection was silently ignored until the DAQ rebooted, and the
    station re-sent it every 2 s forever.
    apply_kg50_input now retires the cached observation after applying, so the
    next delivered selection alwa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
2026-11-09 Never attempt zstd payload compression on transmit
    SEDSnet is built with its compression feature, so every payload of 30 B or
    more went through ZSTD_compress. It puts a 3.8 KiB context on the stack and
    then mallocs a workspace of at least 18.9 KiB from the newlib heap, which
    here has 1,864 B free. Every attempt failed and the payload went out
    uncompressed anyway, after about 4.5 KiB of the router thread's stack.
    Set the runtime payload compression threshold to SIZE_MAX before the router
    is created, as RF does. Receiving is unchanged.
2026-11-10 Acknowledge an applied FLIGHT_STATE even when flash or the OTA owner is busy
    FLIGHT_STATE is the DAQ's only Abort path. After the value was applied,
    persist_update still returned SEDS_IO (store owner busy) or
    SEDS_HANDLER_ERROR (write failure, storage not ready), and refused the
    write outright when the OTA owner was busy. The SDK then withholds the
    end-to-end receipt, so the station's ordered FLIGHT_STATE stream stalls
    behind that write and newer writes, Aborted among them, wait behind it.
    An applied value now returns SEDS_OK and stays persist-pending. The OTA
    owner is a permit for the flash write, not a refusal: its inhibition is
    applied either way. flight_state_cache_poll retries the owne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
2026-11-10 Keep the unit suite clean from a fresh checkout under any directory name
    test_ota_lifecycle_native chose the DAQ fixture with ROOT.name ==
    'DAQ-Board', so any worktree or clone under another name failed to link
    (persistent_store_try_enter undefined). It now reads the board name from
    sim/board.json, and a guard test keeps tests from keying on the checkout
    directory name.
    The native tests take LaunchCore from a configured build's FetchContent
    cache. ./build.py test now configures once (no build) when no such cache
    exists, so a fresh checkout passes without a manual build first.
2026-11-10 Acknowledge an applied DAQ calibration even when its flash write fails
    apply_calibration wrote flash before applying and returned
    SEDS_HANDLER_ERROR when storage was not ready or the write failed. The SDK
    then withholds the end-to-end receipt, so the station's ordered
    calibration stream stalls behind that write and newer values wait
    behind it.
    A valid calibration is now applied, acknowledged and persist-pending.
    daq_calibration_poll retries storage initialization and the write on
    every second tick of its existing 500 ms timer, so at most once per
    second; the one-byte pending counter sits in existing padding and RAM is
    unchanged. Failures count in g_daq_calibration_errors. Refused values and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
2026-11-10 Keep SD logging running while CAN refuses telemetry
    With CAN unacknowledged the SDK keeps the frames the CAN TX queue refuses,
    so seds_router_has_queued_work stays positive. The telemetry thread
    (priority 6) then ran four 1 ms queue passes per wakeup, relinquishing only
    to its own priority, and the SD writer (priority 7) starved: the three
    optional snapshot slots stayed full and 24 rows were dropped every sample
    (sd_line_drops 0, 24, 48, 72, 96 in the disconnected-CAN simulation; also
    on 5120c90). The local record was lost exactly when the network link was
    down.
    A pass during which the CAN TX queue refused a submission now sleeps one
    poll interval instead of relinquishing. In the same simul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
2026-11-10 Push one BOARD_STATE_STATUS to the station when FLIGHT_STATE becomes Aborted
    The station learns a board's Abort from its ordered recovery QUERY, which
    can wait behind a radio query, so an applied Abort could stay unseen for
    the whole query round. An applied FLIGHT_STATE change to Aborted (15) now
    pushes exactly one unsolicited status from the cache callback: the
    existing 40-byte commissioning status record on the existing
    seds_router_log_queue_typed path, with nonce 0, ABORT_LATCHED, the abort
    epoch, the QUERY reply's generation, the board uptime and the issuer of
    the last valid station QUERY (0 before the first one). A repeated Aborted
    write, a restored Aborted state and other states push n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
2026-11-11 Write SD logs in sector-aligned blocks so the writer keeps up with 2410 records/s
    The bench writer saturated at about 1.7k raw records/s with the raw pool full.
    The limit was SD command latency, not CPU: about 4.1k M33 instructions encode
    and copy one row, but every 4 KiB batch ended mid-sector, so FileX issued a
    partial-sector read, a head-sector write, at most 7 direct sectors and a later
    out-of-order tail write. That is about 2.3 commands of 4.1 sectors per batch,
    each bounced through the 8-sector IDMA buffer and rounded up to whole ticks of
    CMD13 polling.
    Each open log now stages rows in a 16 KiB buffer, aligned to 32 bytes. A full
    buffer is written up to its last sector boundary. If a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
2026-11-11 Add a DWT cycle profile of the SD writer behind DAQ_SD_PROFILE
    This is for bench use only. Configure with -DDAQ_SD_PROFILE=ON to time the
    following with DWT CYCCNT into g_sd_profile, which is read over SWD:
    - raw encode;
    - fx_file_write;
    - each storage command (command, transfer and busy wait);
    - the whole-tick CMD13 busy-poll sleeps;
    - the periodic sync.
    These deltas show whether the writer waits on the card or on the CPU, and how
    much card busy time is rounded up to ThreadX ticks.
    docs/sd-write-path.md gives the bench procedure and the derived figures. Normal
    builds compile the hooks away: the release image and the unit tests are
    unchanged.
2026-11-11 Take network FLIGHT_STATE as contract set (a): one Fill, and InFlight 16
    Only 0 Startup, 1 Idle, 2 Fill, 6 Armed, 7 Launch, 13 Landed, 15 Aborted and
    16 InFlight are ever on the wire. The fill sub-phases are the station's own,
    and the FC sends its Ascent through Reefing as InFlight.
    - Accept InFlight (16). The cache bound was 15, so the board refused it and
    the station retransmitted it forever.
    - Map a retired value from older firmware on receipt: 3..5 to Fill, 8..12 to
    InFlight, 14 to Landed. Count each one and log the first once (raw value),
    and acknowledge it. A value restored from flash maps the same way.
    - The schema documents the set (a) values.
    The DAQ still serves SD files in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
2026-11-11 Erase the persistent store on a factory flash, and prove it survives churn
    Factory flash did not erase the LaunchCore store, so records from an older
    flash layout survived into a new image and could block compaction (bench,
    2026-11-10: a stale record left the FC refusing every command).
    - `build.py flash` now erases the store with a factory image by default.
    `--keep-persist` keeps it; `--erase-persist` erases it with an app-only
    image. stm32prog-cli erases only the store pages, before writing.
    st-flash 1.8.0 or newer erases only the store range; an older st-flash is
    refused rather than erasing the chip. dfu cannot erase a page range, so it
    mass-erases the chip before writing the f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
2026-11-11 Refuse a local simulator image that predates the U5 factory boot budget
    The DAQ firmware simulation failed on dev with "factory boot flow never
    reached _tx_thread_schedule". It also failed on 1bcf09e and 4dbee80, where an
    earlier "probe ... returned 9 of 10 samples" failure hid it.
    The firmware is not at fault. ghcr has no :dev tag, so the runner falls back to
    the reused local tag seds-firmware-simulator:local-dev-v0.4.15. On this host,
    that image was built at 2026-11-09 17:50 -0500, before two FirmwareSimulator
    changes:
    - 79f98f5 gives a U5 factory flash 500 ms to provision blank storage. The old
    image stops it at 50 ms, inside LaunchCore strict_erased/memcpy.
    - 12f3b71 frames each probe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
2026-11-12 Deliver board status, underglow, buzzer, warnings and errors without ordering
    BOARD_STATE_STATUS, AV_BAY_UNDERGLOW, FLIGHT_BUZZER, WARNING and
    GENERIC_ERROR go Unordered, as in the station's schema. The whole stack is
    flashed together, so every board carries the same definitions.
